calebynhan/mcring/hardware/cad/fit_report.md

# mcring stage-1 enclosure — fit report

Generated by `mcring_stage1.py` from `hardware/pcb/board_params.json` (inner_d = 20.0 mm, lens_d = 4.6 mm). Result: **PASS** (intersections all 0, clearances ok, wall probes ok).

The wall probes are line samples at the places listed below, not a global thickness analysis. Known spots thinner than the 1.2 mm wall rule, by design: the 0.4 / 0.7 mm rebate rim under the lid detent groove, the 0.7 mm wall around the switch key's counterbore, the first ~1.3 mm of each wire channel where it leaves the open groove at the slab's bottom corner, the floor beside the charging-wire groove where it skims the cell- and LRA-pocket rims, the 0.8 mm resin over the touch pad, and the 1.0 mm speaker grille plate (the pocket's +Y face, 5 × Ø1.0 holes).

## Stack (Z above the finger skin, mm)

| level | z |
|---|---|
| pocket floor (band wall) | 1.20 |
| sub-board floor (cell pocket top) | 4.60 |
| board bottom (ledges) | 6.10 |
| board top | 6.70 |
| lid underside | 9.90 |
| lid top | 11.10 |
| pod underside (bore relief 0.5) | 0.50 |
| pod floor | 1.70 |
| OV2640 head bottom / top | 2.00 / 10.50 |
| lens axis | 6.25 |
| pod ceiling (head top + FPC fold) | 11.50 |
| pod roof top | 12.70 |
| speaker pocket bottom (slab bottom + 1.3) | -1.70 |
| speaker axis | 3.50 |
| speaker rim top / lid boss underside | 8.50 / 8.70 |
| speaker slot top = bump shelf = lid underside | 9.90 |

## Speaker LS1 (optional, `speaker_mm`)

* part: PUI Audio AS01008MR-2-R — Ø10 x 2.9 mm max, 8 Ω, 300 mW rated / 500 mW max, 86 dB, top port, NdFeB magnet, solder-pad terminals (netlist LS1, off-board; alt. any 10 mm 8 Ω micro speaker); its two leads end in a Pico-EZmate plug; placeholder Ø10.0 × 2.9 mm disc standing in the XZ plane, axis along Y, centre board (18.45, 24.8, -3.2 from the board top) = world X -5.20, Y 13.40, Z 3.50 above the skin; rim Z -1.50..8.50 above the skin, back face Y 11.95 (+0.25 from the bay's inner wall plane), front face Y 14.85
* pocket: U-slot Ø10.4 (0.2 radial clearance) about the axis, straight walls above the axis up to the lid underside (drop-in from the top), depth 3.2 along Y (0.1 behind the back face, 0.2 in front); X -10.4..0.0, Y 11.85..15.05, bottom -1.70 above the skin (1.3 above the slab bottom)
* +Y wall bump: 3.15 mm over X -11.6..1.2 (12.8 long = pocket + two 1.2 end walls), full slab height, top cut down to the lid underside (shelf); the signet is 28.95 wide there (asymmetric: +Y side only); outer corners r 1.0, bottom edge r 0.6
* grille: 5 × Ø1.0 holes (centre + 4 on a Ø5 ring at 45°) through the 1.0 mm +Y plate = 3.9 mm² open (5 % of the Ø10 disc)
* back volume: above the sub-board floor (4.60) the slot's back is open to the bay over its full width, so the lidded bay (~1.4 cm³ minus parts) is the back volume and the terminals/leads pass straight through; below the floor the pocket is a recess in the solid slab with a lead groove 6 wide × 1.0 deep in its back wall (Y 10.85..11.85, Z -0.7..floor) for terminals in the lower half of the disc
* leads: the speaker's pigtail (two 28 AWG wires ending in a Pico-EZmate plug) leaves the back terminals into the sub-board cavity (Z 4.6..6.1 above the skin, under the board's +Y edge), runs ≈ 3.4 mm to the J5 edge notch at board x 21.8 and climbs the wall gap to the J5 header on the board top (allow 10 mm)
* lid: tab X -11.3..0.9 × Y 12.05..15.90 (1.2 thick, 0.15 inside the bump face, 0.3 from the bump's end walls) rests on the shelf; boss X -10.1..-0.3 × Y 12.15..14.75 under it fills the slot down to 8.70 above the skin = 0.2 mm above the speaker rim (the lid holds the speaker; a foam pad or a drop of glue takes up the play). The +Y detent groove is interrupted over the bump (X -11.6..1.2).
* antenna: 3-D gap speaker ↔ flex antenna placeholder 6.73 mm (keep-out 5.0); mass +1.0 g speaker

## Plug-in connectors (`connectors_top_mm`, `edge_notches_mm`)

The owner solders nothing: the cell, the charging-pad pigtail, the LRA and the speaker plug into four Molex Pico-EZmate headers on the board TOP (right strip), and each pigtail drops through a notch in the board's right edge into the sub-board cavity. Checked here: the mated plug + wire bend (placeholder `plugs`) clears the lid, the mic tube and the wall; the wall gap beside each notch is open from plug height to the floor; the cell lead channel and the charging-wire floor groove are open along their length and keep >= 1.2 mm of floor under them.

| header | feeds | header centre (board x, y) | notch (board x, right edge) | plug/bend envelope (world X, Y, Z) | wire path |
|---|---|---|---|---|---|
| J4 (LRA) | LRA M1 (Ø8 x 2.5 in the floor pocket under the front-right of the board) | 7.65, 19.45 | x 7.65, 2.4 x 1.1 | X 4.30..6.90, Y 10.30..11.65, Z 6.70..8.25 above the skin | LRA pocket at X 7.8, Y 3.5 -> +Y under the board edge -> notch |
| J3 (CHG) | charging-pad pigtail to the two inner-band contacts CP1/CP2 (floor wire groove from the -y channel exits) | 12.4, 19.45 | x 12.4, 2.4 x 1.1 | X -0.45..2.15, Y 10.30..11.65, Z 6.70..8.25 above the skin | two Ø1.1 channels from the band ribs surface beside the -Y wall, then the 1.2 x 0.8 floor groove (3 legs) to the notch |
| J1 (BAT) | cell BT1 (301012, tabs toward +y, lead channel from the pocket's +y edge) | 17.1, 19.45 | x 17.1, 2.4 x 1.1 | X -5.15..-2.55, Y 10.30..11.65, Z 6.70..8.25 above the skin | cell tabs toward +Y, 3 x 0.8 lead channel from the pocket's +Y edge to the wall at X -3.85 |
| J5 (SPK) | speaker LS1 in the right-wall pocket (its back is open to the bay above the floor) | 21.8, 19.45 | x 21.8, 2.4 x 1.1 | X -9.85..-7.25, Y 10.30..11.65, Z 6.70..8.25 above the skin | speaker pocket (right wall, back open to the bay above the floor) -> cavity -> notch |

**Charging pigtail (W2) wire runs** along the modelled path, window centre → mated J3 plug, no slack (band rib groove + slab channel + floor groove + climb up the notch to the header top):

* -Y pad (rib A): 21.4 + 7.8 + 27.6 + 4.5 = **61.3 mm**
* +Y pad (rib B, round the bottom): 31.6 + 7.8 + 29.6 + 4.5 = **73.5 mm**

Cut W2 to **≥ 85 mm per wire** (longest run + 10 mm for the bend into the plug and the trim at the window). Half of a 100 mm 36920-0201 (≈ 50 mm) does not reach; half of a 300 mm 36920-0203 (≈ 150 mm) does.

## Placeholder vs shell / lid intersection volumes (mm³, must be 0)

| placeholder | ∩ shell | ∩ lid |
|---|---|---|
| PCB | 0.0000 | 0.0000 |
| module | 0.0000 | 0.0000 |
| camera | 0.0000 | 0.0000 |
| FPC1 | 0.0000 | 0.0000 |
| camera_FPC | 0.0000 | 0.0000 |
| cell | 0.0000 | 0.0000 |
| LRA | 0.0000 | 0.0000 |
| switch | 0.0000 | 0.0000 |
| key | 0.0000 | 0.0000 |
| LED | 0.0000 | 0.0000 |
| mic | 0.0000 | 0.0000 |
| bottom_parts | 0.0000 | 0.0000 |
| top_parts | 0.0000 | 0.0000 |
| plugs | 0.0000 | 0.0000 |
| antenna | 0.0000 | 0.0000 |
| pigtail | 0.0000 | 0.0000 |
| speaker | 0.0000 | 0.0000 |
| lid ∩ shell | 0.0000 | — |

## Placeholder pairs (mm³, must be 0)

| a | b | ∩ |
|---|---|---|
| PCB | module | 0.0000 |
| PCB | camera | 0.0000 |
| PCB | FPC1 | 0.0000 |
| PCB | camera_FPC | 0.0000 |
| PCB | cell | 0.0000 |
| PCB | LRA | 0.0000 |
| PCB | switch | 0.0000 |
| PCB | key | 0.0000 |
| PCB | LED | 0.0000 |
| PCB | mic | 0.0000 |
| PCB | bottom_parts | 0.0000 |
| PCB | top_parts | 0.0000 |
| PCB | plugs | 0.0000 |
| PCB | antenna | 0.0000 |
| PCB | pigtail | 0.0000 |
| PCB | speaker | 0.0000 |
| module | camera | 0.0000 |
| module | FPC1 | 0.0000 |
| module | camera_FPC | 0.0000 |
| module | cell | 0.0000 |
| module | LRA | 0.0000 |
| module | switch | 0.0000 |
| module | key | 0.0000 |
| module | LED | 0.0000 |
| module | mic | 0.0000 |
| module | bottom_parts | 0.0000 |
| module | top_parts | 0.0000 |
| module | plugs | 0.0000 |
| module | antenna | 0.0000 |
| module | pigtail | 0.0000 |
| module | speaker | 0.0000 |
| camera | FPC1 | 0.0000 |
| camera | camera_FPC | 0.0000 |
| camera | cell | 0.0000 |
| camera | LRA | 0.0000 |
| camera | switch | 0.0000 |
| camera | key | 0.0000 |
| camera | LED | 0.0000 |
| camera | mic | 0.0000 |
| camera | bottom_parts | 0.0000 |
| camera | top_parts | 0.0000 |
| camera | plugs | 0.0000 |
| camera | antenna | 0.0000 |
| camera | pigtail | 0.0000 |
| camera | speaker | 0.0000 |
| FPC1 | camera_FPC | 0.0000 |
| FPC1 | cell | 0.0000 |
| FPC1 | LRA | 0.0000 |
| FPC1 | switch | 0.0000 |
| FPC1 | key | 0.0000 |
| FPC1 | LED | 0.0000 |
| FPC1 | mic | 0.0000 |
| FPC1 | bottom_parts | 0.0000 |
| FPC1 | top_parts | 0.0000 |
| FPC1 | plugs | 0.0000 |
| FPC1 | antenna | 0.0000 |
| FPC1 | pigtail | 0.0000 |
| FPC1 | speaker | 0.0000 |
| camera_FPC | cell | 0.0000 |
| camera_FPC | LRA | 0.0000 |
| camera_FPC | switch | 0.0000 |
| camera_FPC | key | 0.0000 |
| camera_FPC | LED | 0.0000 |
| camera_FPC | mic | 0.0000 |
| camera_FPC | bottom_parts | 0.0000 |
| camera_FPC | top_parts | 0.0000 |
| camera_FPC | plugs | 0.0000 |
| camera_FPC | antenna | 0.0000 |
| camera_FPC | pigtail | 0.0000 |
| camera_FPC | speaker | 0.0000 |
| cell | LRA | 0.0000 |
| cell | switch | 0.0000 |
| cell | key | 0.0000 |
| cell | LED | 0.0000 |
| cell | mic | 0.0000 |
| cell | bottom_parts | 0.0000 |
| cell | top_parts | 0.0000 |
| cell | plugs | 0.0000 |
| cell | antenna | 0.0000 |
| cell | pigtail | 0.0000 |
| cell | speaker | 0.0000 |
| LRA | switch | 0.0000 |
| LRA | key | 0.0000 |
| LRA | LED | 0.0000 |
| LRA | mic | 0.0000 |
| LRA | bottom_parts | 0.0000 |
| LRA | top_parts | 0.0000 |
| LRA | plugs | 0.0000 |
| LRA | antenna | 0.0000 |
| LRA | pigtail | 0.0000 |
| LRA | speaker | 0.0000 |
| switch | key | 0.0000 |
| switch | LED | 0.0000 |
| switch | mic | 0.0000 |
| switch | bottom_parts | 0.0000 |
| switch | top_parts | 0.0000 |
| switch | plugs | 0.0000 |
| switch | antenna | 0.0000 |
| switch | pigtail | 0.0000 |
| switch | speaker | 0.0000 |
| key | LED | 0.0000 |
| key | mic | 0.0000 |
| key | bottom_parts | 0.0000 |
| key | top_parts | 0.0000 |
| key | plugs | 0.0000 |
| key | antenna | 0.0000 |
| key | pigtail | 0.0000 |
| key | speaker | 0.0000 |
| LED | mic | 0.0000 |
| LED | bottom_parts | 0.0000 |
| LED | top_parts | 0.0000 |
| LED | plugs | 0.0000 |
| LED | antenna | 0.0000 |
| LED | pigtail | 0.0000 |
| LED | speaker | 0.0000 |
| mic | bottom_parts | 0.0000 |
| mic | top_parts | 0.0000 |
| mic | plugs | 0.0000 |
| mic | antenna | 0.0000 |
| mic | pigtail | 0.0000 |
| mic | speaker | 0.0000 |
| bottom_parts | top_parts | 0.0000 |
| bottom_parts | plugs | 0.0000 |
| bottom_parts | antenna | 0.0000 |
| bottom_parts | pigtail | 0.0000 |
| bottom_parts | speaker | 0.0000 |
| top_parts | plugs | 0.0000 |
| top_parts | antenna | 0.0000 |
| top_parts | pigtail | 0.0000 |
| top_parts | speaker | 0.0000 |
| plugs | antenna | 0.0000 |
| plugs | pigtail | 0.0000 |
| plugs | speaker | 0.0000 |
| antenna | pigtail | 0.0000 |
| antenna | speaker | 0.0000 |
| pigtail | speaker | 0.0000 |

## Clearances (mm, must be >= minimum)

| what | measured | minimum | ok |
|---|---|---|---|
| OV2640 head bottom -> pod floor | 0.30 | 0.30 | yes |
| OV2640 head top -> pod ceiling (FPC fold space) | 1.00 | 1.00 | yes |
| OV2640 head side -> pod side wall | 0.35 | 0.30 | yes |
| FPC fold top -> pod ceiling | 0.20 | 0.15 | yes |
| FPC vertical run behind the head -> bay interior front wall | 1.60 | 0.30 | yes |
| FPC wide contact end -> bay front wall | 0.10 | 0.05 | yes |
| module/u.FL back face -> antenna cavity back wall | 2.30 | 1.95 | yes |
| u.FL plug top -> lid underside | 0.30 | 0.30 | yes |
| switch key cap stand-off from the signet side (button travel) | 0.30 | 0.25 | yes |
| switch key flange inner face -> plunger tip (gap) | 0.02 | 0.00 | yes |
| speaker LS1 (NdFeB magnet) -> flex antenna, 3-D gap (metal keep-out) | 6.73 | 5.00 | yes |
| speaker LS1 -> u.FL pigtail, 3-D gap | 18.70 | 5.00 | yes |
| speaker LS1 -> cell, 3-D gap (through the slab wall) | 5.95 | 2.00 | yes |
| speaker LS1 -> LRA, 3-D gap | 5.98 | 2.00 | yes |
| speaker rim -> pocket wall (radial) | 0.20 | 0.15 | yes |
| speaker back face -> pocket back wall (below the floor) | 0.10 | 0.05 | yes |
| speaker front -> grille plate | 0.20 | 0.15 | yes |
| speaker top -> lid boss underside | 0.20 | 0.15 | yes |
| lid boss -> slot end walls (X) | 0.30 | 0.20 | yes |
| lid boss -> slot back / grille plate (Y) | 0.30 | 0.20 | yes |
| lid tab -> bump end walls (X) | 0.30 | 0.20 | yes |
| lid tab outer face -> bump face (Y) | 0.15 | 0.14 | yes |

## Wall probes (material thickness along a line through the shell, mm)

| where | measured | minimum | ok |
|---|---|---|---|
| floor under the cell pocket (X=cell centre, Y=0) | 1.20 | 1.20 | yes |
| floor under the cell pocket's back end (X=pocket back+0.3, Y=0) | 1.20 | 1.20 | yes |
| floor under the LRA pocket (centre) | 1.80 | 1.20 | yes |
| band wall at the bottom (X=0) | 1.20 | 1.20 | yes |
| band wall at 100 deg, beside the ribs (X=2) | 1.20 | 1.20 | yes |
| band + rib under the pad-wire groove A (100 deg) | 1.40 | 1.20 | yes |
| bay long wall (+Y, X=3, Z=board top+1) | 1.20 | 1.20 | yes |
| bay long wall rim at the lid groove (+Y, X=3) | 0.40 | 0.35 | yes |
| bay long wall (-Y, X=0, Z=board top+1) | 1.20 | 1.20 | yes |
| bay long wall rim beyond the groove (X=12) | 0.70 | 0.60 | yes |
| bay back wall behind the antenna cavity (Y=0, Z=board top+1) | 1.20 | 1.20 | yes |
| bay front wall beside the pod opening (Y=7) | 1.20 | 1.20 | yes |
| pod side wall (X=18, lens height) | 1.20 | 1.20 | yes |
| pod front wall beside the lens bore (Y=3.5) | 1.20 | 1.20 | yes |
| pod front corner, diagonal (+Y, lens height) | 1.28 | 1.20 | yes |
| pod front corner, diagonal (-Y, lens height) | 1.28 | 1.20 | yes |
| pod floor (X=18, Y=0) | 1.20 | 1.20 | yes |
| pod roof (X=18, Y=0) | 1.20 | 1.20 | yes |
| pod roof lip over the lid's front edge (X=lid edge+0.07, Y=0) | 1.20 | 1.20 | yes |
| pod roof lip + lid, vertical (X=lid edge-0.5, Y=0) | 1.45 | 1.20 | yes |
| wall between the cell pocket and the LRA pocket | 1.48 | 0.80 | yes |
| left wall above the switch counterbore (X=switch) | 1.20 | 1.20 | yes |
| left wall at the switch counterbore, beside the slot | 0.70 | 0.70 | yes |
| lid: mic tube wall, through the tube (lid part) | 1.00 | 0.90 | yes |
| band wall at the face X=-5.3 through the -25 deg pad window angle | 1.20 | 1.20 | yes |
| band wall at the face X=+5.3 through the -25 deg pad window angle | 1.20 | 1.20 | yes |
| band wall at the face X=-5.3 through the +25 deg pad window angle | 1.20 | 1.20 | yes |
| band wall at the face X=+5.3 through the +25 deg pad window angle | 1.20 | 1.20 | yes |
| skin beside wire channel X=-1.5 toward -Y (outer face) at Z=-1.0 | 3.17 | 1.20 | yes |
| skin beside wire channel X=-1.5 diagonal (-Y,-Z, bottom fillet) at Z=-1.0 | 2.19 | 1.20 | yes |
| skin beside wire channel X=-1.5 toward +Y (cell pocket) at Z=-1.0 | 3.43 | 1.20 | yes |
| skin beside wire channel X=-1.5 toward -Y (outer face) at Z=+0.0 | 2.92 | 1.20 | yes |
| skin beside wire channel X=-1.5 diagonal (-Y,-Z, bottom fillet) at Z=+0.0 | 3.47 | 1.20 | yes |
| skin beside wire channel X=-1.5 toward +Y (cell pocket) at Z=+0.0 | 3.43 | 1.20 | yes |
| skin beside wire channel X=-1.5 toward -Y (outer face) at Z=+1.5 | 2.53 | 1.20 | yes |
| skin beside wire channel X=-1.5 diagonal (-Y,-Z, bottom fillet) at Z=+1.5 | 3.60 | 1.20 | yes |
| skin beside wire channel X=-1.5 toward +Y (cell pocket) at Z=+1.5 | 3.03 | 1.20 | yes |
| skin beside wire channel X=-1.5 toward -Y (outer face) at Z=+3.5 | 2.02 | 1.20 | yes |
| skin beside wire channel X=-1.5 diagonal (-Y,-Z, bottom fillet) at Z=+3.5 | 3.02 | 1.20 | yes |
| skin beside wire channel X=-1.5 toward +Y (cell pocket) at Z=+3.5 | 3.43 | 1.20 | yes |
| skin beside wire channel X=-3.5 toward -Y (outer face) at Z=-1.0 | 3.17 | 1.20 | yes |
| skin beside wire channel X=-3.5 diagonal (-Y,-Z, bottom fillet) at Z=-1.0 | 2.19 | 1.20 | yes |
| skin beside wire channel X=-3.5 toward +Y (cell pocket) at Z=-1.0 | 3.43 | 1.20 | yes |
| skin beside wire channel X=-3.5 toward -Y (outer face) at Z=+0.0 | 2.92 | 1.20 | yes |
| skin beside wire channel X=-3.5 diagonal (-Y,-Z, bottom fillet) at Z=+0.0 | 3.47 | 1.20 | yes |
| skin beside wire channel X=-3.5 toward +Y (cell pocket) at Z=+0.0 | 3.43 | 1.20 | yes |
| skin beside wire channel X=-3.5 toward -Y (outer face) at Z=+1.5 | 2.53 | 1.20 | yes |
| skin beside wire channel X=-3.5 diagonal (-Y,-Z, bottom fillet) at Z=+1.5 | 3.60 | 1.20 | yes |
| skin beside wire channel X=-3.5 toward +Y (cell pocket) at Z=+1.5 | 3.03 | 1.20 | yes |
| skin beside wire channel X=-3.5 toward -Y (outer face) at Z=+3.5 | 2.02 | 1.20 | yes |
| skin beside wire channel X=-3.5 diagonal (-Y,-Z, bottom fillet) at Z=+3.5 | 3.02 | 1.20 | yes |
| skin beside wire channel X=-3.5 toward +Y (cell pocket) at Z=+3.5 | 3.43 | 1.20 | yes |
| speaker grille plate between the holes (X=spk, Z=spk+2.5) | 1.00 | 1.00 | yes |
| speaker grille plate between the holes (X=spk+3.5, Z=spk) | 1.00 | 1.00 | yes |
| slab under the speaker pocket (X=spk, Y=spk) | 1.30 | 1.20 | yes |
| bump end wall at the pocket's front (+X) end, speaker axis height | 1.20 | 1.20 | yes |
| bump end wall at the pocket's back (-X) end, speaker axis height | 1.20 | 1.20 | yes |
| bump end wall at the pocket's back (-X) end, slot top (Z=lid underside-0.5) | 1.20 | 1.20 | yes |
| bump bottom-front corner, diagonal from the pocket's front-bottom edge (X=spk) | 1.35 | 1.20 | yes |
| slab between the speaker pocket back and the cell pocket, through the lead groove (X=spk, Z=floor-1.5) | 4.65 | 1.20 | yes |
| slab between the speaker pocket back and the cell pocket, beside the groove (X=spk-4, Z=floor-1.5) | 6.15 | 1.20 | yes |
| slab behind the lead groove's bottom (X=spk, Y=spk back, Z=groove bottom-0.5 .. slab bottom) | 2.30 | 1.20 | yes |
| lid: tab + boss over the speaker (X=spk, Y=spk) (lid part) | 2.40 | 1.20 | yes |
| lid: tab over the bump shelf (X=spk, Y=bump face-0.5) (lid part) | 1.20 | 1.20 | yes |
| floor under the cell lead channel (X=J1, Y=channel mid) | 7.75 | 1.20 | yes |
| floor under wire groove leg 1 (mid-leg, down to the bore / slab bottom) | 6.88 | 1.20 | yes |
| floor under wire groove leg 2 (mid-leg, down to the bore / slab bottom) | 3.75 | 1.20 | yes |
| floor under wire groove leg 3 (mid-leg, down to the bore / slab bottom) | 6.75 | 1.20 | yes |
| pad window A (-Y) open at X=-1.5 (must be 0) | 0.00 | 0.00 | yes |
| pad window B (+Y) open at X=-3.5 (must be 0) | 0.00 | 0.00 | yes |
| speaker lead path: pocket back above the floor -> cavity under the J5 notch (must be 0) | 0.00 | 0.00 | yes |
| J4 pigtail drop beside the right board edge (notch at board x 7.65): plug height -> floor (must be 0) | 0.00 | 0.00 | yes |
| J3 pigtail drop beside the right board edge (notch at board x 12.4): plug height -> floor (must be 0) | 0.00 | 0.00 | yes |
| J1 pigtail drop beside the right board edge (notch at board x 17.1): plug height -> floor (must be 0) | 0.00 | 0.00 | yes |
| J5 pigtail drop beside the right board edge (notch at board x 21.8): plug height -> floor (must be 0) | 0.00 | 0.00 | yes |
| cell lead channel open from the pocket's +Y edge to the wall (under J1) (must be 0) | 0.00 | 0.00 | yes |
| floor wire groove leg 1 open along its length (must be 0) | 0.00 | 0.00 | yes |
| floor wire groove leg 2 open along its length (must be 0) | 0.00 | 0.00 | yes |
| floor wire groove leg 3 open along its length (must be 0) | 0.00 | 0.00 | yes |
| speaker grille centre hole open (X=spk, Z=spk) (must be 0) | 0.00 | 0.00 | yes |
| speaker slot open from the speaker rim up to the lid underside (X=spk, Y=spk) (must be 0) | 0.00 | 0.00 | yes |
| speaker lead groove open at the floor (X=spk, Y=groove centre) (must be 0) | 0.00 | 0.00 | yes |

## Finger contact

* the shell touches the nominal finger (Ø20.0) along the top (Y = 0) only for X -8.0..5.5 (13.5 mm: the 12 mm band plus the cell-pocket floor behind it) and along the bottom for X -5.5..5.5 (11.0 mm); the signet overhangs and the camera pod are relieved 0.5 mm above the skin line.
* the shell is 39.8 mm long along the finger; worn with the band against the knuckle, the pod front sits 17.1 mm beyond the band's front face toward the PIP joint — check on a hand.

## Envelope

* bounding box (X along the finger, Y across, Z up): -16.8..23.1 × -12.9..16.1 × -11.9..22.7 mm → 39.8 × 29.0 × 34.6 mm
* band OD 22.4 mm (inner 20.0, wall 1.2); 23.8 across the pad-wire rib
* signet (bay) footprint 31.5 × 25.8 mm (incl. the 2.0 mm antenna cavity), 28.95 wide across the speaker bump (X -11.6..1.2, +Y side), lid top 11.10 mm above the skin, pod roof 12.70 mm, 39.8 mm long along the finger including the camera pod

## Mass estimate

* shell 6.55 cm³ + lid 0.94 cm³ + key 0.015 cm³ of resin at 1.15 g/cm³ = **8.6 g**
* components 6.9 g (module 1.5, cell 0.9, LRA 1.2, PCB 0.6, camera 0.6, antenna 0.2, connectors+pigtails 0.4, misc 0.5, speaker 1.0)
* **total ≈ 15.5 g**
