calebynhan/mcring/hardware/pcb/floorplan.md

# mcring v1 — stage-1 PCB floorplan

Generated by `floorplan.py` (pure Python → SVG/PNG, no CAD). Drawings: `out/floorplan_top.*`,
`out/floorplan_bottom.*`, `out/stackup.*`. Numbers for the enclosure: `board_params.json`. Pick-and-place and
JLCPCB-format BOM for the assembler: `python3 export_cpl.py` → `out/mcring_v1_cpl.csv`, `out/mcring_v1_bom_jlc.csv`.
Reference designators and nets follow `hardware/electrical/out/mcring_v1_nets.md`.

**Design for assembly (no soldering by the owner).** The board is ordered assembled (double-sided PCBA,
`docs/10-ordering-assembled-boards.md`); every off-board part — cell, charging-pad pigtail, LRA, speaker — **plugs
into a 2-pin Molex Pico-EZmate header on the TOP** of a 4.8 mm strip added on the right (+y) side, and the camera
flex goes into a flip-lock ZIF (Hirose FH12). The assembled board has 73 placed parts and no wire pads except
the two optional bare pairs BZ1 (piezo, DNP) and J2 (aux experiment).

## 1. Board

| Item | Value |
|---|---|
| Outline | **26.5 × 22.8 mm**, rounded corners r = 1.5 mm, 2-layer FR-4 **0.6 mm**, ENIG; four **2.4 × 1.1 mm wire notches** in the right edge at x = 7.65, 12.40, 17.10, 21.80 |
| Orientation | x along the finger: **front edge = camera / FPC** (x = 0), **back edge = antenna / u.FL** (x = 26.5); y across the finger: **left edge = switch** (y = 0), **right edge = connector notches** (y = 22.8) |
| Module | ESP32-S3-MINI-1U 15.4 × 15.4 × 2.4, centre (18.8, 9.0) — 1.3 mm from the left edge, **not** centred: the 4.8 mm to its right is the connector strip; u.FL end **flush with the back edge** (pin positions along the three rows: **verify against the Espressif footprint**) |
| Camera axis | FPC1 centred on y = W/2 = 11.4 (the finger / pod axis); pin 1 at y = 5.65 |
| Top side | U1 module, FPC1 (24-pin 0.5 mm bottom-contact flip-lock ZIF), SW1 side switch, D1 WS2812B-2020 + R7, C3 100 µF 1206, TPAD1 3 × 4 touch landing with hatched GND ring (the touch **electrode** is a copper foil on the lid underside — §2), **4 × Pico-EZmate 78171-0002 headers** J4 LRA / J3 CHG / J1 BAT / J5 SPK (§2b), **8 test pads** (TP1 IO0, TP2 EN, TP3 D-, TP4 D+, TP5 GND, TP6 3V3, TP7 nCHG, TP8 VBAT) |
| Bottom side (≤ 1.15 mm) | everything else: U2–U11 (U10 MAX98357A + U11 its TPS22916 gate = the optional speaker amp), L1, D2, D3, Q1, MK1 mic (bottom-port, port through the board), 44 × 0402, 4 × 0603, bare pads BZ1a/b (piezo, optional) and J2a/b (aux) |
| Tallest top part | mated u.FL plug on the module ≈ 2.9 mm (module shield 2.4; connectors 1.55 mated; front strip x < 11.1: FPC1 2.0) |
| Why 26.5 long | 11.1 mm front strip (FPC1 4.0 + 1.0 actuator clearance + 5.6 for SW1/TPAD1/D1/C3/mic port) + 15.4 module |
| Why 22.8 wide | 18.0 (module 15.4 + 1.3 + 1.3 edges; FPC1 16 + 2 × 1.0) **+ 4.8 connector strip**: 0.5 module→header gap + 4.5 header depth + 1.1 notch/edge clearance. Cost: the signet grows 4.8 mm across the finger (`hardware/cad/fit_report.md`) |

## 2. Placement — top side

| Ref | Part | Centre x, y (mm) | w × h (mm) | Height | Note |
|---|---|---|---|---|---|
| U1 | ESP32-S3-MINI-1U-N4R2 | 18.80, 9.00 | 15.4 × 15.4 | 2.4 | u.FL end flush with the BACK edge; 1.3 mm to the LEFT edge, the connector strip on the RIGHT; GND pour + the module's own pads under the u.FL end are fine (no PCB antenna on the -1U) |
| FPC1 | 24-pin 0.5 mm FPC, bottom contact, flip-lock ZIF | 2.50, 11.40 | 4.0 × 16.0 | 2.0 | Hirose FH12-24S-0.5SH(55) flip-lock ZIF (alt. Amphenol F32R-1A7H1-11024 slider ZIF, same land pattern); FPC enters from the FRONT edge; keep x 4.5–5.5 free of parts > 0.6 mm for the actuator |
| SW1 | Omron B3U-3000P | 8.00, 1.45 | 3.0 × 2.5 | 1.2 | side-actuated, plunger out of the LEFT edge |
| TPAD1 | touch landing 3×4 mm copper + compliant contact | 8.10, 5.60 | 3.0 × 4.0 | 3.2 | landing for a conductive-foam block / spring finger (3.6 free, compressed to 3.2 by the lid) that reaches the 4×5 copper-foil electrode on the lid underside; hatched GND ring 0.5 mm away; NO copper under it on the bottom |
| D1 | WS2812B-2020 | 8.10, 10.00 | 2.0 × 2.0 | 0.9 | under the lid window |
| R7 | 0402 | 6.30, 10.00 | 1.0 × 0.5 | 0.35 | 1 kΩ WS2812 data series |
| C3 | 100 µF 1206 | 7.80, 13.00 | 3.2 × 1.6 | 1.8 | 3V3 bulk for capture/radio peaks |
| J4 | Pico-EZmate 2p (LRA) | 7.65, 19.45 | 4.2 × 4.5 | 1.55 | 78171-0002 2-ckt header, wires exit toward +y into the edge notch; LRA M1 (Ø8 x 2.5 in the floor pocket under the front-right of the board); LRA_P / LRA_N (U5 OUT+/OUT-) |
| J3 | Pico-EZmate 2p (CHG) | 12.40, 19.45 | 4.2 × 4.5 | 1.55 | 78171-0002 2-ckt header, wires exit toward +y into the edge notch; charging-pad pigtail to the two inner-band contacts CP1/CP2 (floor wire groove from the -y channel exits); CHG_PAD / GND |
| J1 | Pico-EZmate 2p (BAT) | 17.10, 19.45 | 4.2 × 4.5 | 1.55 | 78171-0002 2-ckt header, wires exit toward +y into the edge notch; cell BT1 (301012, tabs toward +y, lead channel from the pocket's +y edge); VBAT / GND |
| J5 | Pico-EZmate 2p (SPK) | 21.80, 19.45 | 4.2 × 4.5 | 1.55 | 78171-0002 2-ckt header, wires exit toward +y into the edge notch; speaker LS1 in the right-wall pocket (its back is open to the bay above the floor); SPK_P / SPK_N (U10 OUTP/OUTN); optional group |
| TP1 | TP 1.0 mm | 10.15, 9.00 | 1.0 × 1.0 | 0.0 | boot strap; hold to TP5 (GND) for download mode |
| TP5 | TP 1.0 mm | 10.15, 10.50 | 1.0 × 1.0 | 0.0 | USB GND / bench supply return |
| TP3 | TP 1.0 mm | 10.15, 12.00 | 1.0 × 1.0 | 0.0 | USB_DM IO19 — module front row (pin 23), short stub |
| TP4 | TP 1.0 mm | 10.15, 13.50 | 1.0 × 1.0 | 0.0 | USB_DP IO20 — module front row (pin 24), short stub |
| TP2 | TP 1.0 mm | 10.15, 15.00 | 1.0 × 1.0 | 0.0 | MCU_EN; pulse low to reset |
| TP6 | TP 1.0 mm | 10.15, 16.50 | 1.0 × 1.0 | 0.0 | buck output (also at C3) |
| TP8 | TP 1.0 mm | 5.20, 1.00 | 1.0 × 1.0 | 0.0 | bench supply 4.0 V in (with TP5) when no cell is fitted |
| TP7 | TP 1.0 mm | 5.20, 2.50 | 1.0 × 1.0 | 0.0 | BQ25100 /CHG, low while charging |

**Touch electrode on the lid, not on the board.** The lid underside is 2.9 + 0.3 = 3.2 mm
above the board, so a bare copper pad on the board would sit 4 mm (air + 0.8 resin) behind the touch surface — a
12 mm² electrode that far behind the dielectric has negligible finger coupling and `trigger.cpp`'s +25 % threshold
would never fire. Instead: a 4 × 5 mm copper-foil pad (copper foil 0.05-0.07 mm with conductive adhesive (3M 1181 class), cut 4 x 5 mm) is stuck to the
**lid underside** centred on (8.1, 5.6), under the CAD's 4 × 5 × 0.4 touch dimple, which leaves 0.8 mm of resin
between the foil and the thumb. TPAD1 on the board is the 3 × 4 copper landing for a compliant conductor — a conductive-foam
block 3 × 4 × 3.6 mm (or an SMT spring finger of similar free height) that the lid compresses to 3.2 mm — so the
electrode is wired to IO8 through R13 without any flying lead. Guard ring: hatched top copper 0.3 mm wide, 0.5 mm
from the landing, no copper under it on the bottom layer. LED window Ø3 in the lid above D1 (8.1, 10.0). Mic port hole
Ø0.6 through the board at (8.1, 15.3) with an Ø0.8 lid hole above it (nothing else on the top side within 0.9 mm; the
mic moved 0.55 toward −y so the lid's Ø1.8 tube clears the J4 header).

**Test pads on the top side.** TP1–TP6 (IO0, GND, D−, D+, EN, 3V3) form a column at x = 10.15, 0.45 mm in front of the
module's front row, 1.5 mm pitch; TP8 (VBAT) and TP7 (nCHG) sit at x = 5.2 beside FPC1 (0 mm tall, so the actuator swing
zone is fine). All eight are reachable with the board seated on its ledges and the lid off — flashing over USB, holding IO0,
pulsing EN, bench-powering from VBAT/GND and the cradle/nCHG check never need the board lifted.

### 2b. Plug-in connectors (right strip, y 17.2–21.7)

Four **Molex Pico-EZmate 78171-0002** (1.20 mm pitch, 2 circuits, vertical SMT header, side friction locks, **1.55 mm
mated**; mating housing 78172-0002, pre-made cable 36920-0203 (300 mm, 28 AWG, plug both ends: cut in half = two 150 mm pigtails; the charging pigtail needs ≈ 85 mm per wire, so the 100 mm 36920-0201 only serves the cell / LRA / speaker); alternative BM02B-ACHSS-GAN-ETF (JST ACH, 1.4 mm, housing ACHR-02V-S, jumpers ASACHSACH28W51..305; W305 for the charging pigtail)). Header outline
4.2 along the pin row × 4.5 in the plug/wire direction (from the published 3-circuit 5.4 × 4.5 — **verify against the Molex
drawing**, including which end the plug's wires leave: they must point at the notch). The headers sit 0.5 mm beyond the
module's right row (fan the module's side pads out under the module and via down) and 1.1 mm from the right edge; each has a
2.4 × 1.1 **notch in the board edge** straight ahead of it (no copper within 0.3 mm), so the pigtail's two wires run ≈ 1 mm over the
board side by side, bend down through the notch (notch + 0.3 bay clearance = 1.4 mm of room for a Ø1.0 28 AWG wire) and reach the part
under the board. Plug / unplug with the board seated and the lid off; the plugs are below the module's shield (2.4 mm).

| Ref | Plugs in | Nets | Header centre x, y | Notch (right edge) | Wire path |
|---|---|---|---|---|---|
| J4 (LRA) | LRA M1 (Ø8 x 2.5 in the floor pocket under the front-right of the board) | LRA_P / LRA_N (U5 OUT+/OUT-) | 7.65, 19.45 | 2.4 × 1.1 at x = 7.65 | LRA pigtail from the floor pocket under the front-right of the board, +y under the board edge, up the notch |
| J3 (CHG) | charging-pad pigtail to the two inner-band contacts CP1/CP2 (floor wire groove from the -y channel exits) | CHG_PAD / GND | 12.40, 19.45 | 2.4 × 1.1 at x = 12.40 | charging pigtail from the two channel exits (board x 14.75 / 16.75, y 0.7) in the 1.2 × 0.8 floor groove: along the −y edge, across at x 10.25, along the +y edge to the notch |
| J1 (BAT) | cell BT1 (301012, tabs toward +y, lead channel from the pocket's +y edge) | VBAT / GND | 17.10, 19.45 | 2.4 × 1.1 at x = 17.10 | cell pigtail: tabs toward +y, through the 3 × 0.8 lead channel from the pocket's +y edge to the wall, up the notch |
| J5 (SPK) | speaker LS1 in the right-wall pocket (its back is open to the bay above the floor) | SPK_P / SPK_N (U10 OUTP/OUTN); optional group | 21.80, 19.45 | 2.4 × 1.1 at x = 21.80 | speaker pigtail through the right-wall opening (above the floor) into the cavity, up the notch |

The two remaining bare pad pairs are **BZ1a/b** (piezo PZ1 — optional, DNP, no pocket in the enclosure) and **J2a/b** (aux
VBAT + open drain, the air-puff bench experiment). Neither is part of the ring build.

## 3. Placement — bottom side

| Ref | Part | Centre x, y (mm) | w × h (mm) | Height | Note |
|---|---|---|---|---|---|
| C9 | 0402 | 1.80, 1.50 | 0.5 × 1.0 | 0.35 | 1 µF U2 VIN |
| U2 | TPS22916C DSBGA-4 | 3.20, 1.50 | 1.2 × 0.9 | 0.6 | camera rail load switch, ON = IO21 |
| C10 | 0402 | 4.50, 1.50 | 1.0 × 0.5 | 0.35 | 1 µF CAM_3V3 at U2 out |
| R17 | 0402 | 4.50, 2.70 | 1.0 × 0.5 | 0.35 | 100k CAM_PWR_EN pull-down |
| C11 | 0402 | 1.80, 3.40 | 0.5 × 1.0 | 0.35 | 1 µF CAM_2V8 at U3 out |
| R16 | 0402 | 1.80, 4.70 | 0.5 × 1.0 | 0.35 | 10k CAM_RESET pull-up (CAM_3V3) |
| C14 | 0402 | 1.80, 6.00 | 0.5 × 1.0 | 0.35 | 100n CAM_RESET delay |
| C12 | 0402 | 1.80, 7.30 | 0.5 × 1.0 | 0.35 | 1 µF CAM_1V2 at U4 out |
| R5 | 0402 | 1.00, 6.30 | 0.5 × 1.0 | 0.35 | 4.7k SIOD pull-up (FPC pin 3) |
| C13 | 0402 | 1.00, 7.60 | 0.5 × 1.0 | 0.35 | 100n AVDD at FPC pin 4 |
| R6 | 0402 | 1.00, 8.90 | 0.5 × 1.0 | 0.35 | 4.7k SIOC pull-up (FPC pin 5) |
| C24 | 0402 | 1.00, 10.20 | 0.5 × 1.0 | 0.35 | 100n DOVDD at FPC pin 11 |
| U3 | XC6206P282MR SOT-23 | 3.70, 4.20 | 2.9 × 1.6 | 1.15 | AVDD LDO |
| U4 | XC6206P122MR SOT-23 | 3.70, 6.30 | 2.9 × 1.6 | 1.15 | DVDD LDO (DNP if the head regulates DVDD) |
| BZ1a | pad | 6.30, 1.20 | 1.2 × 1.2 | 0.0 | piezo wire (BUZZ_DRV) — optional PZ1 (DNP), bare pad kept |
| BZ1b | pad | 8.30, 1.20 | 1.2 × 1.2 | 0.0 | piezo wire return (GND) |
| C22 | 0402 | 10.20, 1.30 | 1.0 × 0.5 | 0.35 | 100n BUTTON filter |
| R15 | 0402 | 9.00, 2.60 | 1.0 × 0.5 | 0.35 | 100 Ω piezo series |
| R13 | 0402 | 10.30, 5.60 | 0.5 × 1.0 | 0.35 | 1k touch series — just outside the pad |
| MK1 | TDK T3902 PDM mic (bottom port) | 8.10, 15.30 | 2.65 × 3.5 | 0.98 | bottom-port mic mounted on the BOTTOM; its port hole goes THROUGH the board and the lid hole sits above |
| C19 | 0402 | 5.80, 15.90 | 1.0 × 0.5 | 0.35 | 100n mic VDD |
| U9 | TPS22916C DSBGA-4 | 10.30, 15.50 | 1.2 × 0.9 | 0.6 | WS2812 supply gate 3V3→VLED, ON = IO33 (LED_PWR_EN) |
| C20 | 0402 | 10.30, 14.30 | 1.0 × 0.5 | 0.35 | 100n VLED |
| C21 | 0402 | 10.30, 16.80 | 1.0 × 0.5 | 0.35 | 1 µF VLED |
| C1 | 0603 | 11.60, 3.30 | 1.6 × 0.8 | 0.95 | 10 µF buck input |
| L1 | 2.2 µH 2016 (DFE201610E) | 13.70, 3.30 | 2.0 × 1.6 | 1.0 | buck inductor — tight loop with U8/C2 |
| C2 | 0603 | 15.80, 3.30 | 1.6 × 0.8 | 0.95 | 10 µF buck output |
| U8 | TPS62840DLC SOT-583 | 12.60, 5.60 | 2.1 × 1.6 | 0.6 | 3V3 buck |
| R12 | 0402 | 14.40, 5.30 | 1.0 × 0.5 | 0.35 | VSET (3.3 V code) |
| R8 | 0402 | 11.80, 6.90 | 1.0 × 0.5 | 0.35 | 1 M divider top (VBAT) |
| R9 | 0402 | 13.00, 6.90 | 1.0 × 0.5 | 0.35 | 1 M divider bottom |
| C23 | 0402 | 14.20, 6.90 | 1.0 × 0.5 | 0.35 | 100n BAT_SENSE |
| R2 | 0402 | 12.30, 7.90 | 1.0 × 0.5 | 0.35 | 10k IO0 pull-up |
| D2 | PESD5V0S1BB SOD-523 | 10.60, 20.90 | 1.2 × 0.8 | 0.6 | bidirectional TVS on CHG_PAD, ≈ 2.3 mm from the J3 via |
| D3 | PMEG2005EB SOD-523 | 12.00, 20.90 | 1.2 × 0.8 | 0.6 | Schottky CHG_PAD → CHG_IN (reversed-cradle protection), right after D2 |
| C7 | 0402 | 13.40, 20.90 | 1.0 × 0.5 | 0.35 | 1 µF charger IN |
| R11 | 0402 | 10.60, 19.75 | 1.0 × 0.5 | 0.35 | 11.5k PRE_TERM |
| U7 | BQ25100 DSBGA-6 | 12.30, 19.75 | 1.6 × 0.9 | 0.6 | charger 25 mA / 1 mA term, under J3 |
| R10 | 0402 | 14.00, 19.75 | 1.0 × 0.5 | 0.35 | 9.1k ISET |
| R19 | 0402 | 15.30, 19.75 | 1.0 × 0.5 | 0.35 | 100k nCHG pull-up |
| C8 | 0402 | 12.30, 18.60 | 1.0 × 0.5 | 0.35 | 1 µF charger OUT / VBAT (beside the J1 via) |
| U10 | MAX98357A 16-TQFN 3×3 | 21.30, 4.30 | 3.0 × 3.0 | 0.8 | I2S class-D amp, VDD = VAMP (gated), SD_MODE = VAMP; EP to the GND pour; OPTIONAL group |
| R22 | 0402 | 19.20, 3.10 | 0.5 × 1.0 | 0.35 | 1k I2S BCLK series → U10 pin 16 (bounds the ESD back-feed into the unpowered amp while VAMP is off) |
| R23 | 0402 | 19.20, 4.30 | 0.5 × 1.0 | 0.35 | 1k I2S LRCLK series → U10 pin 14 |
| R24 | 0402 | 19.20, 5.50 | 0.5 × 1.0 | 0.35 | 1k I2S DIN series → U10 pin 1 |
| R20 | 0402 | 21.00, 1.30 | 1.0 × 0.5 | 0.35 | 100k AMP_PWR_EN pull-down (IO34) |
| R21 | 0402 | 22.50, 1.30 | 1.0 × 0.5 | 0.35 | 100k gain select GAIN_SLOT→VAMP (3 dB; 0R = 6 dB bench option, DNP = 9 dB) |
| U11 | TPS22916C DSBGA-4 | 19.90, 7.00 | 1.2 × 0.9 | 0.6 | speaker amp rail gate 3V3→VAMP, ON = IO34 (AMP_PWR_EN) |
| C25 | 0603 | 21.60, 6.60 | 1.6 × 0.8 | 0.95 | 10 µF VAMP at U10 |
| C26 | 0402 | 23.00, 6.60 | 0.5 × 1.0 | 0.35 | 100n VAMP at U10 VDD pins |
| Q1 | AO3400A SOT-23 | 14.60, 9.30 | 2.9 × 1.6 | 1.15 | low-side N-FET, gate IO9 |
| R14 | 0402 | 17.00, 9.30 | 1.0 × 0.5 | 0.35 | 100k AUX_EN pull-down |
| J2a | pad | 14.20, 11.20 | 1.2 × 1.2 | 0.0 | VBAT to the aux load (bench experiment, bare pad kept) |
| J2b | pad | 15.80, 11.20 | 1.2 × 1.2 | 0.0 | open drain of Q1 |
| U5 | DRV2605L VSSOP-10 | 16.20, 13.60 | 3.0 × 3.0 | 1.1 | haptic driver 0x5A; OUT+/OUT- as a 0.3 mm pair to the J4 via (≈ 10 mm) |
| C15 | 0402 | 13.60, 12.60 | 0.5 × 1.0 | 0.35 | 1 µF DRV VDD |
| C16 | 0402 | 13.60, 14.00 | 0.5 × 1.0 | 0.35 | 1 µF DRV REG |
| R3 | 0402 | 18.20, 11.00 | 1.0 × 0.5 | 0.35 | 4.7k SDA pull-up |
| R4 | 0402 | 19.40, 11.00 | 1.0 × 0.5 | 0.35 | 4.7k SCL pull-up |
| U6 | LIS2DW12 LGA-12 2×2 | 20.30, 13.80 | 2.0 × 2.0 | 0.7 | accelerometer 0x18 (SA0=GND) |
| C17 | 0402 | 20.30, 15.50 | 1.0 × 0.5 | 0.35 | 100n LIS VDD |
| C18 | 0402 | 22.10, 13.80 | 1.0 × 0.5 | 0.35 | 100n LIS VDD_IO |
| C4 | 0603 | 20.40, 9.30 | 1.6 × 0.8 | 0.95 | 10 µF module 3V3 |
| C5 | 0402 | 21.00, 10.50 | 1.0 × 0.5 | 0.35 | 100n module 3V3 |
| R18 | 0402 | 21.40, 11.60 | 1.0 × 0.5 | 0.35 | 4.7k LED_PWR_EN pull-down |
| R1 | 0402 | 22.80, 15.40 | 1.0 × 0.5 | 0.35 | 10k EN pull-up |
| C6 | 0402 | 22.60, 16.60 | 1.0 × 0.5 | 0.35 | 1 µF EN delay |

The charger (U7, D2, D3, C7, C8, R10, R11, R19) sits directly under J3/J1 so the TVS is ≈ 2.3 mm from the J3 via and U7 OUT is beside
the J1 via; the DRV2605L drives J4 through a 10 mm 0.3 mm pair; the amp's OUTP/OUTN pair runs ≈ 15 mm up the back column to J5.

## 4. Keep-outs and zones

| Zone | Layers | Rectangle (x0, y0 – x1, y1) | Rule |
|---|---|---|---|
| u.FL end | both | (24.5, 0 – 26.5, 22.8) | **no copper keep-out** — the MINI-1U has no PCB antenna, and the module's GND 1–2 / 3V3 (3) and GND 43–44 / EN (45) pads are the ends of the two side rows, nearest the u.FL (verify on the footprint), so copper is *required* here: GND pour on both layers, normal fan-out of those pads; no DVP/XCLK/PCLK/PDM traces, no part other than U1. The pigtail leaves the plug over the back edge and runs down the inside of the bay's back wall |
| Antenna (enclosure) | — | — | flex dipole + pigtail **≥ 5.0 mm from the cell, the LRA and any other metal**, never under the module or across the DVP corridor; cable ≤ 50 mm |
| Connector strip | top | (5.3, 17.0 – 24.5, 22.8) | the four headers and their notches; GND pour, vias to the charger/DRV/amp, no signal traces under the notches, nothing within 0.3 mm of a notch on either side (checked) |
| Touch pad | bottom | (6.6, 3.6 – 9.6, 7.6) | no copper under TPAD1; R13 just outside it |
| FPC actuator swing | top | (4.5, 3.4 – 5.5, 19.4) | parts ≤ 0.6 mm only (R7 is fine) |
| DVP corridor | bottom | (1.4, 8.3 – 12.6, 13.4) | Y2–Y9, PCLK, HREF, VSYNC, XCLK only; the upper pins (17–22, y 13.65–16.15) fan into it between FPC1 and the mic; vias up to U1 in the last 1.5 mm |
| Under the module | top | module footprint | bare FR-4 under the shield (no silkscreen), ≥ 9 GND vias on the thermal pads |
| Back ledge (enclosure) | bottom | (x ≥ 23.6) | the CAD's back board ledge carries the board here at the sub-board level: no bottom-side part may reach it (checked by the script) |
| Front ledges (enclosure) | bottom | x < 0.7, y < 5.5 and y > 11.0 | the CAD's two front ledges leave the gap y 5.5–11.0 for the FPC-pin passives at x = 1.0 (`front_ledge_gap_y_mm`) |
| Floor wire groove (enclosure) | — | path [(17.4, 1.2), (10.25, 1.2), (10.25, 21.7), (12.4, 21.7)] | 1.2 × 0.8 groove in the sub-board floor for the charging wires; its cross-board leg at x 10.25 is the only floor between the LRA pocket (x ≤ 9.65) and the cell pocket (x ≥ 10.85) |
| Speaker pocket (enclosure) | — | right (+y) signet wall, board x 13.25–23.65, centre 2.0 mm outside the right edge | the Ø10.0 × 2.9 speaker LS1 stands vertically in a pocket cut into the +y wall (face pushed out 3.15 mm), grille facing +y, back open to the bay; pigtail through the wall to the J5 notch; its magnet stays ≥ 5 mm from the flex antenna — `board_params.json` → `speaker_mm` |

## 5. Layer usage

* **Top**: module footprint + fan-out, FPC1, SW1, D1/R7, C3, touch landing + GND hatch, the 8 test pads, the four
  Pico-EZmate headers (each with a via pair straight down to its bottom-side driver), GND pour. The DVP bus leaves FPC1 on
  the top layer, drops to the bottom corridor, and comes back up at the module's front-left pins.
* **Bottom**: all small ICs and passives, the two bare pad pairs, the DVP corridor, I²C, the power cluster; GND pour
  everywhere else, stitched to the top pour with vias every ≤ 3 mm.
* Design rules per `hardware/electrical/README.md` §5 (0.10/0.10 mm fine, 0.2 mm drill, NSMD DSBGA pads).
* 2 layers is tight: if the DVP + power fan-out does not close, the fallback is a 4-layer 0.6 mm stack
  (sig / GND / PWR / sig) with the same outline — nothing in `board_params.json` changes.

## 6. Route-critical nets

| Net | Rule |
|---|---|
| DVP Y2–Y9, PCLK, HREF, VSYNC, XCLK | corridor on the bottom, ≤ 15 mm, loosely matched (± 5 mm), no other signals in the corridor; XCLK/PCLK away from the antenna end |
| SCCB SIOD/SIOC | pull-ups R5/R6 at the connector, to CAM_3V3 (switched rail) |
| CAM power | 3V3 → U2 → CAM_3V3 → U3 (2.8 V) / U4 (1.2 V) → FPC1 pins 4/10/11; caps C13/C24 within 1 mm of the pins |
| Buck | C1 – U8 – L1 – C2 in a tight loop, SW_NODE minimal area, VOS sense from C2 |
| Charge input | J3 pin 1 (CHG_PAD) → via → D2 TVS (≈ 2.3 mm, clear of the notch) → D3 Schottky → U7 IN with C7; J3 pin 2 straight to the GND pour |
| VBAT | J1 pin 1 → via → C8 / U7 OUT → 0.4 mm trunk (≈ 14 mm) → U8 VIN → R8; J2a |
| I²C | IO5/IO6 → R3/R4 → U5, U6 — one short daisy chain on the right half |
| LRA OUT+/OUT− | 0.3 mm pair, U5 → vias → J4 (≈ 10 mm) |
| VLED / RGB_DATA | U9 → via → D1 (top); IO43 → R7 → D1 DIN |
| PDM CLK/DATA | IO42/IO41 → MK1 on the right-front, ≤ 10 mm |
| USB D−/D+ | IO19/IO20 (module pins 23/24, in the **front row**) → TP3/TP4 directly in front of that row at x = 10.15; the stub is the pin-to-pad run, routed as a pair on the top layer, ≤ 10 mm (expect 1–8 mm depending on where pins 23/24 sit along the row — verify on the footprint), nothing else on the nets |
| Touch | IO8 → R13 (1 kΩ) → TPAD1 landing → foam/spring contact → lid foil electrode; keep the trace short and away from the DVP corridor |
| I²S (optional speaker) | IO35/36/37 → R22/R23/R24 (1 kΩ series, the column at x 19.2 beside U10's pin-1/16 corner) → U10 BCLK/LRCLK/DIN (pins 16/14/1), 0.1 mm, 512 kHz / 16 kHz, no matching, no MCLK; the resistors bound the ESD-diode back-feed into the unpowered amp to ≤ 2.6 mA per pin while VAMP is off; AMP_PWR_EN IO34 → U11 ON + R20 |
| VAMP / SPK_P–SPK_N | 3V3 → U11 → C25 (10 µF) + C26 (100 nF, ≤ 1 mm from U10 VDD pins 7/8); OUTP/OUTN as a **0.3 mm pair** up the back column x 22–23.4 to the J5 vias (≈ 15 mm), GND pour both sides, ≥ 1 mm from SDA/SCL, IMU_INT1 and the PDM lines (filterless class D); U10 EP → GND pour with 2–4 vias |

## 7. Camera FPC pin order (assumed ESP32-CAM / Arducam M0031 — verify on the purchased head)

Pin 1 is at the LEFT end of FPC1 (low y); pitch 0.5 mm; contacts face the board (bottom-contact connector).

| Pin | Signal | Net / GPIO | y on board (mm) |
|---|---|---|---|
| 1 | NC |  | 5.65 |
| 2 | AGND | GND | 6.15 |
| 3 | SIOD | IO40 | 6.65 |
| 4 | AVDD 2.8 | CAM_2V8 (U3) | 7.15 |
| 5 | SIOC | IO39 | 7.65 |
| 6 | RESET | R16/C14 RC to CAM_3V3 | 8.15 |
| 7 | VSYNC | IO38 | 8.65 |
| 8 | PWDN | GND | 9.15 |
| 9 | HREF | IO47 | 9.65 |
| 10 | DVDD 1.2 | CAM_1V2 (U4, DNP if internal) | 10.15 |
| 11 | DOVDD 3.3 | CAM_3V3 (U2) | 10.65 |
| 12 | Y9 | IO48 | 11.15 |
| 13 | XCLK | IO10 | 11.65 |
| 14 | Y8 | IO11 | 12.15 |
| 15 | DGND | GND | 12.65 |
| 16 | Y7 | IO12 | 13.15 |
| 17 | PCLK | IO13 | 13.65 |
| 18 | Y6 | IO14 | 14.15 |
| 19 | Y2 | IO15 | 14.65 |
| 20 | Y5 | IO16 | 15.15 |
| 21 | Y3 | IO17 | 15.65 |
| 22 | Y4 | IO18 | 16.15 |
| 23 | NC |  | 16.65 |
| 24 | NC |  | 17.15 |

## 8. Stack (see `out/stackup.svg`)

skin → band wall 1.2 → cell 3.0 → cell-pocket slack 0.4 (CAD pocket 3.4 deep) → clearance 0.35 →
bottom parts 1.15 → PCB 0.6 → top parts 2.9 → clearance 0.3 → lid 1.2:
board bottom at z = 6.1, board top z = 6.7, lid underside z = 9.9,
**signet top z = 11.1 mm** above the skin (7.7 mm if the cell moves to the
palm-side thick zone of the band as in the old `.scad`). These are the enclosure's as-built numbers
(`hardware/cad/fit_report.md`: board bottom 6.10, lid top 11.10). The connectors did not change the stack: the 1.55 mm
mated headers sit on the top under the 3.2 mm lid gap, and the wires run in the floor groove / channels below the parts.

Camera pod (built by the CAD from `pod_mm`): floor z = 1.7 (band wall on the 0.5 bore relief), head 8.5 × 8.5 × 1.3
+ Ø4.5 × 4.5 barrel standing 0.3 above the floor → head z 2.0–10.5, **lens axis z = 6.25**, ceiling z = 11.5
(head top + 1.0 for the FPC fold), roof top z = 12.7 (+1.60 vs the bay lid; the roof lips back over the lid's front
edge). FPC loop 2.5 mm, interior depth 8.3 mm in front of the board edge (9.5 incl. the 1.2 wall),
interior width ≥ 9.2, bore Ø4.6 (reamed to the 4.5 barrel). Bay interior extends 2.0 mm behind the
board's back edge for the u.FL pigtail and the flex antenna. Side-switch slot through the left wall 3.4 × 1.6 mm.

## 9. Deviations from the task text / earlier notes

1. **Mic on the BOTTOM side**, not the top: the TDK T3902 is a bottom-port microphone, so the acoustic path is
   through the board. Mounted on the bottom at `mic_xy`, its port hole goes up through the PCB to a lid hole straight
   above — a top mount would have needed a sound channel under the board. Height 0.98 mm fits the bottom limit.
2. **Cell, charging pads, LRA and speaker on plug-in headers (J1, J3, J4, J5), not wire pads** — see §2b and item 15. The
   vertical JST SH header of the first netlist (4.25 mm) fits neither side; the 1.55 mm Pico-EZmate fits the top.
3. **top_max_height = 2.9 mm**, not 2.4: the mated u.FL plug on the module is taller than the shield can.
4. **bottom_max_height = 1.15 mm** (task: 1.1): VSSOP-10 and SOT-23 bodies are 1.10–1.15 max.
5. **8 test pads** (IO0, EN, USB D−, D+, GND, 3V3, nCHG, VBAT) per the electrical netlist, not 4 — and **on the top side**:
   the bottom face is unreachable once the board sits on its ledges (1.5 mm above the sub-board floor).
6. **SW2 (optional IO0 boot button, DNP) is not placed** — no top-side room; use TP1 (IO0) + TP5 (GND) / TP2 (EN).
7. GPIO use follows the post-fix `BOARD_MCRING_V1` (CAM_PWR = IO21, RGB = IO43, LED_PWR_EN = IO33, USB on 19/20).
8. Board is 26.5 × 22.8 instead of the old 26 × 12 bay: the 15.4 mm module and the 16 mm FPC connector set 18.0 of the width,
   the plug-in headers the remaining 4.8 (item 15).
9. **Touch electrode on the lid underside** (copper foil under the dimple) with a compliant contact on TPAD1, instead of a
   bare pad on the board 4 mm behind the touch surface (see §2). `schematic-notes.md`'s "3 × 4 mm copper area on the
   top face" is now the landing; the BOM/build guide need the foam block and the foil.
10. **No antenna copper keep-out on the board**: the earlier "no copper in the last 2 mm" rule was the PCB-antenna rule
    of the MINI-1; the MINI-1U has a u.FL, and its GND/3V3/EN pads sit in exactly that strip. Replaced by the u.FL-end and
    antenna-placement rules in §4.
11. **Stack / pod / bore / slot numbers are computed the way the CAD builds them** (`hardware/cad/mcring_stage1.py`, which
    reads `pod_mm.floor_relief_above_skin / head_clearance / fpc_fold_above_head` and `antenna_cavity_mm` from this JSON):
    cell pocket 3.4 deep (+0.4 slack) → lid top 11.1 not 10.7; pod floor on the 0.5 bore relief, head 0.3 above
    it, 1.0 FPC fold above the head → lens axis 6.25 not 5.5, roof 12.7 (+1.60 vs the lid) not 11.25;
    bore Ø4.6 not 4.7; switch slot 3.4 × 1.6 not 3.2 × 1.5. The CAD still hard-codes `cell_pocket`,
    `lens_d`, `lid_t` and `switch_slot` — it should read `stack_mm.cell_pocket_depth`, `pod_mm.bore_d`, `stack_mm.lid` and
    `switch_slot_mm` from this JSON so the two cannot drift again. `hardware/cad/fit_report.md` is the as-built check.
12. **D3** (PMEG2005EB Schottky, CHG_PAD → CHG_IN) is in the charger cluster under J3 (item 15).
13. **Optional speaker amp block** (voice-first, `hardware/electrical/README.md` §1 item 20): U10 MAX98357A 16-TQFN (3 × 3 × 0.8),
    U11 TPS22916, C25 10 µF, C26 100 nF, R20 100 kΩ, R21 100 kΩ (3 dB gain), R22–R24 1 kΩ I²S series (a column at x 19.2 beside
    U10's pin-1/16 corner) in the back-left block under the module (x 18.95–23.4, y 0.4–8.8); the speaker plugs into **J5** on the
    top-right (the SPK1a/b wire pads are gone). The OUTP/OUTN pair runs ≈ 15 mm up the back column — acceptable for a filterless
    class-D output, see §6. Check: nothing on the bottom reaches the CAD's back ledge (x ≥ 23.6).
14. **Speaker in the signet's RIGHT wall, not the left** (task text offered `signet_left_wall` / `band_side`): on the −y side the
    switch key (x 6.3–9.7) and the two charging-pad wire channels (x 14.75 / 16.75, climbing inside the −y shoulder) push a
    10.4 mm pocket behind x ≈ 17.7, whose back end lands 0.7 mm from the flex antenna's plane — an NdFeB magnet inside the 5 mm
    keep-out. The +y wall has nothing on it (mic port, LED and touch dimple are in the lid, the LRA pocket in the floor, both
    pad-wire ribs on −y). `speaker_mm`: centre board x 18.45, y 24.8 (2.0 outside the right edge), z -3.2
    from the board top (3.5 above the skin); Ø10.0 × 2.9; disc in the xz plane, grille normal +y; pocket
    x 13.25–23.65, 0.2 clearance, 1.0 grille wall → the signet's +y face grows 3.15 mm over that length; back open
    to the bay above the sub-board floor (bay = back volume), recess in the slab below it. "band_side" was rejected: 1.2 mm band
    wall with the finger behind it and no lead path except outside the band.
15. **Design for assembly (this revision).** (a) Board **22.8 wide**: a 4.8 mm TOP-side strip on the right carries four Molex
    Pico-EZmate 78171-0002 headers (J4 LRA, J3 CHG, J1 BAT, J5 SPK; 4.2 × 4.5 × 1.55 mated), each with a 2.4 × 1.1
    wire notch in the right edge; the module stays 1.3 mm from the left edge (not centred), FPC1 moves to the finger axis
    y = 11.4. Neither a Pico-EZmate (1.55) nor a JST ACH (1.4) fits the 1.15 mm bottom envelope, and the original top side had
    no 4.5 mm-deep spot, so the board grew rather than the stack (a 0.45 mm taller cavity would also have cost the pod-roof lip).
    (b) The bottom wire pads J1a/b, PAD1w/2w, M1a/b, SPK1a/b are **removed**; BZ1a/b and J2a/b stay as bare pads (optional /
    bench only). (c) The charger cluster moved under J3/J1 (TVS ≈ 2.3 mm from the J3 via); the camera-pin passives follow FPC1
    (+2.4 in y); the mic moved to y 15.3 so the lid tube clears J4; the DVP corridor is (1.4, 8.3 – 12.6, 13.4).
    (d) Enclosure inputs added to `board_params.json`: `connectors_top_mm` (header + plug envelopes), `edge_notches_mm`,
    `cell_tab_edge` +y with `cell_lead_channel_mm` under J1, `floor_wire_groove_mm` (1.2 × 0.8, path [(17.4, 1.2), (10.25, 1.2), (10.25, 21.7), (12.4, 21.7)])
    for the charging wires from the two Ø1.1 channel exits, `front_ledge_gap_y_mm` [5.5, 11.0], `wire_od_max_mm` 1.0 (28 AWG pigtails).
16. **FPC1 is the Hirose FH12-24S-0.5SH(55)** (flip-lock ZIF, bottom contact, 2.0 mm, LCSC C202112) — the KiCad land pattern the
    design always used; the Amphenol FCI F32R-1A7H1-11024 (slider ZIF, bottom contact, same pattern) is the alternate. Earlier
    text calling the F32R an "XKB back-flip" was wrong (the F32D is the back-flip/dual-contact sibling).

## 10. Checks performed by the script

* no overlaps, no edge/keep-out/height violations, no bottom part on the back ledge, connectors on top in the right strip, notches clear, floor groove between the pockets
