calebynhan/mcring/hardware/pcb/out/mcring_v1_pcba_notes.md

# mcring v1 — PCBA files: what `mcring_v1_cpl.csv` and `mcring_v1_bom_jlc.csv` assume

Generated by `hardware/pcb/export_cpl.py` from `floorplan.py` (positions) and `hardware/electrical/mcring_v1.py` (values, MPNs, LCSC numbers). How to use them: `docs/10-ordering-assembled-boards.md`.

## Coordinate frame and rotation

* Origin = the board's front-left corner seen from the top; X along the finger (0 = camera/FPC edge, 26.5 = antenna edge), Y across it (0 = switch edge, 22.8 = connector-notch edge); mm. Both layers in the top view (bottom parts are *not* mirrored).
* Before exporting Gerbers from the layout tool, put its drill/place origin on that corner with the same axes, or regenerate the CPL from the tool (KiCad: File → Fabrication Outputs → Component Placement, then rename Ref/PosX/PosY/Rot/Side to Designator/Mid X/Mid Y/Rotation/Layer).
* Rotation: 0 for every part except 0402s placed along y (90). The pin-1 orientation of the ICs, the module, FPC1 and the four Pico-EZmate headers is set at layout (each header's wire-exit end must face the right board edge / its notch, D1's DIN toward R7, D3's cathode toward U7, the mic's port over the board hole). JLCPCB re-orients polarised parts to their library footprint at DFM review — confirm every polarised part on their placement preview before approving.

## Counts

* 73 placed parts (10 top, 63 bottom), 31 BOM lines, ≈ 289 solder joints (pads of the placed parts, incl. the module's 65).
* BOM lines with an LCSC number: 14; consigned (not stocked by LCSC): 3; no C-number recorded: 14 (generic passives the JLCPCB BOM tool matches on value + package).

## Sourcing status per BOM line

| Comment | Designators | Footprint | LCSC Part # | Status |
|---|---|---|---|---|
| 10u | C1, C2, C4, C25 | 0603 | C77041 | LCSC C77041 |
| 100u | C3 | 1206 | — | no C-number recorded — let the JLCPCB BOM tool match the value + package (basic part where one exists), or paste the MPN |
| 100n | C5, C13, C14, C17, C18, C19, C20, C22, C23, C24, C26 | 0402 | C71629 | LCSC C71629 ((LCSC: not recommended for new designs — let the JLC BOM tool substitute a basic 0402 100 nF X7R 16 V)) |
| 1u | C6, C7, C8, C9, C10, C11, C12, C15, C16, C21 | 0402 | C76999 | LCSC C76999 |
| WS2812B-2020 | D1 | 2020 PLCC4 | C965555 | LCSC C965555 |
| PESD5V0S1BB,115 | D2 | SOD-523 | — | no C-number recorded — let the JLCPCB BOM tool match the value + package (basic part where one exists), or paste the MPN |
| PMEG2005EB,115 | D3 | SOD-523 | — | no C-number recorded — let the JLCPCB BOM tool match the value + package (basic part where one exists), or paste the MPN |
| FH12-24S-0.5SH(55) | FPC1 | FH12-24 0.5 mm horizontal | C202112 | LCSC C202112 |
| 78171-0002 | J1, J3, J4, J5 | Pico-EZmate 1x2 vertical | — | CONSIGN — Molex Pico-EZmate — not on LCSC; DigiKey / Mouser / RS (4 + spares); the matching pigtails are owner-side parts |
| DFE201610E-2R2M=P2 | L1 | 0806 | — | no C-number recorded — let the JLCPCB BOM tool match the value + package (basic part where one exists), or paste the MPN |
| T3902 | MK1 | T3902 3.5x2.65 bottom port | — | no C-number recorded — search the MPN on LCSC at order time; if absent, consign |
| AO3400A | Q1 | SOT-23 | C20917 | LCSC C20917 |
| 10k | R1, R2, R16 | 0402 | C60490 | LCSC C60490 |
| 4.7k | R3, R4, R5, R6, R18 | 0402 | C105871 | LCSC C105871 |
| 1k | R7, R13, R22, R23, R24 | 0402 | — | no C-number recorded — let the JLCPCB BOM tool match the value + package (basic part where one exists), or paste the MPN |
| 1M | R8, R9 | 0402 | — | no C-number recorded — let the JLCPCB BOM tool match the value + package (basic part where one exists), or paste the MPN |
| 9.1k | R10 | 0402 | — | no C-number recorded — let the JLCPCB BOM tool match the value + package (basic part where one exists), or paste the MPN |
| 11.5k | R11 | 0402 | — | no C-number recorded — let the JLCPCB BOM tool match the value + package (basic part where one exists), or paste the MPN |
| 267k | R12 | 0402 | — | no C-number recorded — let the JLCPCB BOM tool match the value + package (basic part where one exists), or paste the MPN |
| 100k | R14, R17, R19, R20, R21 | 0402 | — | no C-number recorded — let the JLCPCB BOM tool match the value + package (basic part where one exists), or paste the MPN |
| 100 | R15 | 0402 | — | no C-number recorded — let the JLCPCB BOM tool match the value + package (basic part where one exists), or paste the MPN |
| B3U-3000P | SW1 | B3U-3000P side switch | — | no C-number recorded — search the MPN on LCSC at order time; if absent, consign |
| ESP32-S3-MINI-1U-N4R2 | U1 | ESP32-S3-MINI-1U (65 pads) | — | CONSIGN — not on LCSC (only the N8 without PSRAM and the MINI-1 PCB-antenna variant) — Mouser / DigiKey / Espressif store |
| TPS22916CYFPR | U2, U9, U11 | DSBGA-4 0.4 mm (YFP) | — | CONSIGN — not on LCSC at the research snapshot (DigiKey 12-wk, Arrow) — order 3 + spares; or re-check live, TI stock moves |
| XC6206P282MR-G | U3 | SOT-23 | C2891263 | LCSC C2891263 |
| XC6206P122MR | U4 | SOT-23 | — | no C-number recorded — search the MPN on LCSC at order time; if absent, consign |
| DRV2605LDGST | U5 | VSSOP-10 3x3 | C425927 | LCSC C425927 |
| LIS2DW12TR | U6 | LGA-12 2x2 0.5 mm | C189624 | LCSC C189624 |
| BQ25100AYFPR | U7 | DSBGA-6 0.4 mm (YFP) | C2871910 | LCSC C2871910 |
| TPS62840DLCR | U8 | SOT-583-8 | C2071859 | LCSC C2071859 |
| MAX98357AETE+T | U10 | QFN-16 3x3 EP | C910544 | LCSC C910544 |

## Not in the CPL / BOM

### Copper features (no component)

* BZ1: two bare 1.2 mm pads (optional piezo, DNP)
* J2: two bare 1.2 mm pads (aux bench experiment)
* TPAD1: 3 x 4 mm copper landing (touch)
* TP1–TP8: 1.0 mm test pads on the top side

### Do-not-populate

* SW2 B3U-1000P (B3U-1000P): optional IO0 boot button (top-actuated), DNP
* U4 (XC6206P122MR, 1.2 V DVDD LDO) is populated in these files; make it DNP in the BOM upload if the purchased OV2640 head regulates DVDD itself (`hardware/electrical/README.md` §1 item 3)
* The optional speaker group U10/U11/C25/C26/R20–R24 is populated here; the J5 header stays either way

### Off-board (owner-supplied, plug in after delivery)

* ANT1 2.4 GHz flex antenna, MHF1 (146153-0050): 2.4 GHz flex dipole 34.9 x 9 x 0.1 mm, 50 mm MHF1 (u.FL) pigtail -> U1 u.FL (mated plug 2.9 mm tall = board_params top_max_height). Route down the back wall / along the band, >= 5 mm from cell and LRA; size vs the band is a fit check
* BT1 301012 LiPo 30 mAh (301012 (30 mAh, with PCM)): 3 x 10 x 12 mm LiPo cell with PCM, 1C max charge; leads terminated in the W1 Pico-EZmate plug by the cell seller, a cable shop or PCBWay (never hot air or flame near the pouch, docs/10 §7) and plugged into J1 — no solder on the board
* W1 Pico-EZmate 2-ckt pigtail (36920-0203 (300 mm, cut in half)): BAT: 28 AWG pre-crimped pigtail, plug into J1; bare end to the cell's two leads (≈ 25 mm, joint made by the supplier)
* W2 Pico-EZmate 2-ckt pigtail (36920-0203 (300 mm, cut in half)): CHG: 28 AWG pre-crimped pigtail, plug into J3; bare ends to CP1/CP2 through the band channels (≈ 85 mm per wire)
* CP1 charging contact 3x2 mm ENIG (no MPN): inner-band pogo contact, 3 x 2 mm ENIG, flush, >= 3 mm from the other pad; +5 V from the pogo cradle; the W2 pigtail's bare end is bonded to it with silver conductive pen after threading (<= 25 mA path; a contact fitted beforehand cannot pass the Ø1.1 band channel, docs/10 §7)
* CP2 charging contact 3x2 mm ENIG (no MPN): inner-band pogo contact, 3 x 2 mm ENIG, flush, >= 3 mm from the other pad; GND return; the W2 pigtail's bare end is bonded to it with silver conductive pen after threading (<= 25 mA path; a contact fitted beforehand cannot pass the Ø1.1 band channel, docs/10 §7)
* M1 LRA0825BC-0167F (LRA0825BC-0167F): 8 x 2.5 mm coin LRA, 240 Hz, 1.25 Vrms max (set RATED_V/OD_CLAMP for 1.25 Vrms @ 240 Hz, docs/07-build-guide.md §1.8); off-board in the floor pocket, leads -> W3 plug -> J4
* W3 Pico-EZmate 2-ckt pigtail (36920-0203 (300 mm, cut in half)): LRA: 28 AWG pre-crimped pigtail, plug into J4; bare end to the LRA's two leads (≈ 25 mm)
* PZ1 PKMCS0909E4000-R1 (PKMCS0909E4000-R1): 4 kHz piezo sounder 9 x 9 x 1.9 mm (LTB) — optional; fit only if the enclosure gets a 9 x 9 x 2 pocket (none in the current CAD); any 2-wire piezo element also works
* LS1 AS01008MR-2-R (AS01008MR-2-R): 10 mm x 2.9 mm (max) 8 ohm micro speaker, 300 mW rated / 500 mW max, 86 dB, top port, NdFeB magnet, solder pads; in the enclosure's speaker pocket (board_params.json speaker_mm), its leads -> W4 plug -> J5; polarity irrelevant (single driver)
* W4 Pico-EZmate 2-ckt pigtail (36920-0203 (300 mm, cut in half)): SPK: 28 AWG pre-crimped pigtail, plug into J5; bare end to the speaker's two terminals (≈ 15 mm)

### Plug-in headers and notches

| Header | Centre (X, Y) | Feeds | Notch in the right edge |
|---|---|---|---|
| J4 (LRA) | 7.65, 19.45 | LRA M1 (Ø8 x 2.5 in the floor pocket under the front-right of the board) | 2.4 × 1.1 mm centred on X = 7.65, Y = 22.8 (board outline feature, no copper within 0.3 mm) |
| J3 (CHG) | 12.40, 19.45 | charging-pad pigtail to the two inner-band contacts CP1/CP2 (floor wire groove from the -y channel exits) | 2.4 × 1.1 mm centred on X = 12.40, Y = 22.8 (board outline feature, no copper within 0.3 mm) |
| J1 (BAT) | 17.10, 19.45 | cell BT1 (301012, tabs toward +y, lead channel from the pocket's +y edge) | 2.4 × 1.1 mm centred on X = 17.10, Y = 22.8 (board outline feature, no copper within 0.3 mm) |
| J5 (SPK) | 21.80, 19.45 | speaker LS1 in the right-wall pocket (its back is open to the bay above the floor) | 2.4 × 1.1 mm centred on X = 21.80, Y = 22.8 (board outline feature, no copper within 0.3 mm) |
