calebynhan/mcring/docs/fundamentals/09-software-stack.md

# 9. Software stack

Three programs and three codecs make a voice turn: the FastAPI backend (`backend/app/*.py`, ~1 300 lines) that transcribes, asks Claude for structured JSON, and optionally speaks; the Expo/React Native companion (`app/src/*.ts(x)`, ~2 000 lines) that owns BLE, the microphones, the headphones and the ring speaker; the Python CLI (`tools/ring-cli`) that stands in for the phone; and `mcring_proto`/`mcring_adpcm`/`mcring_morse`, implemented three times (C, Python, TypeScript) and cross-tested to the byte. This chapter gives a builder who knows *some* programming the fundamentals needed to run, read and extend all of it: FastAPI and async Python, multipart uploads, the Claude API's
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
