calebynhan/mcring/hardware/cad/out/view_front.png

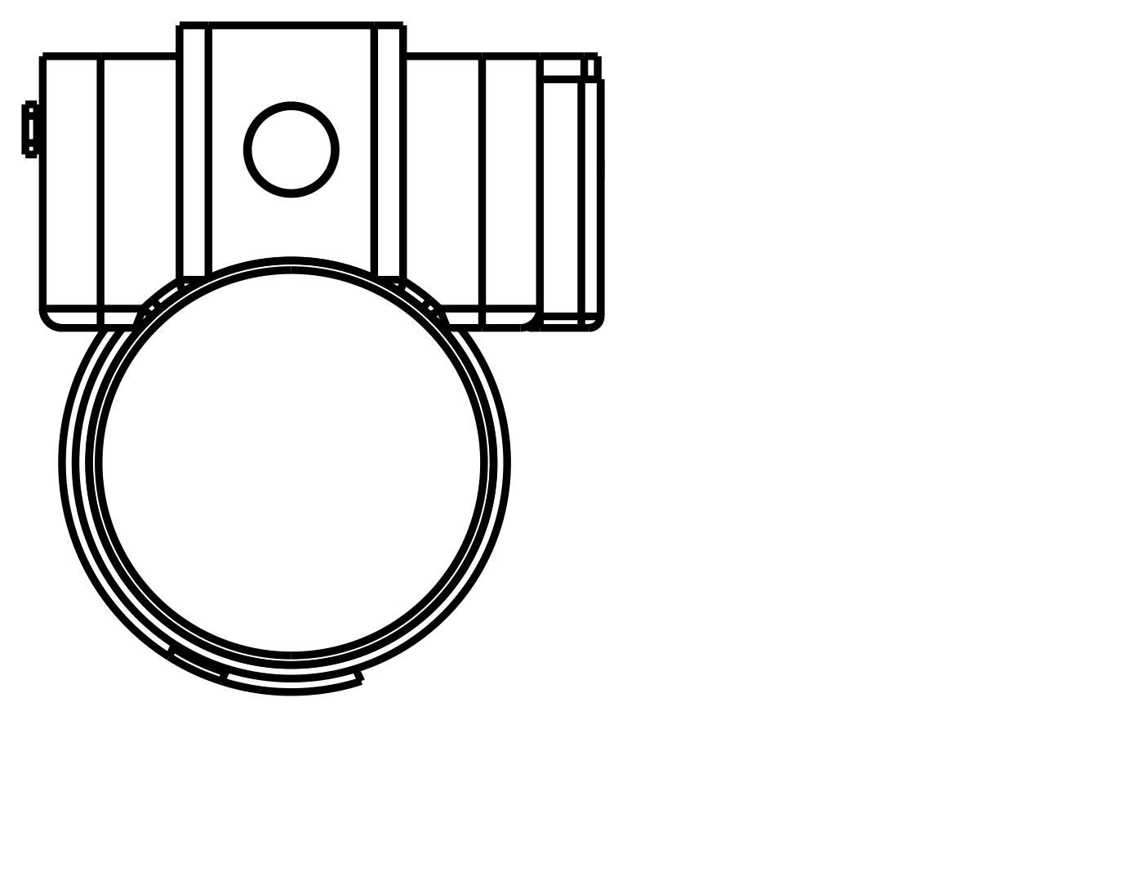
hardware/cad/out/view_front.png
