calebynhan/mcring/hardware/cad/out/view_right.png

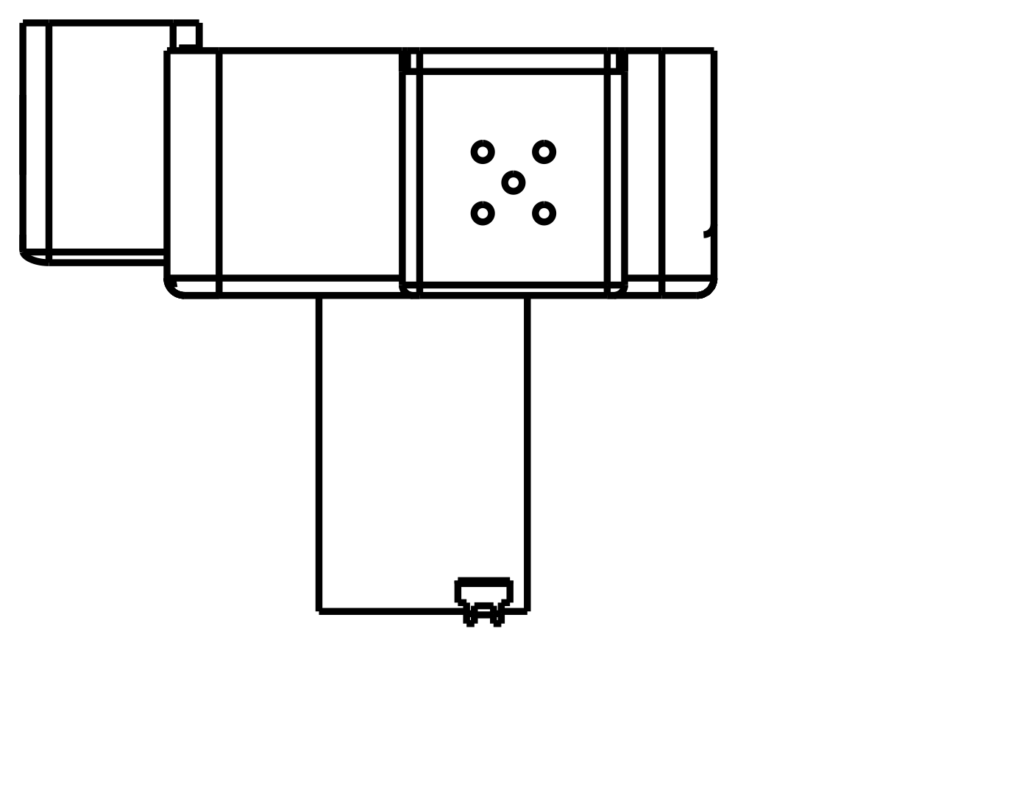
hardware/cad/out/view_right.png
