calebynhan/mcring/hardware/cad/out/view_section.png

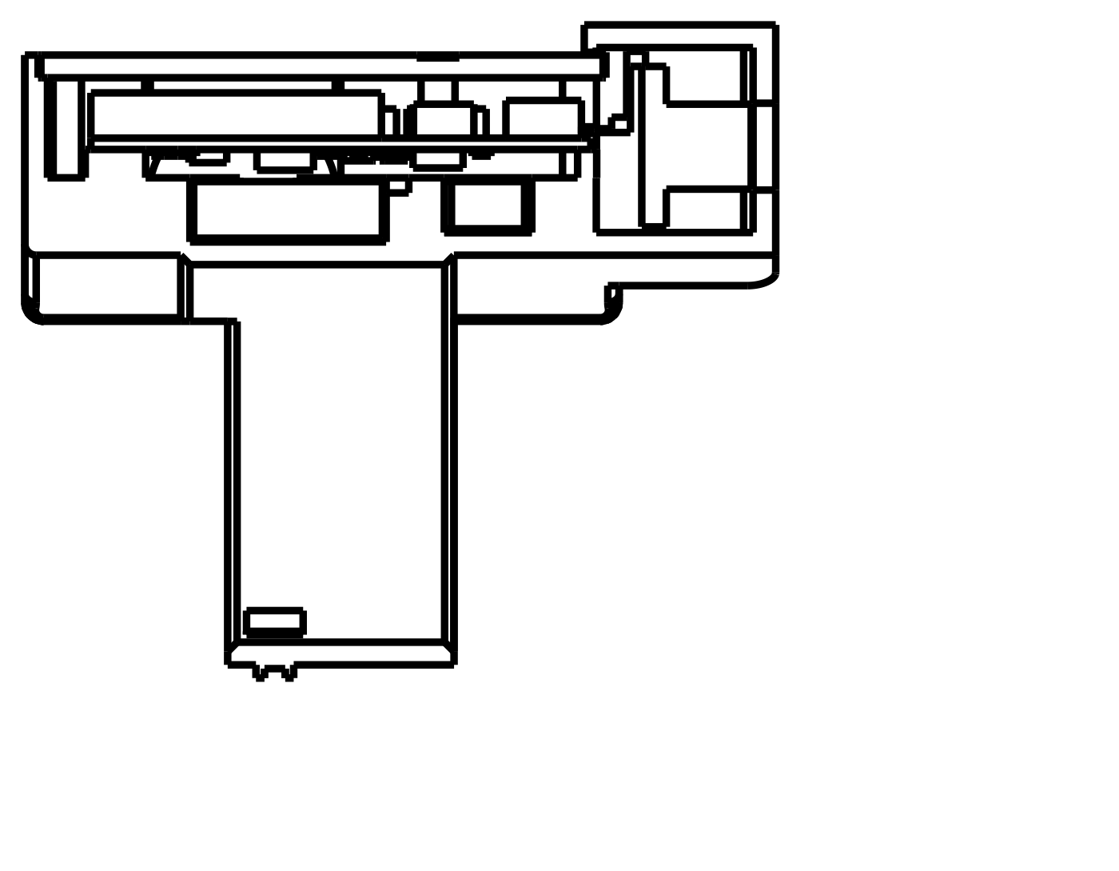
hardware/cad/out/view_section.png
