calebynhan/mcring/hardware/cad/out/view_section_speaker.png

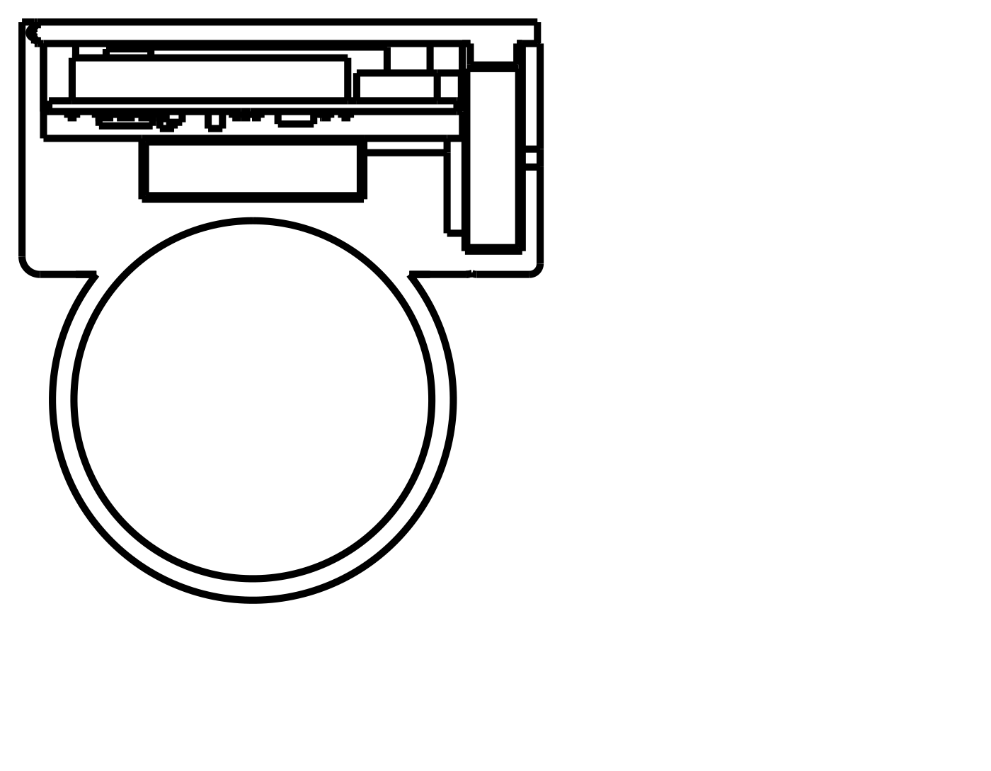
hardware/cad/out/view_section_speaker.png
