calebynhan/mcring/hardware/cad/out/view_top.png

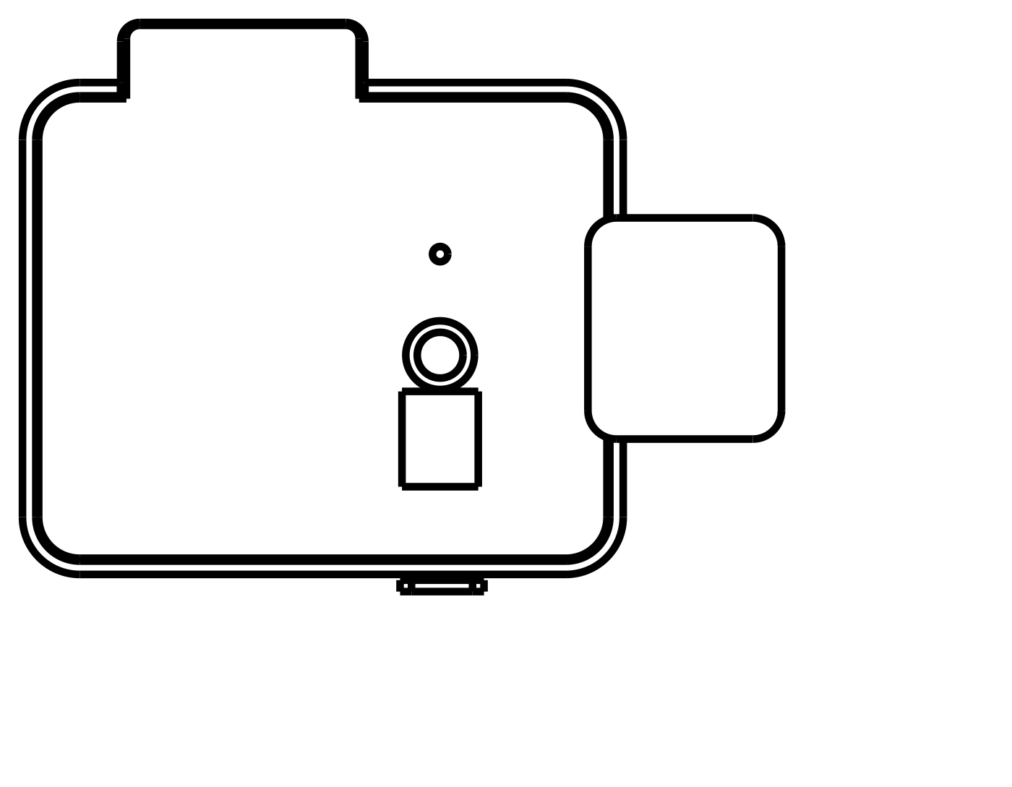
hardware/cad/out/view_top.png
