calebynhan/mcring/hardware/electrical/out/sch_camera.png

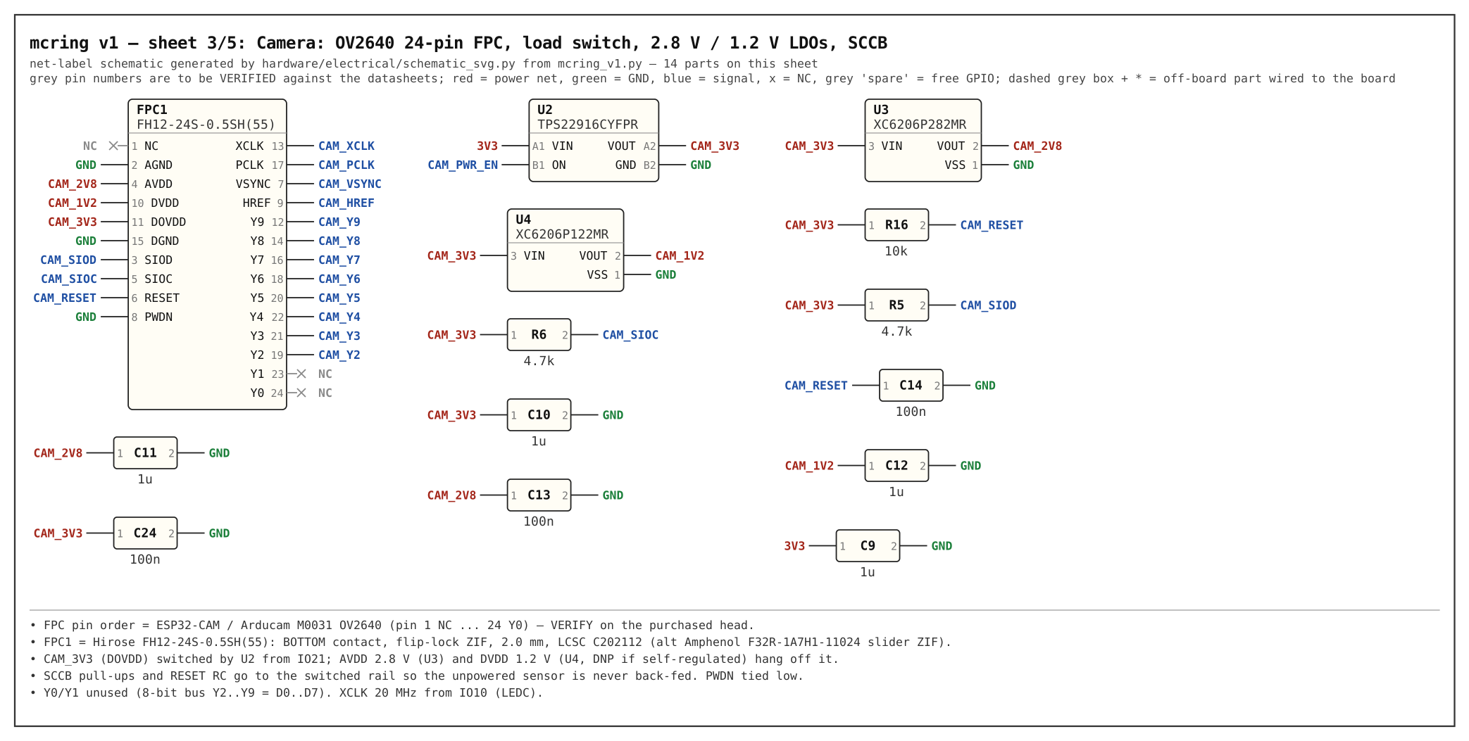
hardware/electrical/out/sch_camera.png
