calebynhan/mcring/hardware/electrical/out/sch_mcu.png

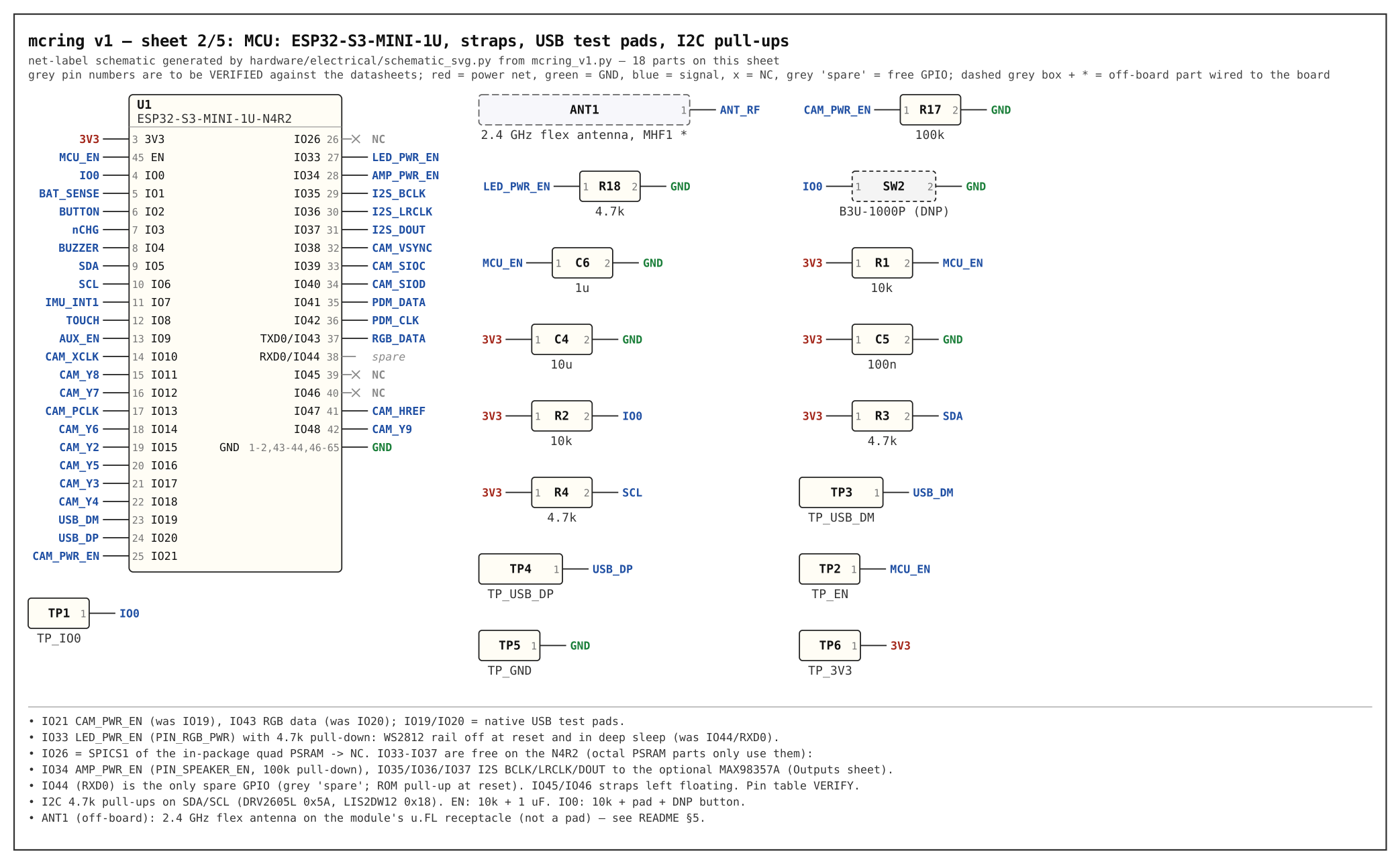
hardware/electrical/out/sch_mcu.png
