calebynhan/mcring/hardware/electrical/out/sch_outputs.png

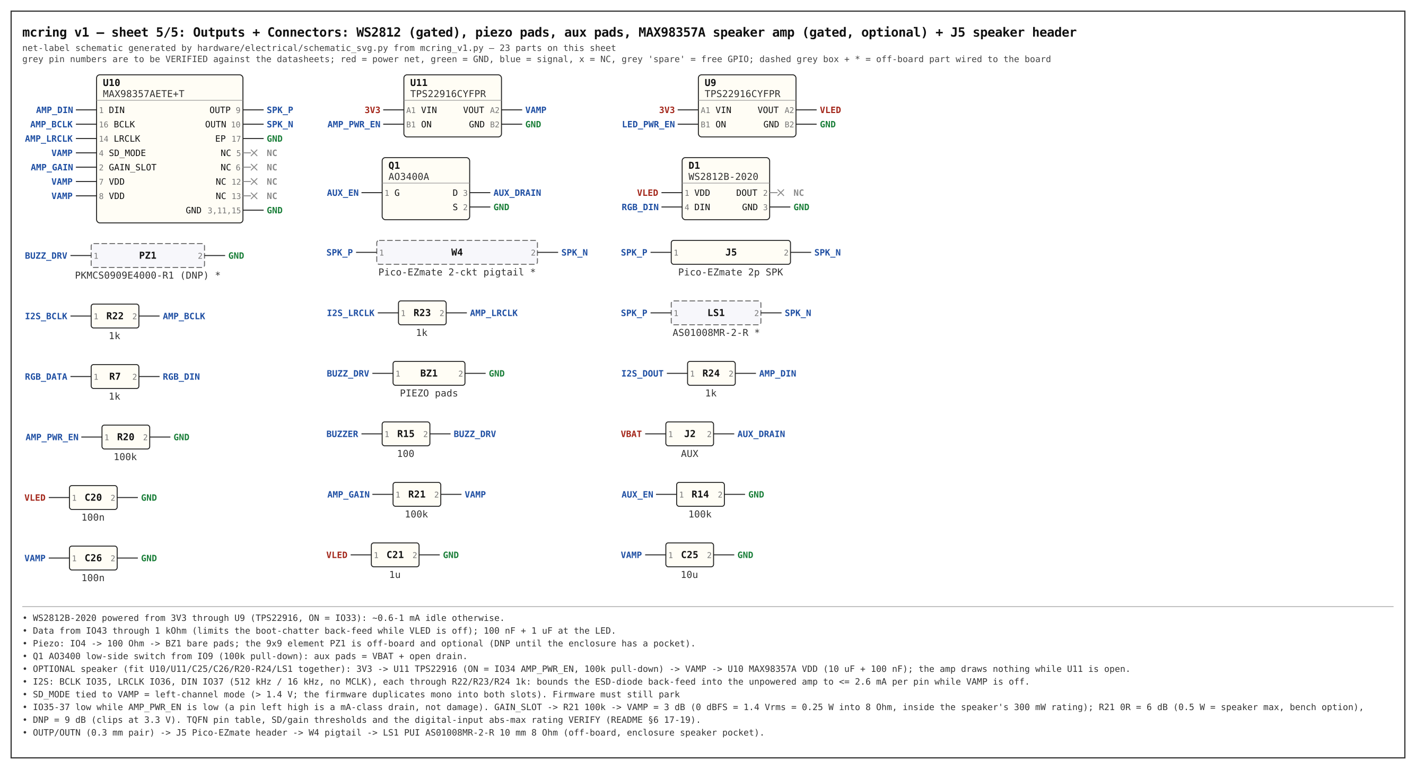
hardware/electrical/out/sch_outputs.png
