calebynhan/mcring/hardware/electrical/out/sch_power.png

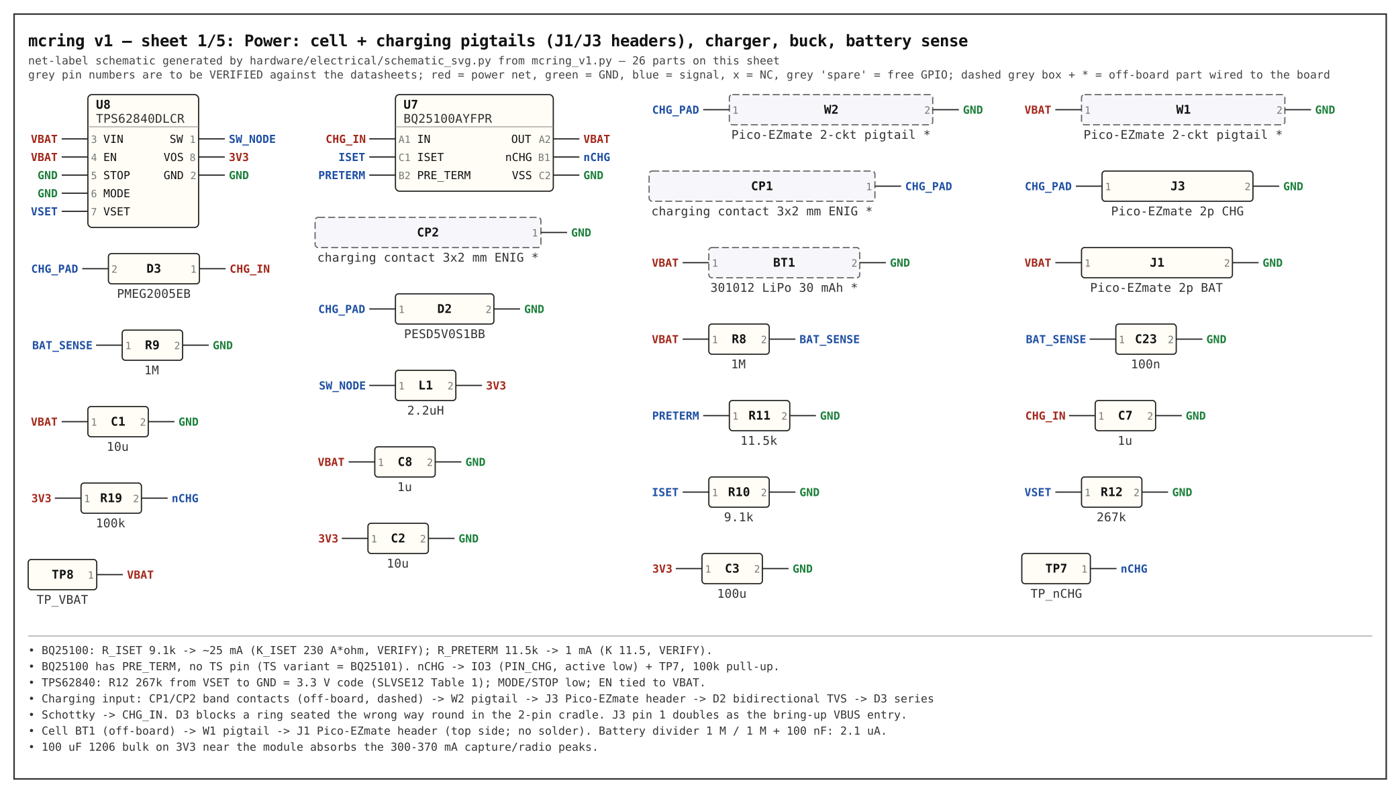
hardware/electrical/out/sch_power.png
