calebynhan/mcring/hardware/electrical/out/sch_sensors.png

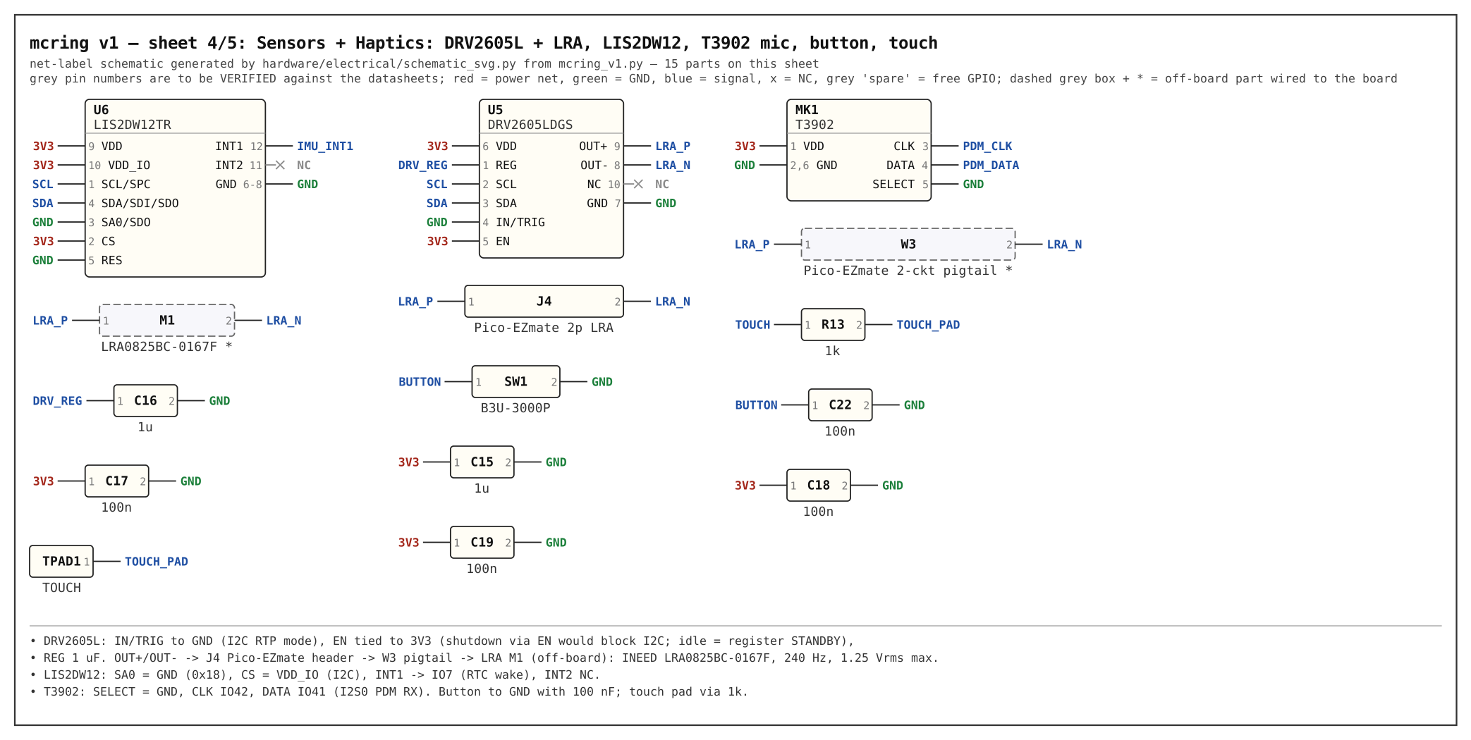
hardware/electrical/out/sch_sensors.png
