calebynhan/mcring/hardware/pcb/out/floorplan_bottom.png

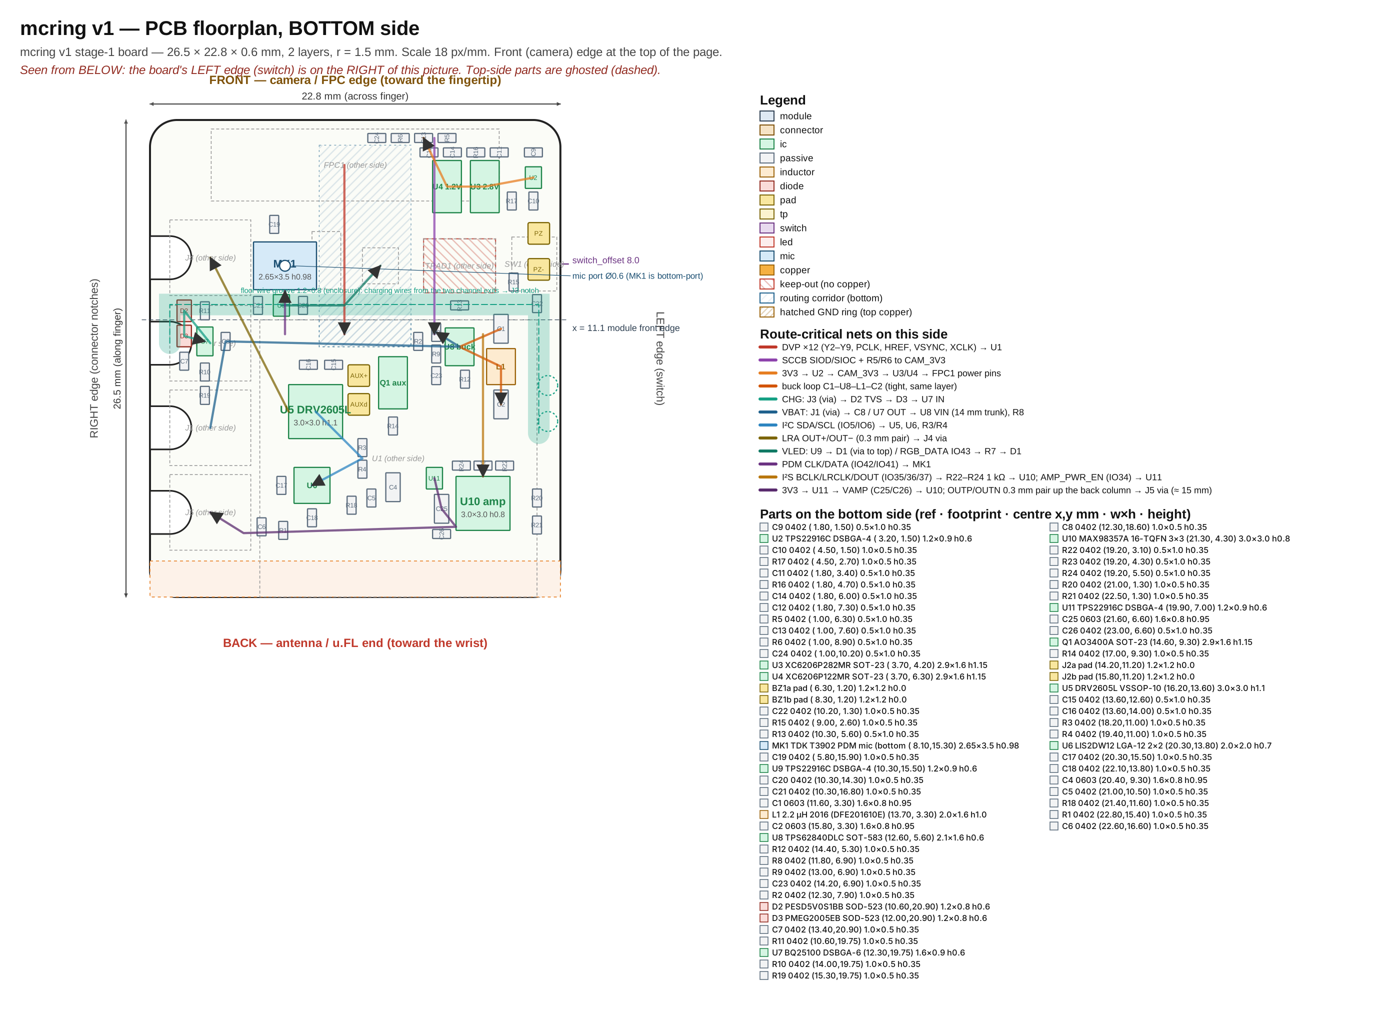
hardware/pcb/out/floorplan_bottom.png
