calebynhan/mcring/hardware/pcb/out/floorplan_top.png

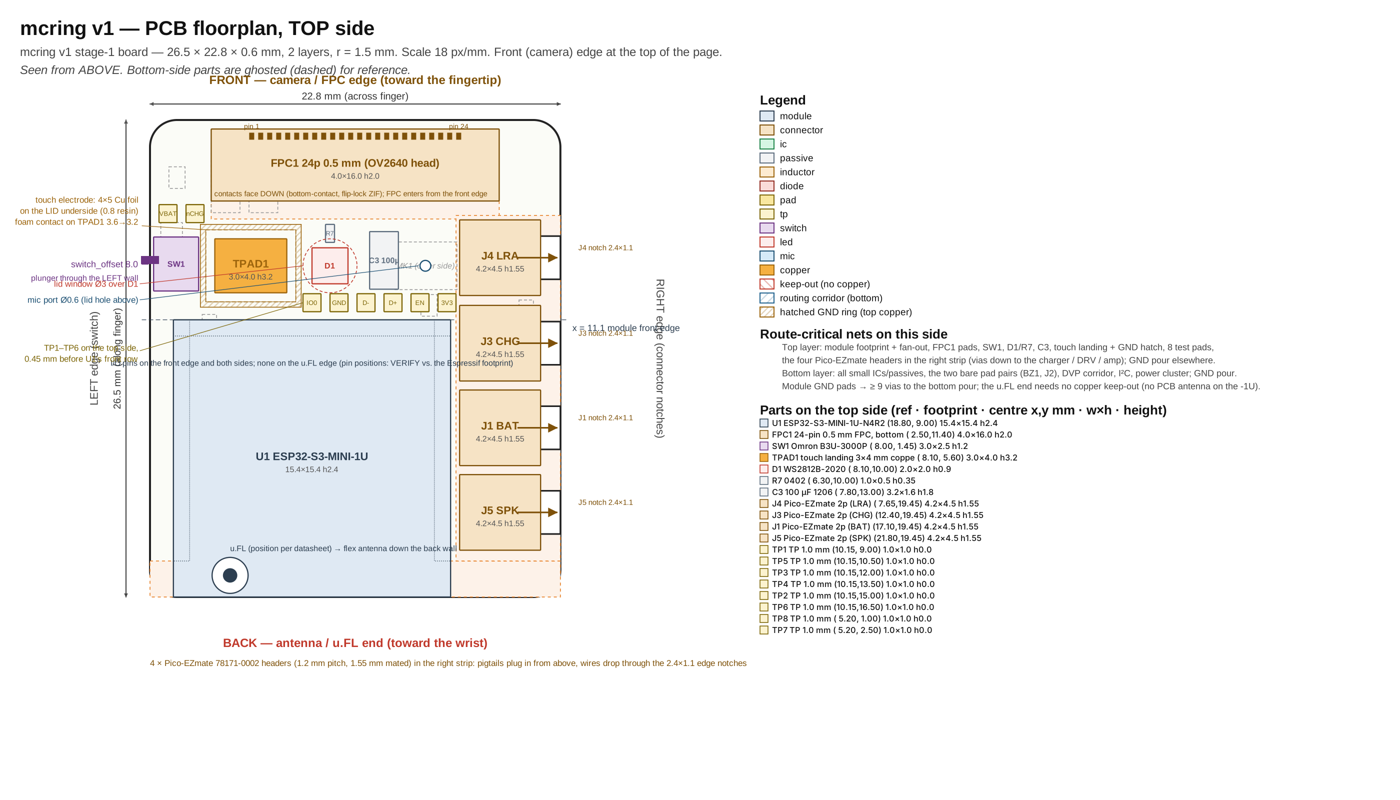
hardware/pcb/out/floorplan_top.png
