calebynhan/mcring/hardware/pcb/out/stackup.png

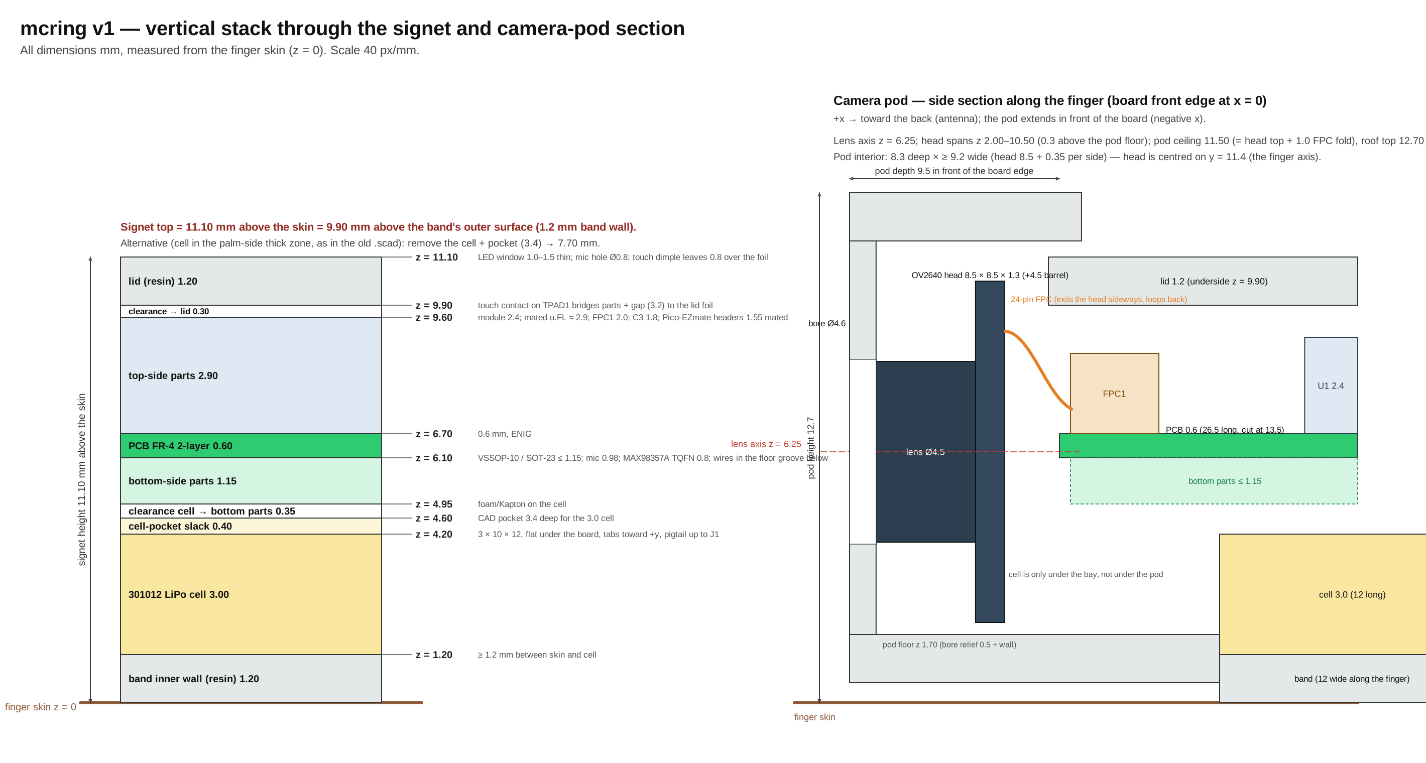
hardware/pcb/out/stackup.png
