calebynhan/mcring/hardware/bom/stage1-ring.csv

qty | part | mpn | description | footprint_mm | price_usd_1pc | source | url | notes
1 | ESP32-S3 module | ESP32-S3-MINI-1U-N4R2 | Wi-Fi/BLE SoC with DVP camera interface; 4MB flash + 2MB PSRAM; u.FL antenna socket | 15.4 x 15.4 x 2.4 | 5-10 | Mouser / DigiKey / Espressif store (CONSIGN to the assembler: not on LCSC - only the N8 without PSRAM is) | https://www.espressif.com/sites/default/files/documentation/esp32-s3-mini-1_mini-1u_datasheet_en.pdf | u.FL end pointing away from the camera; placed by the assembler (docs/10-ordering-assembled-boards.md)
1 | Camera module | OV2640 24-pin 0.5 mm FPC (Arducam M0031) OR Himax HM01B0-MNA-00FT870 | Colour 2MP JPEG (OV2640) or ultra-low-power 320x320 mono (HM01B0) | 21 x 12.5 x 5.85 (OV2640) / 20 x 12.5 x 3.39 (HM01B0) | 1-4 / 11.74 | AliExpress / Arducam / DigiKey | https://www.digikey.com/en/products/detail/himax/HM01B0-MNA-00FT870/14109821 | Plugs into FPC1 (flip-lock ZIF): owner step, no tools. OV2640 works today with esp_camera; HM01B0 needs the esp32-camera HM01B0 driver
1 | FPC connector | Hirose FH12-24S-0.5SH(55) (alt Amphenol FCI F32R-1A7H1-11024) | 24-pin 0.5 mm bottom-contact ZIF with a rotating flip-lock actuator, 2.0 mm tall; mates with the OV2640 FPC | ~16 x 4 x 2.0 | 0.67 | LCSC C202112 (JLCPCB extended part) | https://www.lcsc.com/product-detail/C202112.html | Placed by the assembler. The F32R alternate is a SLIDER-type ZIF from Amphenol FCI (same land pattern and pinout) - earlier text calling it an XKB back-flip was wrong
4 | Plug-in headers J1 BAT / J3 CHG / J4 LRA / J5 SPK | Molex 78171-0002 Pico-EZmate 2-circuit vertical SMT header (alt JST BM02B-ACHSS-GAN-ETF) | 1.20 mm pitch, side friction locks, 1.55 mm mated height; on the TOP of the board's right strip, one 2.4 x 1.1 mm wire notch in the board edge beside each | 4.2 x 4.5 x 1.55 (mated) | 0.3-0.5 | DigiKey / Mouser / RS (CONSIGN: not on LCSC) - order 24 for 5 boards (4 per board = 20 + attrition; docs/10 section 3) | https://www.molex.com/en-us/products/part-detail/781710002 | The owner never solders: cell, charging pigtail, LRA and speaker plug in. Mating housing 78172-0002; the JST ACH alternative (1.4 mm, housing ACHR-02V-S) needs a different land pattern
2 | Pigtail cables for W1-W4 (cut each in half = 4 pigtails per ring) | Molex 36920-0203 Pico-EZmate cable 300 mm 28 AWG plug-to-plug (alt 68801-4146 152 mm single-plug pigtail; 36920-0201 100 mm halves only for W1/W3/W4; JST ASACHSACH28W305 for the ACH alternative) | Cut in half = two 150 mm pigtails with a pre-crimped plug, trimmed to: W1 cell ~25 mm, W2 charging >= 85 mm per wire (modelled runs 61 / 73.5 mm, hardware/cad/fit_report.md), W3 LRA ~25 mm, W4 speaker ~15 mm. Half of the 100 mm 36920-0201 (~50 mm) does not reach for W2 | - | ~2.5 (GBP 1.87) | DigiKey 0369200203 (279 in stock at DigiKey UK, October 2026 search snippet; the 100 mm 0369200201 was 0 stock / 20-week; 68801-4146 being discontinued at RS; JST ACH jumpers in stock) | https://www.digikey.co.uk/en/products/detail/molex/0369200203/10232990 | Owner-side part. The pigtail-to-part joints (8 per ring) are the only wire joints left: the cell (always), the LRA and the speaker are terminated by the cell seller / a cable shop / PCBWay to the harness table in docs/10 section 7; solder-seal sleeves (heat gun, no iron) only on the LRA's flying leads - never on the cell
1 | Camera load switch (x3 on the board: U2 camera, U9 LED, U11 amp) | TPS22916CYFPR | Hard power-gate the camera rail (3 mA sleep otherwise); same part gates the WS2812 rail and the speaker amp rail | 0.9 x 1.2 CSP (0.4 mm DSBGA) | 0.3 | DigiKey / Arrow (CONSIGN: not on LCSC at the research snapshot; re-check live) - order 20 for 5 boards (3 per board = 15 + attrition; docs/10 section 3) | https://www.ti.com/product/TPS22916 | 0.4 mm pitch BGA: JLCPCB Standard PCBA only (0.35 mm capability); Economic PCBA cannot place it
1 | 2.8 V LDO | XC6206P282MR-G (or TLV75528) | Camera AVDD | SOT-23 | 0.1 | LCSC C2891263 (Torex) | https://www.lcsc.com/product-detail/C2891263.html | -G = halogen-free suffix of the same part; the PUOLOP clone C479055 also exists
1 | 1.2 V LDO (DNP if the head regulates DVDD) | XC6206P122MR | Camera DVDD | SOT-23 | 0.1 | LCSC (search the MPN at order time; else consign or mark DNP) |  | Mark DNP in the JLCPCB BOM if the purchased OV2640 head regulates DVDD itself
1 | Haptic driver | DRV2605LDGST (= DRV2605LDGSR on a 250-pc reel) | Closed-loop LRA drive via I2C (0x5A); EN tied to 3V3 | 3 x 3 VSSOP-10 | 1.34 | LCSC C425927 (DGST; the DGSR 2500-pc reel is C527464) | https://www.lcsc.com/product-detail/C425927.html
1 | LRA | INEED LRA0825BC-0167F (8 x 2.5 mm) or PMD C08-005 (8 x 3.3 mm) | Haptic cues (listening / answer-ready ticks; optional silent Morse); off-board in the floor pocket; leads -> W3 plug -> J4 | Ø8 x 2.5-3.3 | 3-5.15 | DigiKey marketplace / PMD | https://azcus.digikey.com/en/products/detail/ineed-motor/LRA0825BC-0167F/21840080 | Thinner INEED part preferred. No stock LRA ships with a plug: terminate its two leads with the W3 pigtail (cable shop / PCBWay, or a solder-seal sleeve with a heat gun and the LRA body shielded - docs/10 section 7)
1 | Accelerometer | LIS2DW12TR | Double-tap wake/trigger (~1 µA in a low-power ODR; ~90 µA in the 400 Hz HP mode the firmware uses for tap-wake) | 2 x 2 x 0.7 LGA | 1.38 | LCSC C189624 (extended) | https://www.lcsc.com/product-detail/C189624.html
1 | RGB LED | WS2812B-2020 (or XL-1010RGBC-WS2812B) | Status / cue LED (optional light Morse) through the 1.2 mm lid (engraved ring marks the spot; rail gated by a second TPS22916) | 2 x 2 (1 x 1) | 0.09 | LCSC C965555 | https://datasheet.lcsc.com/lcsc/2012110135_Worldsemi-WS2812B-2020_C965555.pdf | Check 3.3 V operation; else use WS2812C-2020-V1
1 | Side tactile switch | Omron B3U-3000P | Hard trigger / wake | 3.0 x 2.5 x 1.2 | 0.5 | DigiKey (search LCSC for the MPN at order time; consign if absent) | https://www.digikey.com/en/products/detail/omron-electronics-inc-emc-div/B3U-3000P-B/1811779 | Place palm-opposite; long-press semantics in firmware
1 | PDM microphone | TDK T3902 (or Infineon IM69D130) | Voice questions | 3.5 x 2.65 x 0.98 | 1.30-2.02 | Mouser / DigiKey (search LCSC at order time; consign if absent) | https://invensense.tdk.com/products/t3902 | Bottom-port part on the board underside: Ø0.6 hole through the board + Ø0.8 lid port (hardware/cad)
1 | Piezo sounder (optional) | Murata PKMCS0909E4000-R1 | 4 kHz beep cues (optional; off by default); the only part that would still need a wire joint on the board (BZ1 bare pads) - DNP | 9 x 9 x 1.9 | 1.5 | DigiKey (Last Time Buy) | https://digikey.in/en/products/detail/murata-electronics/PKMCS0909E4000-R1/4878400 | No pocket in the enclosure; leave off
1 | Speaker amp (optional) | MAX98357AETE+T (16-TQFN; alt MAX98357AEWL+T 9-bump WLP) | I2S class-D mono amp for the on-ring speaker (U10): BCLK IO35 / LRCLK IO36 / DIN IO37, SD_MODE tied to the gated rail VAMP (left mode), gain 3 dB via R21 100k (0 dBFS = 0.25 W, inside the speaker's 300 mW rating; R21 0R = 6 dB / 0.5 W is the louder bench option); 1k series R22-R24 in BCLK/LRCLK/DIN bound the ESD back-feed while VAMP is off; 10 uF + 100 nF on VAMP | 3 x 3 x 0.75 TQFN (WLP 1.4 x 1.4) | 1.8-2.5 | LCSC C910544 / DigiKey | https://www.analog.com/en/products/max98357a.html | Voice-first AUDIO_OUT playback; fit with U11, R20-R24, C25/C26 + the speaker or omit the whole group (the J5 header stays). TQFN pin table to verify (hardware/electrical/README.md 6)
1 | Speaker amp load switch (optional) | TPS22916CYFPR | Third TPS22916 (U11): gates 3V3 to the amp rail VAMP from IO34 (PIN_SPEAKER_EN; 100k pull-down) so the amp group draws nothing asleep | 0.9 x 1.2 CSP | 0.3 | consign (see the camera load switch line) | https://www.ti.com/product/TPS22916 | Same part as the camera and LED gates (3 per board)
1 | Speaker (optional) | PUI Audio AS01008MR-2-R (or any 10 mm 8 ohm micro speaker) | 10 mm 8 ohm micro speaker, 300 mW rated / 500 mW max, 86 dB, top port, NdFeB magnet, solder-pad terminals (netlist LS1, off-board); terminals -> W4 plug -> J5 | 10 dia x 2.9 max | 1.5-3 | DigiKey / Mouser | https://www.puiaudio.com/ | Sits in a pocket in the signet's RIGHT wall, grille facing +y, back open to the bay (hardware/pcb/board_params.json speaker_mm); magnet >= 5 mm from the flex antenna (6.7 mm as built). Solder-pad terminals: have the W4 pigtail soldered on by the cable shop / PCBWay (a solder-seal sleeve needs a leaded variant such as AS01008MR-3-LW100-R - check its thickness against the pocket; docs/10 section 7)
1 | Battery | 301012 30 mAh LiPo with PCM (501012 40 mAh needs a deeper pocket) | Flat cell in the 3.4 mm pocket in the bay floor under the board (hardware/cad); tabs toward +y; leads -> W1 plug -> J1 | 3 x 10 x 12 (5 x 10 x 12) | ~1-2.5 each (multi-packs) | eBay / AliExpress / Robu | https://www.ebay.de/itm/127362229239 | Verify PCM present; 1C charge max. Must ARRIVE with the W1 Pico-EZmate plug fitted (cell seller, cable shop or PCBWay harness service). NEVER a solder-seal sleeve, heat gun or flame on the cell: the joint is ~25 mm from the pouch (docs/10 section 7 LiPo warning)
1 | Charger | TI BQ25100AYFPR | 25 mA charge (R_ISET 9.1 k) with 1 mA termination (R_PRETERM 11.5 k) for the 30 mAh cell; /CHG to IO3 + TP7 | 1.6 x 0.9 DSBGA (0.4 mm) | 1.0-2.1 | LCSC C2871910 (extended; 96 pcs at the research snapshot) / DigiKey | https://www.lcsc.com/product-detail/C2871910.html | MCP73831 is OK for >= 40 mAh cells
1 | 3.3 V buck | TPS62840DLCR (alt TLV75533 LDO) | System rail (3.3 V: VSET 267 k) | SOT-583 | 0.5-1.5 | LCSC C2071859 | https://www.lcsc.com/product-detail/C2071859.html
2 | Charging contacts + pogo cradle | 3 x 2 mm ENIG contacts flush in the inner band (3 x 3 windows at +/-25 deg from the bottom) + 2-pin pogo dock; the W2 pigtail (>= 85 mm per wire) runs from J3 through the floor groove and the two Ø1.1 band channels to them | Charging without a coil | 3 x 2 pads; 8.45 mm chord apart | 2 | scrap of ENIG board; MG Chemicals 842AR-P silver conductive pen (~$46) to bond the pigtail's bare ends to the contacts without an iron (<= 25 mA path) |  | The coupons go on after the bare W2 ends are threaded through the Ø1.1 channels (a coupon fitted beforehand cannot pass them): silver pen. Stage 2 moves to a flex coil; geometry: docs/07-build-guide.md 2.8
1 | Air-puff experiment (optional) | Murata MZB1001T02 microblower + driver (MZBD-type or discrete boost + half-bridge) | Only puff actuator with a perceptible jet; mounts as a 22 x 22 mm signet plate; J2 bare pads (bench only) | 20 x 20 x 1.85 (+1.6 nozzle) | 12-15 + driver | Mouser / DigiKey | https://www.mouser.com/datasheet/2/281/MZB1001T02_SPEC_Ver2-202918.pdf | Stock is thin; aux channel (PIN_AUX) already in firmware
1 | PCB + assembly (per board; order 5) | 2-layer 0.6 mm rigid FR-4 ENIG, JLCPCB Standard PCBA (double-sided) or PCBWay turnkey/consigned PCBA | 26.5 x 22.8 mm board with four 2.4 x 1.1 wire notches in the right edge (hardware/pcb/board_params.json; floorplan.md); ~73 placed parts, ~290 joints, 31 BOM lines; files: hardware/pcb/out/mcring_v1_cpl.csv + mcring_v1_bom_jlc.csv (export_cpl.py) | 26.5 x 22.8 x 0.6 | ~60-100 per assembled board at qty 5 incl. PCB, setup, stencils, sourced + consigned parts and shipping (docs/10 section 6) | JLCPCB / PCBWay | https://jlcpcb.com/capabilities/pcb-assembly-capabilities | 0.10/0.10 mm track/space + 0.2 mm drills for the DSBGAs; Standard PCBA is required (0.35 mm BGA pitch, both sides); Economic is 0.5 mm / single side. Expect ~$300-490 for five assembled boards incl. consigned parts and shipping (docs/10 section 6 estimate)
1 | Enclosure | SLA resin print of hardware/cad/out/mcring_stage1_shell/lid/key.stl (CadQuery; generated from board_params.json) | Tough white/translucent resin; LED shines through the 1.2 mm lid; cell lead channel toward +y; 1.2 x 0.8 floor groove for the charging wires; Ø1.1 band channels | band 22.4 OD x 12 wide; signet 31.5 x 25.8 x 11.1 (pod roof 12.7; 28.95 wide across the speaker bump) | 2-15 | Home SLA / JLC3DP |  | Fit report: hardware/cad/fit_report.md (PASS). 4.8 mm wider across the finger than the wire-pad design: the price of plug-in assembly
1 | Flex antenna | Molex 146153-0050 (alt Taoglas FXP70.07.0053A) | 2.4 GHz flex dipole with MHF1 (u.FL) pigtail for the MINI-1U (netlist ANT1) - snaps onto the module | 34.9 x 9 x 0.1 | 3-5 | DigiKey / Mouser |  | Glued inside the bay's back wall (2 mm cavity); shorten or coil the 50 mm pigtail to <= 30 mm (hardware/cad/README.md Antenna). No tools
1 | Touch electrode + contact | 3M 1181 copper-foil tape cut 4 x 5 mm + conductive-foam block 3 x 4 x 3.6 mm (or SMT spring finger) | Lid-underside electrode and compliant contact to the TPAD1 landing (hardware/pcb/floorplan.md 2) | 4 x 5 / 3 x 4 x 3.6 | 1-5 | DigiKey / any |  | Compressed to 3.2 mm by the lid; 0.8 mm resin over the foil
1 | Solder-seal sleeves (LRA only; optional) | heat-shrink solder-seal wire connectors, white (26-30 AWG), pack of 50-100 | The no-iron way to join the W3 pigtail to the LRA's flying leads (2 joints); heat gun only (no lighter) with the LRA body shielded. NEVER on the cell (LiPo pouch ~25 mm away) and not on the speaker's solder pads | - | 5-10 | Amazon / any |  | Not needed if the parts come pre-terminated from a cable shop / PCBWay (docs/10 section 7)
 |  |  |  |  | TOTAL per ring ≈ 80-140 (assembled board ≈ 60-100 + off-board parts ≈ 20-40, docs/10 section 6; 5-board run ≈ 300-490 for the boards); the optional speaker group adds ≈ 4-6
