calebynhan/mcring/hardware/bom/stage0-devkit.csv

qty | part | description | why | approx_price_usd | source | url | notes
1 | Seeed XIAO ESP32S3 Sense | ESP32-S3 + 8MB PSRAM + OV2640 camera + PDM mic + microSD | Runs firmware/ring-esp32s3 unmodified; proves capture → BLE → phone → LLM → spoken answer (headphones or the optional ring speaker) plus haptic/LED cues end to end | 14-20 | Seeed / Pi Hut / AliExpress | https://thepihut.com/products/seeed-studio-xiao-esp32s3-sense | Some units ship with OV3660; both supported
1 | Adafruit DRV2605L breakout | Haptic driver (I2C 0x5A) for LRA/ERM | Crisp haptic cues (listening / answer ready) with closed-loop LRA drive; optional silent Morse mode | 7.95 | Adafruit | https://www.adafruit.com/products/2305 | Or DRV2605LDGS bare chip on LCSC ~$1.34
1 | 8 mm coin LRA (235 Hz) | e.g. Precision Microdrives C08-005 or Jameco 8 mm LRA | Primary cue channel (haptic ticks; optional silent Morse) | 1.75-5.15 | PMD / Jameco | https://www.precisionmicrodrives.com/?p=12426 | Jameco closeout $1.75: https://www.jameco.com/z/1162213-
1 | LIS2DW12 breakout | 3-axis accel with double-tap interrupt | Double-tap trigger + deep-sleep wake | 2-6 | AliExpress / Adafruit (LIS3DH is a fallback) | https://www.digikey.com/en/products/detail/stmicroelectronics/LIS2DW12TR/7914708 | Any LIS2DW12 module; address 0x18/0x19
1 | Tactile switch 6x6 mm | Momentary button to GND | Primary trigger during bring-up | 0.1 | any
1 | Piezo sounder 9-12 mm | e.g. Murata PKMCS0909E4000-R1 (LTB) or any 12 mm passive piezo | Audible beep cues (optional; off by default — cues_mask bit 2) | 0.5-2 | DigiKey / AliExpress | https://digikey.in/en/products/detail/murata-electronics/PKMCS0909E4000-R1/4878400
1 | LiPo 100 mAh | Adafruit 1570 (31 x 11.5 x 3.8 mm) for bench battery tests | Realistic power testing | 5.95 | Adafruit | https://www.adafruit.com/categories/889 | XIAO has an on-board charger (BAT pads)
2 | 100 kΩ resistors (+ 1 x 100 nF) | Battery sense divider to A0: BAT+ → 100 k → A0 → 100 k → GND with 100 nF on A0 (hardware/pcb/wiring_stage0.md) | Battery % in status; ~20 µA drain (10 k/10 k would be 210 µA) | 0.02 | any
1 | Breadboard + jumper wires |  |  | 5 | any
1 | MAX98357A I2S amp breakout (optional) | Adafruit 3006: MAX98357A class-D mono amp, 2.5-5.5 V, screw terminal for the speaker; wire BCLK → D7/GPIO44, LRC → D6/GPIO43, DIN → D10/GPIO9, SD → 3V3, VIN → 3V3, GND → GND (hardware/pcb/wiring_stage0.md) | Hear the answer from the ring (BLE AUDIO_OUT stream → I2S) instead of the phone; same amp as the stage-1 board | 5.95 | Adafruit | https://www.adafruit.com/product/3006 | D10 was PIN_AUX (the air-puff experiment is parked on the dev kit, config_audio.h). GAIN open = 9 dB clips the top ~1.7 dB at 3.3 V — keep the volume <= 200, or wire GAIN → VIN through 100 k for the stage-1 board's 3 dB (clean at 255)
1 | 10 mm 8 ohm speaker (optional) | PUI AS01008MR-2-R (10 mm, 8 ohm, 300 mW) — the stage-1 part; or a 1 W 8 ohm oval such as Adafruit 3923 for the bench | Load for the amp breakout at the loudness the ring will have (~66 dB at 1 m with the 10 mm driver) | 1.5-3 (3923: 1.95) | DigiKey / Mouser / Adafruit | https://www.adafruit.com/product/3923 | Solder 2 leads to the screw terminal; polarity irrelevant
 |  |  |  | TOTAL ≈ 40-55 (+ 7.5-9 with the optional speaker)
