calebynhan/mcring/hardware/bom/stage2-oura-size.csv

qty | part | mpn | description | footprint_mm | price_usd_1pc | source | url | notes
1 | BLE SoC | Nordic nRF52840 WLCSP (nRF52840-CIAA) or Insight SiP ISP1807 (nRF52840 SiP with antenna) | ~5 mA radio peaks match a 1C 16-24 mAh cell; Galaxy Ring uses the sibling nRF5340 | 3.5 x 3.6 WLCSP / 8 x 8 x 1.0 SiP | 3.8 / n/a (MOQ risk) | LCSC / TME | https://www.digikey.com/en/product-highlight/i/insight-sip/isp1807-bluetooth-module | ESP32-S3 is NOT viable here (300 mA peaks, 15x the cell's 1C rating)
1 | Camera | OmniVision OVM7692-RAAA (640x480 colour DVP CameraCubeChip) — alt: OVM6211 if stock appears; HM01B0 bare CSP + custom lens for lowest power | Only DigiKey-stocked digital camera under 3.5 mm | 2.8 x 3.2 x 2.6 | 27.50 (DigiKey) / ~6 (LCSC) | DigiKey / LCSC | https://www.digikey.com/en/products/detail/omnivision-technologies-inc/OVM7692-RAAA/3190565 | 8-bit DVP captured by nRF52840 GPIO bit-bang (proven on Nano 33 BLE with OV7670) — grayscale 160x120 keeps RAM and BLE time small; needs a ~4-5 mm camera pod
1 | Battery | Grepow curved LiPo 16-24 mAh (e.g. GRP170722 14.5 mAh 1.7 x 6.5 x 22) | Same class as Oura (16 mAh) / Galaxy Ring (17-22.5 mAh) | 1.7 x 6.5 x 22 (curved) | B2B sample | Grepow | https://www.grepow.com/wearables/9.html | Expect MOQ/NDA; 1C → ≤15 mA continuous
1 | Charger | TI BQ25100AYFPR (or BQ25120A buck+charger+load switch as in Oura Gen 2) | 1 mA termination for a 15 mAh cell | 1.6 x 0.9 DSBGA | 1.0 | DigiKey | https://www.ti.com/document-viewer/BQ25100/datasheet
1 | Charging coil | Flex-printed spiral + custom resonant cradle (COTS floor is ~11 mm: TDK WR111180-36F5-B1) | Oura/Galaxy use custom coils in epoxy | printed on the flex | — | — | https://www.digikey.es/en/products/detail/tdk/WR111180-36F5-B1/8019488 | Alternative: two exposed pads
1 | Haptic | Vybronics VG0640001D 6 mm LRA + DRV2624YFFR; alt TDK PowerHap 0904H014V060 (9 x 3.75 x 1.4) + Boréas BOS1901 WLCSP | Thinnest haptic cue channel (optional silent Morse) | Ø6 x ~2.5? (verify) / 9 x 3.75 x 1.4 | 4.19 / ~10 + 4.70 | DigiKey / Mouser | https://www.digikey.com/en/products/detail/vybronics-inc/VG0640001D/15220805 | RingConn Gen 3 proves a motor fits in a 2.3 mm ring (custom part)
1 | Accelerometer | LIS2DW12TR | Double-tap trigger; no button at this size | 2 x 2 x 0.7 | 1.38 | DigiKey
1 | RGB LED | XINGLIGHT XL-1010RGBC-WS2812B | Status / cue LED (optional light Morse) | 1.0 x 1.0 x 0.8 | ~0.1 | LCSC C5349953 | https://www.lcsc.com/product-detail/Light-Emitting-Diodes-LED_XINGLIGHT-XL-1010RGBC-WS2812B_C5349953.html
1 | Microphone (optional) | TDK T3902 | Voice questions | 3.5 x 2.65 x 0.98 | 1.30 | Mouser
1 | Touch IC (optional) | Azoteq IQS227B WLCSP | Deliberate thumb-press trigger on the top face | WLCSP-8 | ~0.5 | Future | https://www.azoteq.com/?p=30615
1 | Rigid-flex PCB | 0.22 mm flex / 0.48 mm rigid islands (Memfault smart-ring guide) | Wraps inside the band; printed microstrip antenna | ~8 mm wide | 100-300 per batch | PCBWay / JLC rigid-flex | https://interrupt.memfault.com/blog/smart-ring-development-part-1 | WLCSP assembly → use an assembly house
1 | Shell | Titanium or resin ring blank + epoxy potting |  | ~20 ID x 8 wide x 3 thick (+ 4-5 mm camera pod) | 20-100 | —
 |  |  |  |  | TOTAL ≈ 200-500 per prototype (PCB + assembly dominate)
