calebynhan/mcring/hardware/electrical/out/mcring_v1_bom.csv

Qty | Refs | Value | Footprint | MPN | Manufacturer | LCSC | Description | Mount | DNP
1 | BZ1 | PIEZO pads | mcring:PAD_Wire_2x1.2mm_P2.0mm |  |  |  | two 1.2 mm wire pads, 2.0 mm pitch, bottom side, for the optional piezo element PZ1 | PCB
4 | C1 C2 C4 C25 | 10u | Capacitor_SMD:C_0603_1608Metric | GRM188R60J106ME47 | Murata | C77041 | 4x 10u 0603: module 3V3 decoupling; buck input; buck output; VAMP bulk at U10 VDD (class-D peaks) | PCB
1 | C3 | 100u | Capacitor_SMD:C_1206_3216Metric | GRM31CR60J107ME39 | Murata |  | 3V3 bulk for 300-370 mA capture/radio peaks | PCB
11 | C5 C13 C14 C17 C18 C19 C20 C22 C23 C24 C26 | 100n | Capacitor_SMD:C_0402_1005Metric | GRM155R71C104KA88 | Murata | C71629 | 11x 100n 0402: module 3V3 decoupling; battery sense hold capacitor (ADC sample bursts); DOVDD at FPC; AVDD at FPC; camera RESET power-on delay; LIS2DW12 VDD; LIS2DW12 VDD_IO; mic VDD; button debounce/ESD; WS2812 VDD; VAMP local at U10 VDD pins 7/8 | PCB
10 | C6 C7 C8 C9 C10 C11 C12 C15 C16 C21 | 1u | Capacitor_SMD:C_0402_1005Metric | GRM155R61A105KE15 | Murata | C76999 | 10x 1u 0402: EN RC (reset delay); charger IN; charger OUT / VBAT; U2 VIN local; CAM_3V3 (DOVDD) at U2 out; CAM_2V8 (AVDD); CAM_1V2 (DVDD); DRV2605L VDD; DRV2605L REG; VLED at U9 out | PCB
1 | D1 | WS2812B-2020 | LED_SMD:LED_WS2812B-2020_PLCC4_2.0x2.0mm | WS2812B-2020 | Worldsemi | C965555 | RGB LED under the white-resin window, VLED = 3.3 V (below the 3.7 V datasheet min: bench VERIFY; alt. 3.3 V-rated 2020 RGB per hardware/bom/stage1-ring.csv); pad order VERIFY | PCB
1 | D2 | PESD5V0S1BB | Diode_SMD:D_SOD-523 | PESD5V0S1BB,115 | Nexperia |  | bidirectional 5 V TVS on the charging pad (symmetric, no polarity); was PESD5V0S1UB | PCB
1 | D3 | PMEG2005EB | Diode_SMD:D_SOD-523 | PMEG2005EB,115 | Nexperia |  | series Schottky CHG_PAD -> CHG_IN: reverse-polarity block for the pogo pads (~0.25 V at 25 mA; VIN to U7 >= 4.5 V from a 4.75 V cradle); pin order VERIFY | PCB
1 | FPC1 | FH12-24S-0.5SH(55) | Connector_FFC-FPC:Hirose_FH12-24S-0.5SH_1x24-1MP_P0.50mm_Horizontal | FH12-24S-0.5SH(55) | Hirose | C202112 | OV2640 24-pin 0.5 mm FPC, bottom contact, flip-lock ZIF, horizontal, 2.0 mm tall (Arducam M0031 pin order VERIFY) | PCB
1 | J1 | Pico-EZmate 2p BAT | Connector_Molex:Molex_Pico-EZmate_78171-0002_1x02-1MP_P1.20mm_Vertical | 78171-0002 | Molex |  | cell header (top side, right strip; wire notch in the right edge beside it); pin 1 = BAT+ — mark the silkscreen, the Pico-EZmate plug is polarised | PCB
1 | J2 | AUX | mcring:PAD_Aux_1x2 |  |  |  | aux actuator pads (bare 1.2 mm pads, bench experiment only): VBAT + open-drain return (Q1) | PCB
1 | J3 | Pico-EZmate 2p CHG | Connector_Molex:Molex_Pico-EZmate_78171-0002_1x02-1MP_P1.20mm_Vertical | 78171-0002 | Molex |  | charging-pad header (top side, right strip); pin 1 = CHG_PAD (+5 V from the cradle, bring-up VBUS entry), pin 2 = GND return | PCB
1 | J4 | Pico-EZmate 2p LRA | Connector_Molex:Molex_Pico-EZmate_78171-0002_1x02-1MP_P1.20mm_Vertical | 78171-0002 | Molex |  | LRA header (top side, right strip, front); OUT+/OUT- from U5 as a 0.3 mm pair | PCB
1 | J5 | Pico-EZmate 2p SPK | Connector_Molex:Molex_Pico-EZmate_78171-0002_1x02-1MP_P1.20mm_Vertical | 78171-0002 | Molex |  | speaker header (top side, right strip, back); OUTP/OUTN from U10 as a 0.3 mm pair (filterless class D); fitted even without the amp group so the speaker can be added later | PCB
1 | L1 | 2.2uH | Inductor_SMD:L_0806_2016Metric | DFE201610E-2R2M=P2 | Murata |  | buck inductor 2.0x1.6x1.0 mm | PCB
1 | MK1 | T3902 | mcring:MIC_TDK_T3902_3.5x2.65mm | T3902 | TDK InvenSense |  | PDM microphone, bottom port (0.5 mm hole); pad numbers VERIFY | PCB
1 | Q1 | AO3400A | Package_TO_SOT_SMD:SOT-23 | AO3400A | Alpha & Omega | C20917 | aux low-side N-MOSFET (air-puff driver enable / any load) | PCB
3 | R1 R2 R16 | 10k | Resistor_SMD:R_0402_1005Metric | RC0402FR-0710KL | Yageo | C60490 | 3x 10k 0402: EN pull-up; IO0 boot strap pull-up; camera RESET pull-up | PCB
5 | R3 R4 R5 R6 R18 | 4.7k | Resistor_SMD:R_0402_1005Metric | RC0402FR-074K7L | Yageo | C105871 | 5x 4.7k 0402: I2C SDA pull-up; I2C SCL pull-up; LED_PWR_EN pull-down: LED rail off while IO33 floats (reset, download, deep sleep); 4.7k keeps the ON pin < 0.35 V even against a ~45k internal pull-up; SCCB SIOD pull-up (to the switched rail); SCCB SIOC pull-up (to the switched rail) | PCB
5 | R7 R13 R22 R23 R24 | 1k | Resistor_SMD:R_0402_1005Metric | RC0402FR-071KL | Yageo |  | 5x 1k 0402: touch pad series; WS2812 data series: limits the ROM TXD0 boot chatter back-feed into DIN while VLED is off to ~2.7 mA (was 100 R = 27 mA pulses); I2S BCLK series at U10: bounds the ESD-diode back-feed into the unpowered amp to <= 2.6 mA while VAMP is off; I2S LRCLK series at U10 (same role as R22); I2S DIN series at U10 (same role as R22) | PCB
2 | R8 R9 | 1M | Resistor_SMD:R_0402_1005Metric | RC0402FR-071ML | Yageo |  | 2x 1M 0402: battery divider top (1 M/1 M: 2.1 uA at 4.2 V); battery divider bottom (BATTERY_DIVIDER = 2.0 unchanged) | PCB
1 | R10 | 9.1k | Resistor_SMD:R_0402_1005Metric | RC0402FR-079K1L | Yageo |  | ISET: 230/9.1k = 25 mA (VERIFY K_ISET) | PCB
1 | R11 | 11.5k | Resistor_SMD:R_0402_1005Metric | RC0402FR-0711K5L | Yageo |  | PRE_TERM: 11.5/11.5k = 1 mA (VERIFY K_PRETERM) | PCB
1 | R12 | 267k | Resistor_SMD:R_0402_1005Metric | RC0402FR-07267KL | Yageo |  | TPS62840 VSET -> GND: 267 kOhm (E96) = 3.3 V code, SLVSE12 Table 1 (1 %) | PCB
5 | R14 R17 R19 R20 R21 | 100k | Resistor_SMD:R_0402_1005Metric | RC0402FR-07100KL | Yageo |  | 5x 100k 0402: CAM_PWR_EN pull-down (camera off in sleep/boot); nCHG open-drain pull-up (IO3 input + TP7; 33 uA only while charging); aux gate pull-down; AMP_PWR_EN pull-down: amp rail off while IO34 floats (reset, download, deep sleep); MAX98357A gain select GAIN_SLOT -> VAMP: 100k = 3 dB (fitted; 0 dBFS = 1.4 Vrms = 0.25 W, inside the speaker's 300 mW rating at any firmware volume), 0R = 6 dB (0.5 W = the speaker's maximum; louder bench option), DNP = 9 dB (clips from 3.3 V) | PCB
1 | R15 | 100 | Resistor_SMD:R_0402_1005Metric | RC0402FR-07100RL | Yageo |  | piezo drive series | PCB
1 | SW1 | B3U-3000P | mcring:SW_Omron_B3U-3000P | B3U-3000P | Omron |  | side-actuated tactile switch 3.0x2.5x1.2 mm | PCB
1 | TP1 | TP_IO0 | TestPoint:TestPoint_Pad_D1.0mm |  |  |  | test pad IO0 | PCB
1 | TP2 | TP_EN | TestPoint:TestPoint_Pad_D1.0mm |  |  |  | test pad EN | PCB
1 | TP3 | TP_USB_DM | TestPoint:TestPoint_Pad_D1.0mm |  |  |  | test pad USB_DM | PCB
1 | TP4 | TP_USB_DP | TestPoint:TestPoint_Pad_D1.0mm |  |  |  | test pad USB_DP | PCB
1 | TP5 | TP_GND | TestPoint:TestPoint_Pad_D1.0mm |  |  |  | test pad GND | PCB
1 | TP6 | TP_3V3 | TestPoint:TestPoint_Pad_D1.0mm |  |  |  | test pad 3V3 | PCB
1 | TP7 | TP_nCHG | TestPoint:TestPoint_Pad_D1.0mm |  |  |  | test pad nCHG | PCB
1 | TP8 | TP_VBAT | TestPoint:TestPoint_Pad_D1.0mm |  |  |  | test pad VBAT | PCB
1 | TPAD1 | TOUCH | mcring:PAD_Touch_3x4mm |  |  |  | 3 x 4 mm copper touch pad on the top face (ESP32-S3 touch T8) | PCB
1 | U1 | ESP32-S3-MINI-1U-N4R2 | RF_Module:ESP32-S3-MINI-1U | ESP32-S3-MINI-1U-N4R2 | Espressif |  | Wi-Fi/BLE module, 4 MB flash + 2 MB quad PSRAM, u.FL (mates with ANT1); pin table VERIFY | PCB
3 | U2 U9 U11 | TPS22916CYFPR | mcring:TPS22916_DSBGA-4_YFP | TPS22916CYFPR | TI |  | 3x TPS22916CYFPR TPS22916_DSBGA-4_YFP: camera rail load switch (3V3 -> CAM_3V3); ball map VERIFY; WS2812 supply gate (3V3 -> VLED), kills ~0.6-1 mA LED idle current; ON = IO33; speaker amp rail gate (3V3 -> VAMP), ON = IO34 (AMP_PWR_EN, PIN_SPEAKER_EN); amp group draws nothing while open; OPTIONAL speaker group | PCB
1 | U3 | XC6206P282MR | Package_TO_SOT_SMD:SOT-23 | XC6206P282MR-G | Torex | C2891263 | 2.8 V LDO for OV2640 AVDD (-G = halogen-free suffix of the same part) | PCB
1 | U4 | XC6206P122MR | Package_TO_SOT_SMD:SOT-23 | XC6206P122MR | Torex |  | 1.2 V LDO for OV2640 DVDD (DNP if the module regulates DVDD itself) | PCB
1 | U5 | DRV2605LDGS | Package_SO:VSSOP-10_3x3mm_P0.5mm | DRV2605LDGST | TI | C425927 | haptic driver, I2C 0x5A, LRA closed loop, EN tied to 3V3 (standby via I2C); pin numbers VERIFY | PCB
1 | U6 | LIS2DW12TR | Package_LGA:LGA-12_2x2mm_P0.5mm | LIS2DW12TR | ST | C189624 | accelerometer, I2C 0x18 (SA0=GND), CS=VDD_IO for I2C; pins VERIFY | PCB
1 | U7 | BQ25100AYFPR | mcring:BQ25100_DSBGA-6_YFP | BQ25100AYFPR | TI | C2871910 | Li-ion charger 10-250 mA, 1 mA termination; ball map VERIFY | PCB
1 | U8 | TPS62840DLCR | Package_TO_SOT_SMD:SOT-583-8 | TPS62840DLCR | TI | C2071859 | 750 mA buck, 60 nA IQ, Vout set by VSET resistor (3.3 V code); pins VERIFY | PCB
1 | U10 | MAX98357AETE+T | Package_DFN_QFN:QFN-16-1EP_3x3mm_P0.5mm_EP1.7x1.7mm | MAX98357AETE+T | Analog Devices (Maxim) | C910544 | I2S class-D mono amp, 16-TQFN 3x3x0.75 mm; VDD = VAMP (gated 3V3), SD_MODE = VAMP (left), gain via R21; BCLK IO35, LRCLK IO36, DIN IO37 through R22-R24 1k; OPTIONAL speaker group (fit with U11, C25, C26, R20-R24, LS1 or omit all); pin table VERIFY | PCB
1 | ANT1 | 2.4 GHz flex antenna, MHF1 | offboard:Antenna_Flex_34.9x9mm_MHF1 | 146153-0050 | Molex |  | 2.4 GHz flex dipole 34.9 x 9 x 0.1 mm, 50 mm MHF1 (u.FL) pigtail -> U1 u.FL (mated plug 2.9 mm tall = board_params top_max_height). Route down the back wall / along the band, >= 5 mm from cell and LRA; size vs the band is a fit check | off-board
1 | BT1 | 301012 LiPo 30 mAh | offboard:Cell_301012_3x10x12mm | 301012 (30 mAh, with PCM) | generic — see hardware/bom/stage1-ring.csv |  | 3 x 10 x 12 mm LiPo cell with PCM, 1C max charge; leads terminated in the W1 Pico-EZmate plug by the cell seller, a cable shop or PCBWay (never hot air or flame near the pouch, docs/10 §7) and plugged into J1 — no solder on the board | off-board
2 | CP1 CP2 | charging contact 3x2 mm ENIG | offboard:Pad_ENIG_3x2mm |  | PCB coupon or brass insert |  | 2x charging contact 3x2 mm ENIG Pad_ENIG_3x2mm: inner-band pogo contact, 3 x 2 mm ENIG, flush, >= 3 mm from the other pad; +5 V from the pogo cradle; the W2 pigtail's bare end is bonded to it with silver conductive pen after threading (<= 25 mA path; a contact fitted beforehand cannot pass the Ø1.1 band channel, docs/10 §7); inner-band pogo contact, 3 x 2 mm ENIG, flush, >= 3 mm from the other pad; GND return; the W2 pigtail's bare end is bonded to it with silver conductive pen after threading (<= 25 mA path; a contact fitted beforehand cannot pass the Ø1.1 band channel, docs/10 §7) | off-board
1 | LS1 | AS01008MR-2-R | offboard:Speaker_10mm_x2.9mm | AS01008MR-2-R | PUI Audio |  | 10 mm x 2.9 mm (max) 8 ohm micro speaker, 300 mW rated / 500 mW max, 86 dB, top port, NdFeB magnet, solder pads; in the enclosure's speaker pocket (board_params.json speaker_mm), its leads -> W4 plug -> J5; polarity irrelevant (single driver) | off-board
1 | M1 | LRA0825BC-0167F | offboard:LRA_8x2.5mm | LRA0825BC-0167F | INEED |  | 8 x 2.5 mm coin LRA, 240 Hz, 1.25 Vrms max (set RATED_V/OD_CLAMP for 1.25 Vrms @ 240 Hz, docs/07-build-guide.md §1.8); off-board in the floor pocket, leads -> W3 plug -> J4 | off-board
4 | W1 W2 W3 W4 | Pico-EZmate 2-ckt pigtail | offboard:Pigtail_PicoEZmate_2ckt | 36920-0203 (300 mm, cut in half) | Molex |  | 4x Pico-EZmate 2-ckt pigtail Pigtail_PicoEZmate_2ckt: BAT: 28 AWG pre-crimped pigtail, plug into J1; bare end to the cell's two leads (≈ 25 mm, joint made by the supplier); CHG: 28 AWG pre-crimped pigtail, plug into J3; bare ends to CP1/CP2 through the band channels (≈ 85 mm per wire); LRA: 28 AWG pre-crimped pigtail, plug into J4; bare end to the LRA's two leads (≈ 25 mm); SPK: 28 AWG pre-crimped pigtail, plug into J5; bare end to the speaker's two terminals (≈ 15 mm) | off-board
1 | SW2 | B3U-1000P | mcring:SW_Omron_B3U-1000P | B3U-1000P | Omron |  | optional IO0 boot button (top-actuated), DNP | PCB | DNP
1 | PZ1 | PKMCS0909E4000-R1 | offboard:Piezo_9x9x1.9mm | PKMCS0909E4000-R1 | Murata |  | 4 kHz piezo sounder 9 x 9 x 1.9 mm (LTB) — optional; fit only if the enclosure gets a 9 x 9 x 2 pocket (none in the current CAD); any 2-wire piezo element also works | off-board | DNP
