calebynhan/mcring/hardware/pcb/out/mcring_v1_bom_jlc.csv

Comment | Designator | Footprint | LCSC Part #
10u | C1,C2,C4,C25 | 0603 | C77041
100u | C3 | 1206
100n | C5,C13,C14,C17,C18,C19,C20,C22,C23,C24,C26 | 0402 | C71629
1u | C6,C7,C8,C9,C10,C11,C12,C15,C16,C21 | 0402 | C76999
WS2812B-2020 | D1 | 2020 PLCC4 | C965555
PESD5V0S1BB,115 | D2 | SOD-523
PMEG2005EB,115 | D3 | SOD-523
FH12-24S-0.5SH(55) | FPC1 | FH12-24 0.5 mm horizontal | C202112
78171-0002 | J1,J3,J4,J5 | Pico-EZmate 1x2 vertical
DFE201610E-2R2M=P2 | L1 | 0806
T3902 | MK1 | T3902 3.5x2.65 bottom port
AO3400A | Q1 | SOT-23 | C20917
10k | R1,R2,R16 | 0402 | C60490
4.7k | R3,R4,R5,R6,R18 | 0402 | C105871
1k | R7,R13,R22,R23,R24 | 0402
1M | R8,R9 | 0402
9.1k | R10 | 0402
11.5k | R11 | 0402
267k | R12 | 0402
100k | R14,R17,R19,R20,R21 | 0402
100 | R15 | 0402
B3U-3000P | SW1 | B3U-3000P side switch
ESP32-S3-MINI-1U-N4R2 | U1 | ESP32-S3-MINI-1U (65 pads)
TPS22916CYFPR | U2,U9,U11 | DSBGA-4 0.4 mm (YFP)
XC6206P282MR-G | U3 | SOT-23 | C2891263
XC6206P122MR | U4 | SOT-23
DRV2605LDGST | U5 | VSSOP-10 3x3 | C425927
LIS2DW12TR | U6 | LGA-12 2x2 0.5 mm | C189624
BQ25100AYFPR | U7 | DSBGA-6 0.4 mm (YFP) | C2871910
TPS62840DLCR | U8 | SOT-583-8 | C2071859
MAX98357AETE+T | U10 | QFN-16 3x3 EP | C910544
