calebynhan/mcring/hardware/cad/out/mcring_stage1_assembly.step

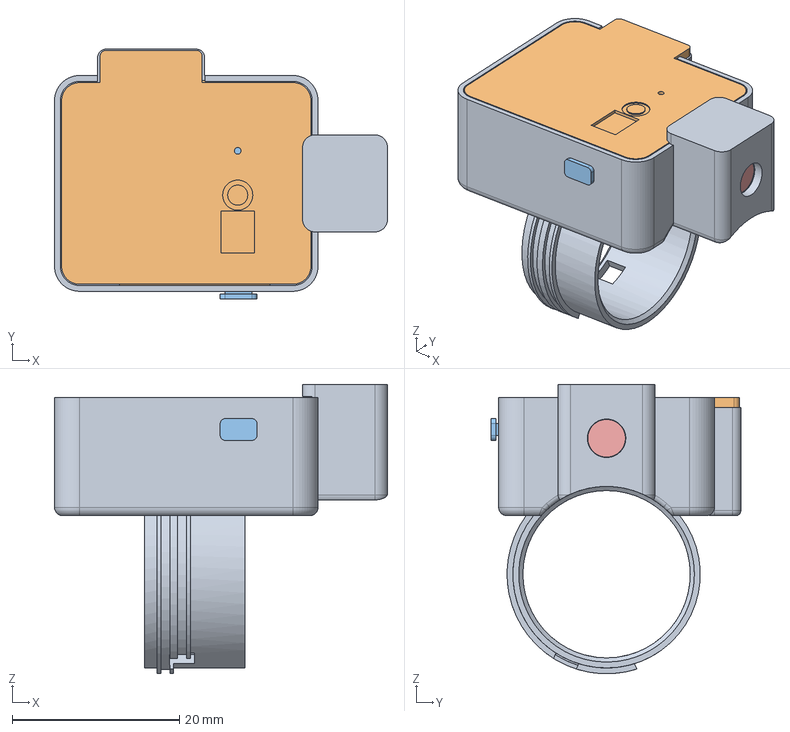
[picture p14: CAD file, 2026-10-25]
hardware/cad/out/mcring_stage1_assembly.step
39.8 x 29.9 x 34.6 mm
