calebynhan/mcring/hardware/cad/out/mcring_stage1_shell.stl

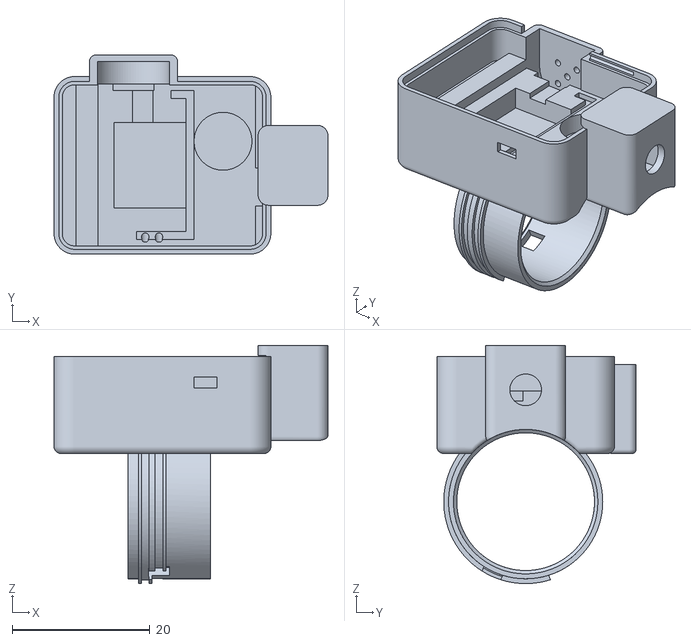
[picture p15: CAD file, 2026-10-25]
hardware/cad/out/mcring_stage1_shell.stl
39.8 x 28.9 x 34.6
