calebynhan/mcring/hardware/cad/out/mcring_stage1_lid.stl

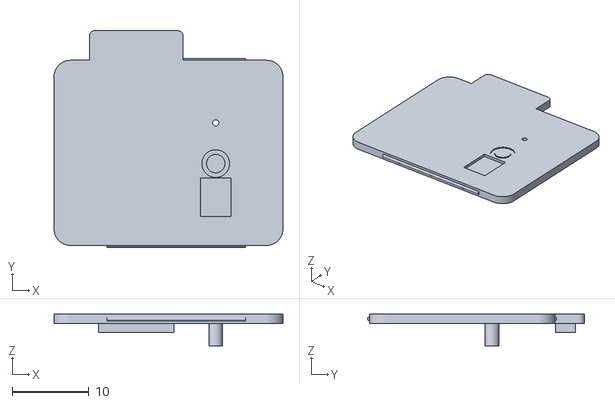
[picture p16: CAD file, 2026-10-25]
hardware/cad/out/mcring_stage1_lid.stl
29.8 x 28.2 x 4.10
