calebynhan/mcring/hardware/cad/out/mcring_stage1_key.stl

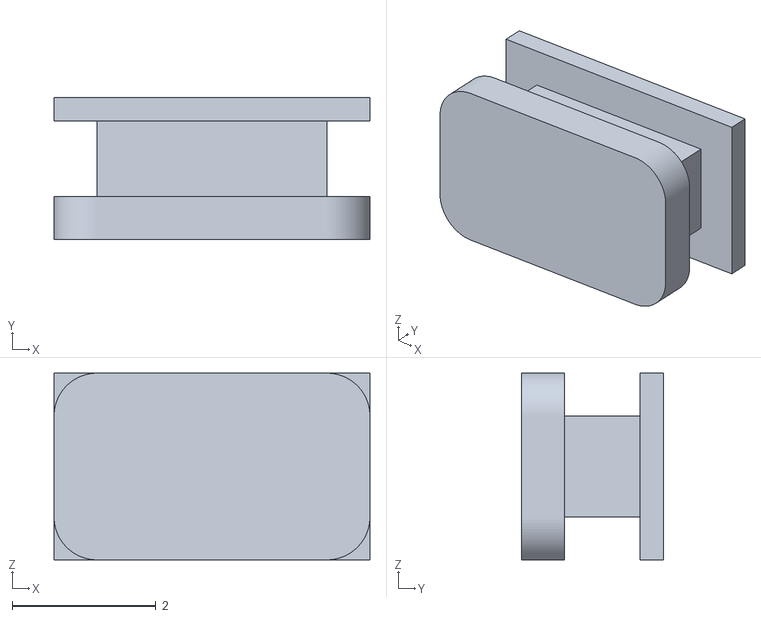
[picture p17: CAD file, 2026-10-25]
hardware/cad/out/mcring_stage1_key.stl
4.40 x 1.98 x 2.60
