calebynhan/mcring/hardware/pcb/wiring_stage0_solderless.md

# Stage-0 bench wiring — NO-SOLDER variant (XIAO ESP32S3 Sense in the Expansion Board Base)

Drawing: `out/wiring_stage0_solderless.svg` / `.png` (generated by `wiring_stage0_solderless.py`). The soldered breadboard rig is `wiring_stage0.md`; this page replaces it for an owner who does not want to pick up an iron. Pin map = `BOARD_XIAO_ESP32S3_SENSE` + `MCRING_XIAO_BASE` (`firmware/ring-esp32s3/src/config.h` + `config_audio.h`), built with `pio run -e xiao_esp32s3_sense_base -t upload`. Kit: `hardware/bom/stage0-devkit-solderless.csv`; sourcing evidence and the unverified items: `docs/research/04-no-solder-sourcing.md`.

**Joint count: 0.** The pre-soldered XIAO seats in the base, the base already carries the button, buzzer, LiPo socket and charger, the haptic driver comes with its motor attached on a Grove module, the accelerometer is a STEMMA QT board fed from a Grove→QT cable, and the one (optional) interrupt wire is a jumper into the base's female breakout header. The optional speaker amp is the only part whose header holes are unsoldered (its speaker terminal block is pre-soldered) — press-fit pins, five joints at a makerspace, or wait for stage 1 where the amp is on the board.

## Connections

| From | To | Detail | Colour in the drawing |
|---|---|---|---|
| XIAO ESP32S3 Sense (pre-soldered, Seeed 102010635) | Expansion Board Base socket | pins down into the base's two 7-pin female headers; USB-C toward the base's USB end; Sense board (camera) expected on top, facing away from the base — **unverified**: before ordering, confirm on the 102010635 product photo that the headers are on the side *opposite* the Sense board; after seating, the §1.5 first photo must not be of the base PCB | — |
| Base user button | D1 (GPIO2) = `PIN_BUTTON` | already wired on the base; hold = ask, short press = photo, EXT0 deep-sleep wake | on-base |
| Base passive buzzer | A3 = D3 (GPIO4) = `PIN_BUZZER` | already wired on the base (cuttable trace); beep cues are off by default (`cues_mask` bit 2) | on-base |
| Base Grove I²C #1 | Grove – Haptic Motor (Seeed 105020011) | DRV2605L 0x5A + factory-attached ERM; one Grove cable; `HAPTIC_MOTOR_LRA 0` → `drv2605_init(false)` | slate (Grove) |
| Base Grove I²C #2 | Grove → STEMMA QT / Qwiic cable → LIS3DH breakout QT socket | Adafruit 4528 or SparkFun PRT-15109; LIS3DH = Adafruit 2809 (0x18) or SparkFun SEN-29529 (0x19); WHO_AM_I 0x33, detected at boot | slate (Grove/QT) |
| LIS3DH `INT` through-hole | base breakout header **D8** (GPIO7) = `PIN_IMU_INT` | male-male jumper; the breakout end is a press-fit pin / hammer-header pin / IC hook. **Optional**: with `MCRING_XIAO_BASE` the firmware polls the latched click source every 25 ms and ignores D8 (`PIN_IMU_INT` parked: without the wire D8 floats — it is also the SD clock — and would wake the ring at random). Tap-to-wake from deep sleep needs the wire **and** `pio run -e xiao_esp32s3_sense_base_tapwake` (`-DMCRING_IMU_INT_WIRED`); without both the ring wakes on the button only | purple |
| Base JST 2.0 LiPo socket | LiPo 1S **≥ 400 mAh**, JST-PH, with PCM (Adafruit 3898 / 1578) | the base charges at up to 460 mA — too much for the 100 mAh ring cell (Adafruit 1570, 1 C = 100 mA); check red = + against the silkscreen | dark red / black |
| Base microSD slot | — (leave empty) | CS = D2 (GPIO3) → `PIN_HAPTIC` is parked at −1 in this build; SPI assumed on D8/D9/D10 (shared with INT1 / touch / I²S DIN) | — |
| Base OLED 0x3C, RTC 0x51 | — (unused) | share the I²C bus; no clash with 0x5A / 0x18 / 0x19; RTC INT routing not verified — leave its jumper open | — |
| Base Grove A0/D0 | — (n/c) | A0 = GPIO1: `PIN_BATTERY_ADC` is parked at −1 in this build (an open pin reads noise, which could fire LOW_BATTERY); STATUS shows battery 255 % (unknown). A 100 k/100 k divider could be built on a breadboard from here (then add `-DMCRING_BATT_DIVIDER_WIRED`), but the cell's + is only on the JST pigtail → not in the kit | grey |
| Base Grove UART (D7 RX, D6 TX) | **optional** MAX98357A `BCLK` (D7 / GPIO44), `LRC` (D6 / GPIO43), `VIN` (3V3), `GND` | 'Grove to 4-pin male jumper' cable (Seeed 110990210) into female jumpers / the amp's press-fit pins; the base silkscreen says which Grove pin is D6 and which D7 — swap BCLK/LRC if silent. Never plug a UART Grove *device* here | teal / red / black, dashed |
| Base breakout header D10 (GPIO9) | **optional** MAX98357A `DIN` | male-male jumper; `PIN_AUX` is −1 on the XIAO (air-puff experiment parked) | teal, dashed |
| MAX98357A `SD` | `VIN` (3V3) | left-channel mode; the breakout's own pull-up ((L+R)/2) works too — mono is written into both slots | red, dashed |
| MAX98357A `+ / −` terminal block | 8 Ω speaker with leads: Adafruit 3923 (1 W mini oval) | its ~30 mm leads end in a Molex PicoBlade plug: snip the plug off and strip ~5 mm of each lead (wire stripper, no solder) into the screw terminal, which is pre-soldered on Adafruit 3006 since 2024-06; polarity irrelevant; GAIN open = 9 dB → keep volume ≤ 200. Not the PUI AS01008MR-2-R: that 10 mm stage-1 part has solder pads | brown |
| XIAO BAT+/BAT− pads, 5V pin, D9 | — | unused: the cell lives in the base; nothing on 5V; D9 (touch) is the base's SD MISO — no touch pad on this rig | — |

## XIAO header as it appears on the base's breakout headers (top view, USB-C up)

| Left column | GPIO | Use on this rig | Right column | GPIO | Use on this rig |
|---|---|---|---|---|---|
| D0 / A0 | GPIO1 | battery sense — not built on this rig (A0/D0 Grove socket); `PIN_BATTERY_ADC` parked at −1 | 5V | VBUS | do not use |
| D1 | GPIO2 | BUTTON = the base's user button | GND | GND | GND |
| D2 | GPIO3 | the base's microSD CS — PIN_HAPTIC parked at −1 | 3V3 | 3V3 | 3.3 V out |
| D3 | GPIO4 | BUZZER = the base's passive buzzer (A3) | D10 | GPIO9 | I²S DIN — male-male jumper to the optional amp |
| D4 / SDA | GPIO5 | I²C SDA — both Grove I²C sockets, OLED, RTC | D9 | GPIO8 | touch — n/c (the base's SD MISO) |
| D5 / SCL | GPIO6 | I²C SCL — both Grove I²C sockets, OLED, RTC | D8 | GPIO7 | IMU INT1 ← LIS3DH INT (male-male jumper, optional; read only by the `_tapwake` env) |
| D6 / TX | GPIO43 | I²S LRC — the Grove UART socket (optional amp) | D7 / RX | GPIO44 | I²S BCLK — the Grove UART socket (optional amp) |

## What the `MCRING_XIAO_BASE` build changes (`config_audio.h`)

| Define | Stock XIAO build | `xiao_esp32s3_sense_base` | Why |
|---|---|---|---|
| `PIN_BUTTON` / `PIN_BUZZER` | 2 / 4 | 2 / 4 (restated) | the base's button is on D1 and its buzzer on A3 = D3 — same pins; restated so a base revision is a one-line change |
| `PIN_HAPTIC` | 3 (D2, DRV EN) | −1 | D2 is the base's microSD chip-select; the Grove module's EN is tied on-module |
| `HAPTIC_MOTOR_LRA` | 1 | 0 | Grove Haptic Motor is an ERM → `drv2605_init(false)`; autocal still runs |
| `IMU_POLL_MS` | 0 | 25 | the LIS3DH latches its click interrupt, so polling `CLICK_SRC` catches taps when INT1 is not jumpered |
| `PIN_IMU_INT` | 7 (D8) | −1; 7 with `-DMCRING_IMU_INT_WIRED` (env `xiao_esp32s3_sense_base_tapwake`) | without the jumper D8 floats (it is the SD clock line): no ISR and no EXT1 wake on it, the LIS3DH is powered down in deep sleep and the button wakes the ring |
| `PIN_BATTERY_ADC` | 1 (A0) | −1; 1 with `-DMCRING_BATT_DIVIDER_WIRED` | A0 is an open Grove pin on this rig; a floating ADC could report a bogus low battery |
| `BOARD_NAME` | `xiao-esp32s3-sense` | `xiao-esp32s3-sense+base` (`…+base+tapwake`) | the boot log tells you which build is running |

The IMU driver itself needs no flag: `imu_init()` reads WHO_AM_I at 0x18/0x19 and uses the LIS2DW12 (0x44) or the LIS3DH (0x33) back-end (`src/imu_lis3dh.cpp`). `trigger.cpp` sees the LIS2DW12 `TAP_SRC` bit layout for both.

## Parts

* Seeed XIAO ESP32S3 **Sense, pre-soldered** (102010635) — the camera + mic board is included
* Seeed **Expansion Board Base for XIAO** (103030356; Adafruit 5033)
* Seeed **Grove – Haptic Motor** (105020011): DRV2605L + ERM, one Grove plug
* Adafruit **LIS3DH STEMMA QT** (2809) or SparkFun Micro LIS3DH Qwiic (SEN-29529)
* Adafruit **Grove → STEMMA QT / Qwiic cable** (4528) or SparkFun PRT-15109
* male-male jumper wires (INT → D8; D10 → DIN); optionally one hammer-header strip (Adafruit 3662) for press-fit pins
* LiPo 1S **≥ 400 mAh** JST-PH with PCM (Adafruit 3898 or 1578) — not the 100 mAh ring cell on this charger
* optional speaker path: Adafruit MAX98357A (3006, terminal block pre-soldered), an 8 Ω speaker with leads (Adafruit 3923 — snip its PicoBlade plug), a 'Grove to 4-pin male jumper' cable (Seeed 110990210) for the Grove-UART socket, female-female jumpers
* USB-C data cable; Bluetooth headphones paired to the laptop/phone (that is where answers come out — the ring speaker is optional)

## Check before power-on

1. XIAO orientation in the base socket: USB-C toward the base's USB end, D0 at the base's D0 silkscreen. A reversed board is dead.
2. Sense board fully clicked onto both B2B connectors; camera FPC latched. The header side of the pre-soldered XIAO is **unverified**: the §1.5 first photo must show the room, not the base PCB.
3. LiPo: red = + on the base's JST silkscreen (a Seeed forum thread reports reversed pigtails on early units; never force a plug). Cell ≥ 400 mAh — the charger is 460 mA.
4. Grove Haptic Motor and the Grove→QT cable sit in the two **I²C** sockets, not in UART (= I²S D6/D7) or A0/D0.
5. LIS3DH INT jumper → **D8** only (never 3V3 / 5V). Leaving it off is allowed: the firmware polls, and the default build ignores D8 (button-only wake). With the jumper fitted, flash `-e xiao_esp32s3_sense_base_tapwake` for tap-to-wake from deep sleep.
6. microSD slot empty (CS = D2, SPI shares D8/D9/D10).
7. Nothing on the 5V header pin. Amp (optional) VIN = 3V3, SD → VIN, GAIN open.
8. Speaker leads only in the amp's +/− terminal block.
9. First power from USB with the cell unplugged, then plug the cell: the base's charge LED lights.
10. Boot log: `fw 0.1.0 (xiao-esp32s3-sense+base)`, `I imu: LIS3DH ready at 0x18 …`, `I drv: DRV2605L ready (ERM)`, `autocal ok`; status flags `0x5e` (camera + IMU + mic + haptic + speaker); `batt=0mV(255%)` is expected (no divider).
11. Deep sleep with the base fitted is milliamps (OLED, RTC, charger, no camera power gate): use the soldered rig or stage 1 for sleep numbers.
12. Flash with `-e xiao_esp32s3_sense_base` (or `…_base_tapwake` with the INT jumper). The stock `xiao_esp32s3_sense` env still boots but drives the ERM with the LRA profile (`autocal FAILED`) and toggles D2 — the base's SD CS — as the haptic enable.

## Not verified (fetch of the base's schematic was blocked)

* whether the base's charger feeds the XIAO's BAT pads or only the 5V/VIN pin (the XIAO's own `BAT` pads are unused either way);
* the base's SD SPI pins (assumed D8/D9/D10 = the XIAO's SPI) and the RTC INT jumper;
* whether Adafruit 3662 hammer-header pins hold in the 1.0 mm holes of Adafruit/SparkFun breakouts;
* the header orientation of the pre-soldered XIAO Sense (102010635): pins on the side opposite the Sense board is assumed (docs/research/04 §A1 marks it unverified) — if they are on the B2B side, the camera faces the base PCB;
* list prices (October 2026 snippets): `hardware/bom/stage0-devkit-solderless.csv`.
