calebynhan/mcring/hardware/pcb/wiring_stage0.md

# Stage-0 bench wiring — XIAO ESP32S3 Sense

Drawing: `out/wiring_stage0.svg` / `.png` (generated by `wiring_stage0.py`). Pin map = `BOARD_XIAO_ESP32S3_SENSE` in `firmware/ring-esp32s3/src/config.h` + `config_audio.h` (also `hardware/pinmap.md`). The MAX98357A amp + speaker are optional: without them D6/D7/D10 stay open and the firmware still runs (`HAS_SPEAKER` is 1 on this board, so the I²S pins just drive nothing).

## Connections

| From | To | Detail | Colour |
|---|---|---|---|
| XIAO D0 / A0 (GPIO1) | divider mid-point | BAT+ → R1 100 kΩ → **A0** → R2 100 kΩ → GND; C1 100 nF A0–GND | green |
| XIAO D1 (GPIO2) | tactile button → GND | internal pull-up, EXT0 deep-sleep wake | green |
| XIAO D2 (GPIO3) | DRV2605L EN (optional) | only if the breakout exposes EN; otherwise leave open (pull-up on the breakout) | grey, dashed |
| XIAO D3 (GPIO4) | piezo (+) | piezo (−) → GND; LEDC tone | green |
| XIAO D4 (GPIO5) | SDA | DRV2605L SDA + LIS2DW12 SDA | blue |
| XIAO D5 (GPIO6) | SCL | DRV2605L SCL + LIS2DW12 SCL | amber |
| XIAO D8 (GPIO7) | LIS2DW12 INT1 | double-tap interrupt, EXT1 wake (any-high) | purple |
| XIAO D9 (GPIO8) | touch pad (optional) | copper foil / coin via 1 kΩ; touch channel T8 | grey, dashed |
| XIAO D10 (GPIO9) | MAX98357A DIN (optional speaker) | I²S data; **was `PIN_AUX`** — `config_audio.h` reassigns D10 and sets `PIN_AUX` −1 on the dev kit (the air-puff experiment is parked) | teal |
| XIAO D7 / RX (GPIO44) | MAX98357A BCLK (optional speaker) | I²S bit clock, 32 × fs = 512 kHz at 16 kHz; UART0 RXD0 is free (logging is USB-CDC) | teal |
| XIAO D6 / TX (GPIO43) | MAX98357A LRC (optional speaker) | I²S word clock = 16 kHz; UART0 TXD0 — the ROM banner at reset is ~50 ms of garbage frames without BCLK, inaudible | teal |
| XIAO 3V3 | DRV2605L VIN, LIS2DW12 VDD (+ CS), MAX98357A VIN + SD | 3.3 V regulator output; SD → 3V3 = left-channel mode (the breakout's own pull-up, (L+R)/2, works too: mono is written into both slots) | red |
| XIAO GND | DRV2605L GND, LIS2DW12 GND, LIS SA0, MAX98357A GND, button, piezo, divider, C1 | common ground | black |
| XIAO BAT+ / BAT− (underside pads) | LiPo 1S 100 mAh (PCM) | BAT+ also feeds the divider | dark red / black |
| DRV2605L OUT+ / OUT− | LRA 8 mm (INEED LRA0825BC-0167F) | polarity irrelevant; closed-loop LRA mode | brown |
| MAX98357A + / − terminal | 10 mm 8 Ω speaker (PUI AS01008MR-2-R, or a 1 W 8 Ω oval for the bench) | polarity irrelevant; GAIN left open = 9 dB; `PIN_SPEAKER_EN` is −1 on the dev kit, so the amp idles at ~2.4 mA | brown |
| XIAO 5V | — | leave open | — |
| Sense board | B2B on top of the XIAO | OV2640 DVP (GPIO10–18, 38–40, 47, 48), PDM mic (GPIO41/42) | — |

## XIAO header (top view, USB-C up)

| Left column | GPIO | Use | Right column | GPIO | Use |
|---|---|---|---|---|---|
| D0 / A0 | GPIO1 | BAT_SENSE | 5V | VBUS | n/c |
| D1 | GPIO2 | BUTTON | GND | GND | GND |
| D2 | GPIO3 | HAPTIC (DRV EN) | 3V3 | 3V3 | 3.3 V out ≤ 700 mA |
| D3 | GPIO4 | BUZZER | D10 | GPIO9 | I²S DIN |
| D4 / SDA | GPIO5 | I²C SDA | D9 | GPIO8 | TOUCH (optional pad) |
| D5 / SCL | GPIO6 | I²C SCL | D8 | GPIO7 | IMU INT1 |
| D6 / TX | GPIO43 | I²S LRC (amp) | D7 / RX | GPIO44 | I²S BCLK (amp) |

## Parts

* Seeed XIAO ESP32S3 **Sense** (camera + mic expansion board included)
* DRV2605L breakout (Adafruit 2305 or clone) + 8 mm LRA (INEED LRA0825BC-0167F, or any 2.5–3.3 mm coin LRA)
* LIS2DW12 breakout (SA0 pin accessible); 0.1 µF already on the breakout
* 6 × 6 mm tactile button, 12 mm piezo sounder, 2 × 100 kΩ 1 %, 1 × 100 nF
* LiPo 1S 100 mAh with PCM (XIAO charger ≈ 100 mA, so ~1 C — fine)
* optional: MAX98357A I²S amp breakout (Adafruit 3006 or clone) + a 10 mm 8 Ω speaker (PUI AS01008MR-2-R — the stage-1 part — or a 1 W 8 Ω oval such as Adafruit 3923) on BCLK D7 / LRC D6 / DIN D10, SD + VIN → 3V3
* breadboard + jumper wires; optional copper-foil touch pad + 1 kΩ

## Check before power-on

1. **LiPo polarity**: red → BAT+, black → BAT− on the underside pads; the cell has a PCM. Nothing on the 5V pin.
2. Ohmmeter: BAT+ ↔ GND and 3V3 ↔ GND read kΩ, not 0 Ω.
3. Divider is BAT+ → 100 k → A0 → 100 k → GND with 100 nF on A0; A0 never sees more than VBAT/2 ≈ 2.1 V.
4. DRV2605L VIN = 3V3 (not 5 V); OUT+/OUT− only to the LRA. In firmware the LRA rated voltage is ≤ 1.25 Vrms.
5. One SDA, one SCL shared by both breakouts; their on-board pull-ups are enough — add none.
6. LIS2DW12 SA0 → GND (address 0x18); CS → 3V3 if exposed; INT1 → D8 only.
7. Button and piezo return to GND, never to 3V3.
8. Keep D1 (button) released at reset; D6/D7 carry I²S once the amp is fitted (USB-CDC logging is the default anyway).
9. Sense board fully seated on both B2B connectors, camera FPC latched.
10. First power from USB with the cell disconnected → 3V3 = 3.3 V; then connect the cell, charge LED on.
11. Boot log / `i2cdetect` lists **0x18** and **0x5A**.
12. ~3 mA deep-sleep current with the Sense board attached is expected on the dev kit (no camera power gate).
13. Speaker amp (optional): VIN = 3V3 (not 5 V), SD → 3V3, GAIN open; BCLK → D7, LRC → D6, DIN → D10; the speaker only on the amp's +/− terminal, never to GND or 3V3. Expect ~2.4 mA extra idle current (no SD GPIO on the dev kit).
14. With the amp fitted D10 is no longer `PIN_AUX` — the air-puff experiment is parked on the dev kit.
