calebynhan/mcring/hardware/pcb/out/wiring_stage0.png

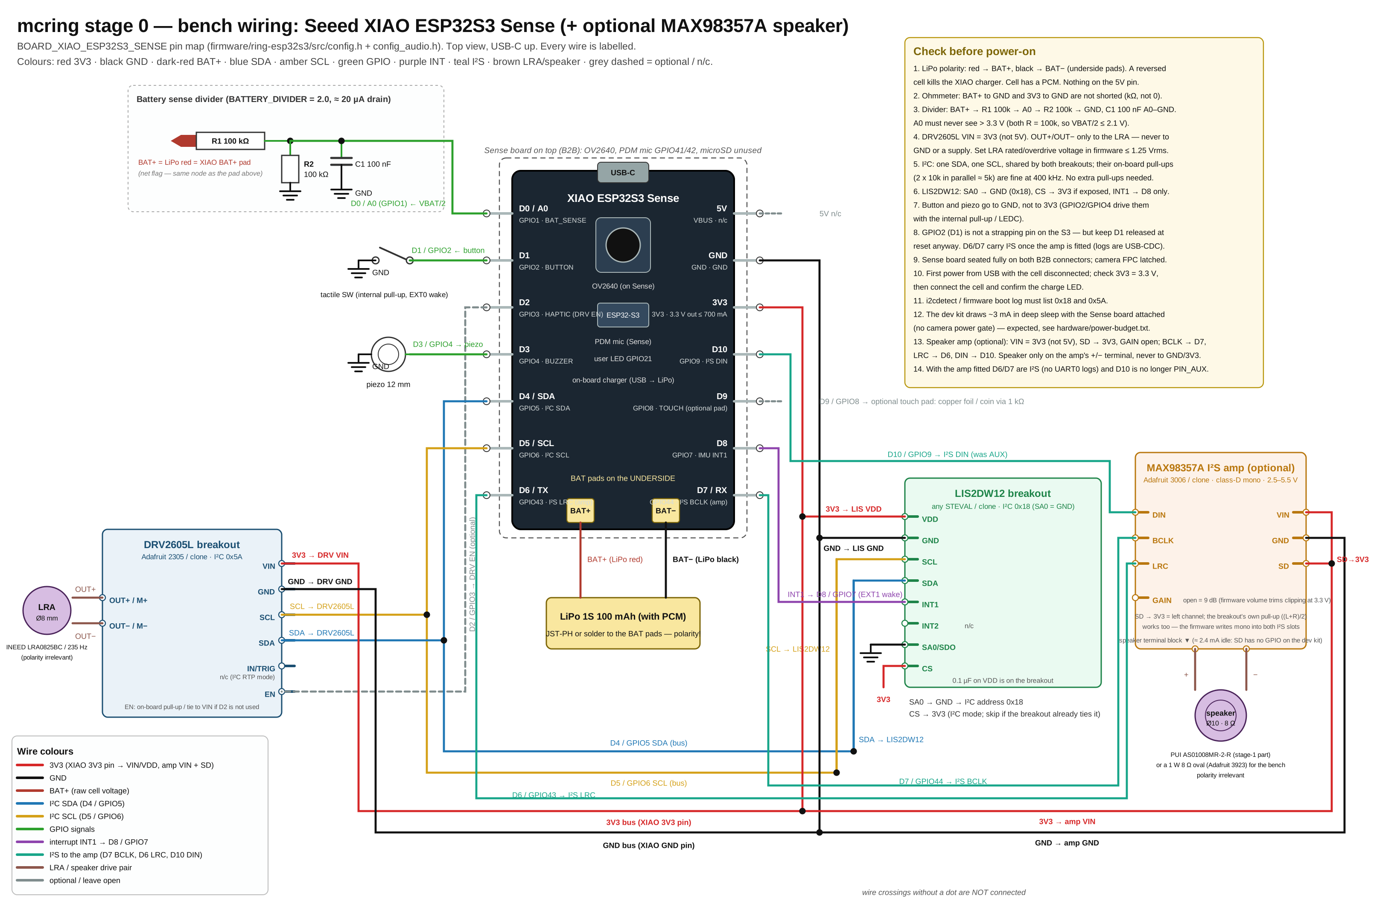
hardware/pcb/out/wiring_stage0.png
