calebynhan/mcring/hardware/pcb/out/wiring_stage0_solderless.png

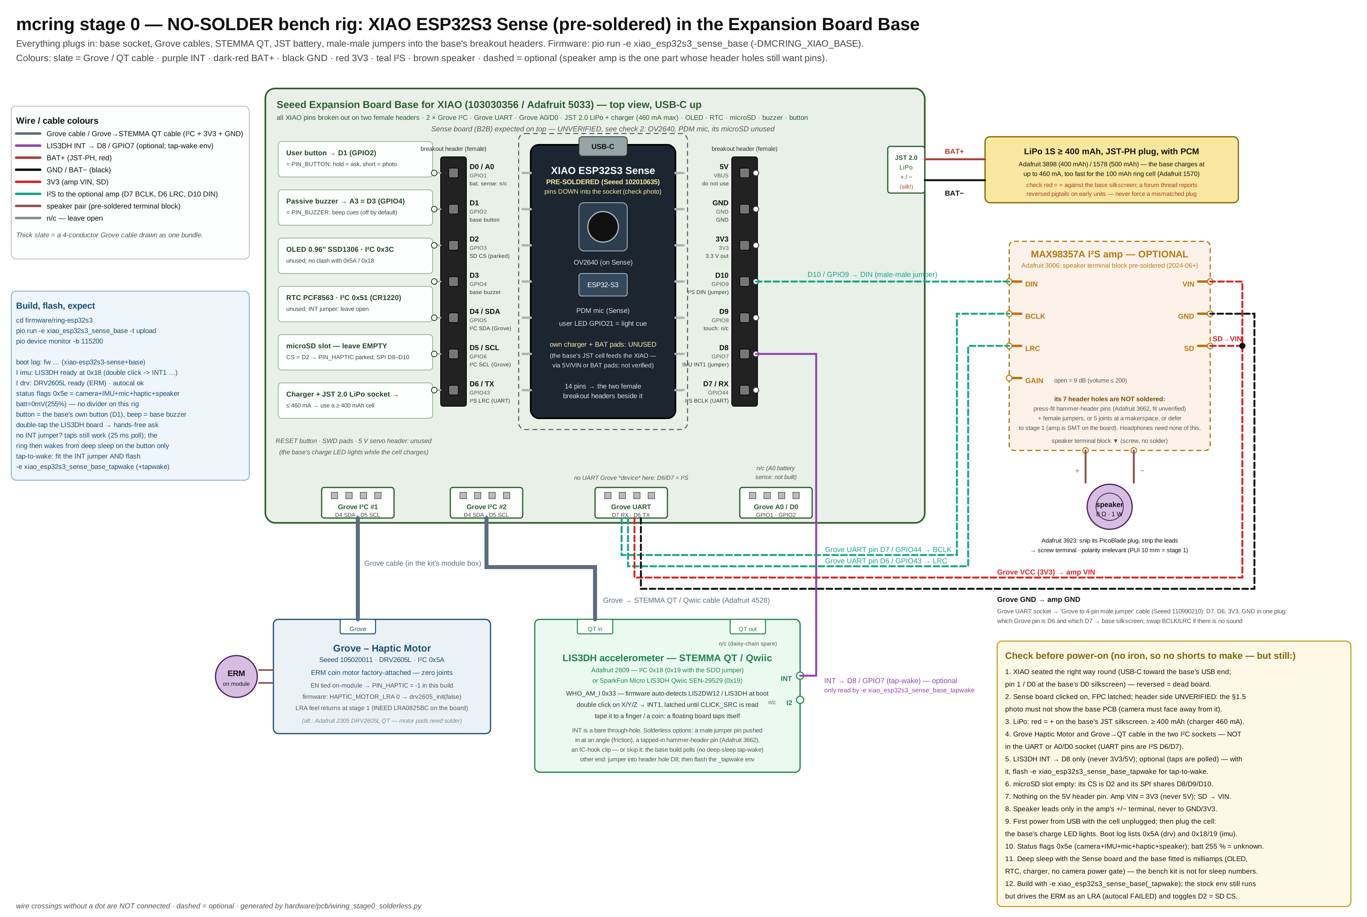
hardware/pcb/out/wiring_stage0_solderless.png
