calebynhan/mcring/firmware/ring-esp32s3/src/config_audio.h

#define MCRING_CONFIG_AUDIO_H
#if defined(BOARD_XIAO_ESP32S3_SENSE)
  #define PIN_I2S_BCLK     44    // D7
  #define PIN_I2S_LRCLK    43    // D6
  #define PIN_I2S_DOUT      9    // D10 (was PIN_AUX)
  #define PIN_SPEAKER_EN   -1    // MAX98357A SD tied high / breakout pull-up: amp always enabled
  #define PIN_AUX          -1    // reassigned to I2S DIN (feedback.cpp compiles the aux channel out)
#elif defined(BOARD_MCRING_V1)
  #define PIN_I2S_BCLK     35    // U10 BCLK  (net I2S_BCLK),  32 x fs = 512 kHz at 16 kHz
  #define PIN_I2S_LRCLK    36    // U10 LRCLK (net I2S_LRCLK), fs = 16 kHz
  #define PIN_I2S_DOUT     37    // U10 DIN   (net I2S_DOUT)
  #define PIN_SPEAKER_EN   34    // U11 TPS22916 ON (net AMP_PWR_EN, 100k pull-down R20): HIGH powers the amp rail
#else
  #define PIN_I2S_BCLK     -1
  #define PIN_I2S_LRCLK    -1
  #define PIN_I2S_DOUT     -1
  #define PIN_SPEAKER_EN   -1
#endif
#if defined(MCRING_XIAO_BASE)
  #if !defined(BOARD_XIAO_ESP32S3_SENSE)
    #error "MCRING_XIAO_BASE is a variant of BOARD_XIAO_ESP32S3_SENSE (platformio env xiao_esp32s3_sense_base)"
  #endif
  #undef  BOARD_NAME
  #if defined(MCRING_IMU_INT_WIRED)
    #define BOARD_NAME      "xiao-esp32s3-sense+base+tapwake"
  #else
    #define BOARD_NAME      "xiao-esp32s3-sense+base"
  #endif
  #undef  PIN_BUTTON
  #define PIN_BUTTON         2     // base user button → D1 (GPIO2) to GND; RTC GPIO → EXT0 deep-sleep wake as before
  #undef  PIN_BUZZER
  #define PIN_BUZZER         4     // base passive buzzer → A3 = D3 (GPIO4), cuttable trace on the base
  #undef  PIN_HAPTIC
  #define PIN_HAPTIC        -1     // D2 (GPIO3) is the base's microSD CS; haptics are I²C-only (RTP + STANDBY), like mcring_v1
  #define HAPTIC_MOTOR_LRA   0     // Grove Haptic Motor = ERM → drv2605_init(false) in main.cpp
  #define IMU_POLL_MS       25     // poll the latched tap source every 25 ms (≈ 0.25 % of the I²C bus) — INT1 → D8 optional
  #if !defined(MCRING_IMU_INT_WIRED)
    #undef  PIN_IMU_INT
    #define PIN_IMU_INT     -1     // D8 may float (no jumper): no ISR, no EXT1 tap-wake; LIS3DH off in deep sleep
  #endif
  #if !defined(MCRING_BATT_DIVIDER_WIRED)
    #undef  PIN_BATTERY_ADC
    #define PIN_BATTERY_ADC -1     // A0 is an open Grove pin on this rig: battery_mv() = 0 → STATUS 255 % (unknown)
  #endif
#endif
#ifndef HAPTIC_MOTOR_LRA
  #define HAPTIC_MOTOR_LRA   1     // every other build drives the 8 mm LRA closed-loop (autocal at boot)
#endif
#ifndef IMU_POLL_MS
  #define IMU_POLL_MS        0     // 0 = interrupt-driven only (PIN_IMU_INT)
#endif
#define HAS_SPEAKER  ((PIN_I2S_BCLK) >= 0 && (PIN_I2S_LRCLK) >= 0 && (PIN_I2S_DOUT) >= 0)
#define DEFAULT_SPEAKER_VOLUME     255                               // key 9: 0..255 (255 = unity)
#define DEFAULT_CUES_MASK          (MC_CUES_HAPTIC | MC_CUES_LED)    // key 10: haptic + LED cues, no beep
#define DEFAULT_MIC_SOURCE         MC_MIC_SRC_RING                   // key 11: ring mic records on long press
#define CUE_TICK_MS                60
#define AUDIO_OUT_SAMPLE_RATE      16000
#define AUDIO_OUT_QUEUE_BLOCKS     48     // × 132 B = 6.3 KB; 48 × 16 ms = 768 ms of audio (spec: ≥ 32)
#define AUDIO_OUT_PREBUFFER_BLOCKS 24     // start playback after ~400 ms is queued
#define AUDIO_OUT_REBUFFER_BLOCKS  8      // after an underrun, resume once this much has accumulated
#define AUDIO_OUT_DMA_BUF_COUNT    6      // 6 × 256 frames = 96 ms of DMA (covers BLE jitter + a 15 ms transfer tick)
#define AUDIO_OUT_DMA_BUF_LEN      256    // frames (stereo 16-bit → 1 KB per buffer)
#define LOW_BATTERY_PCT            15
#define LOW_BATTERY_REARM_PCT      20
