calebynhan/mcring/firmware/ring-nrf52840/src/mcring_cfg.h

#pragma once
#define MCRING_FW_VERSION "0.1.0-nrf"
#define MAX_QUEUED_CAPTURES 2
#define TRANSFER_ACK_TIMEOUT_MS 3000
#define TRANSFER_MAX_ROUNDS 5
#define MORSE_MAX_UNITS 1024
/* Frame geometry for the bit-banged camera (HM01B0 binned / OV7670 QQVGA) */
#define CAM_W 160
#define CAM_H 120
