calebynhan/mcring/(commit log)

2026-10-24 mcring: camera ring scope, research, firmware, backend, companions, hardware plan
    Complete first cut of the mcring project: a ring-sized camera that sends a photo
    over BLE to a phone, asks a multimodal LLM, and returns the answer as speech plus
    Morse code on the ring (haptic/LED/buzzer).
    Research (docs/research): three sourced reports on sub-3.5 mm camera modules,
    MCU/radio/power and ring batteries, and output actuators/triggers. Conclusions:
    ESP32-S3 for stages 0/1, nRF52840-class for the Oura-size stage 2; OVM7692 is
    the only buyable digital camera under 3.5 mm; haptic Morse is the one output that
    works at every size; air puff is a stage-1 experiment only.
    Protocol: BLE GATT service with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
    [mcring_stage1.scad, stage0-devkit.csv, stage1-ring.csv, stage2-oura-size.csv]
2026-10-24 WIP: stage-1 electrical netlist model (design pass in progress)
    Partial output of the running design pass: self-contained Python netlist
    model and the mcring v1 board description with KiCad netlist, BOM and ERC
    exports. Reviewed/fixed versions follow when the pass completes.
    Claude-Session: https://claude.ai/code/session_01EMyy4ndHTaXnuFJg5qufu6
    [mcring_v1_bom.csv]
2026-10-24 WIP: PCB floorplan, schematic sheets, build guide (design pass in progress)
    Second snapshot of the running design pass: stage-1 PCB floorplan and
    stack-up (board_params.json as the source of truth for the enclosure),
    net-label schematic sheets, electrical README, build & integration guide,
    and the IO19/IO20 USB pin conflict resolved in config.h and pinmap.md.
    Reviewed/fixed versions follow when the pass completes.
    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
    [config.h, floorplan.py, mcring_v1.py, netlist_model.py, schematic_svg.py, svgkit.py]
2026-10-24 WIP: design pass snapshot (wiring diagram / CAD in progress)
    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
    [mcring_stage1.scad, mcring_stage1_assembly.step, mcring_stage1_lid.stl, mcring_stage1_shell.stl]
2026-10-24 WIP: enclosure CAD + voice-pivot snapshot (passes in progress)
    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
2026-10-24 Stage-1 hardware design pass: reviewed PCB floorplan, electrical netlist, enclosure CAD, build guide
    Lean design pass (CAD only where needed: the printable stage-1 enclosure).
    PCB (hardware/pcb): 26.5 x 18.0 x 0.6 mm 2-layer floorplan around the
    ESP32-S3-MINI-1U with placement/keepout checks, stack-up, board_params.json as
    the single source of truth for the enclosure, and the stage-0 bench wiring
    diagram for the XIAO ESP32S3 Sense.
    Electrical (hardware/electrical): self-contained netlist model with KiCad
    netlist export, BOM, per-net listing, ERC (clean); five net-label schematic
    sheets. Resolves the IO19/IO20 USB conflict (CAM_PWR -> IO21, RGB -> IO43,
    LED power gate -> IO33) in config.h a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
    [mcring_stage1_assembly.step, mcring_stage1_key.stl, mcring_stage1_lid.stl, mcring_stage1_shell.stl, mcring_v1_bom.csv, stage0-devkit.csv, stage1-ring.csv]
2026-10-24 firmware: gate the WS2812 supply rail (PIN_RGB_PWR) around LED use and before deep sleep
    Follow-up from the hardware review: the stage-1 board switches the LED rail
    with a TPS22916 on IO33 but nothing drove it. feedback.cpp now raises the
    rail before any WS2812 write and drops it when the LED goes dark; the deep
    sleep path stops all outputs and forces the rail low.
    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
2026-10-24 Voice-first pivot + optional on-ring speaker: backend STT/TTS/chat, firmware audio streaming and events, app/CLI push-to-talk, speaker on the stage-1 board and enclosure, projection v2 note
    Product pivot: Morse output is dropped as the primary interface in favour of
    voice. Topology: ring <-> phone (BLE), phone <-> the user's own headphones,
    phone <-> backend <-> Claude. The ring contributes the trigger, camera and an
    optional mic; an optional on-ring speaker exists for the stage-1 ring only.
    Morse remains an off-by-default "silent pattern" capability with its code
    and tests intact.
    Protocol: EVENTS (0x0007: button down/up with hold time, double tap, touch,
    capture/recording/audio events, lo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
    [mcring_stage1_assembly.step, mcring_stage1_lid.stl, mcring_stage1_shell.stl, mcring_v1_bom.csv, stage0-devkit.csv, stage1-ring.csv, stage2-oura-size.csv]
2026-10-24 WIP: fundamentals chapters / no-solder research (passes in progress)
    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
2026-10-24 docs: fundamentals course (9 chapters, ~380 verified links) + repo corrections it surfaced
    docs/fundamentals/01-09: electronics basics, batteries and power budgets,
    microcontrollers and firmware, Bluetooth Low Energy, cameras and images,
    audio and haptics, PCB design and assembly, mechanical CAD and 3D printing,
    software stack. Each chapter: why it matters in mcring (tied to repo files
    and numbers), the concepts worked on the project's own values, a resource
    table of videos/courses/interactive tools/articles with time estimates, and
    check-yourself exercises with answers. Every link was confirmed by web
    search and recorded in docs/fundamentals/_links_*.json; a review pass
    re-checked links, re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
    [drv2605.cpp]
2026-10-24 WIP: no-solder research and solderless stage-0 files (pass in progress)
    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
2026-10-25 WIP: no-solder path implementation (unreviewed; review re-running)
    Solderless stage-0 kit (pre-soldered XIAO, expansion base, STEMMA QT/Grove
    chain, LIS3DH driver variant) and stage-1 design-for-assembly changes
    (plug-in connectors, PCBA ordering), as produced by the implementation
    step. The review step failed on a usage limit and is being re-run.
    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
    [mcring_stage1_assembly.step, mcring_stage1_key.stl, mcring_stage1_lid.stl, mcring_stage1_shell.stl, mcring_v1_bom.csv, mcring_v1_bom_jlc.csv, stage0-devkit-solderless.csv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]
2026-10-25 No-solder path: solderless stage-0 kit, LIS3DH driver, stage-1 plug-in connectors and assembled-board ordering (reviewed)
    Stage 0: hardware/bom/stage0-devkit-solderless.csv (pre-soldered XIAO
    ESP32S3 Sense in Seeed's Expansion Board Base, Grove Haptic Motor, LIS3DH
    on STEMMA QT, Grove-to-QT cable, JST-PH LiPo; about $56-72, zero joints
    except the optional speaker amp's header), solderless wiring diagram,
    build-guide section 1.12, and new PlatformIO envs xiao_esp32s3_sense_base
    and _tapwake. Firmware detects a LIS3DH (WHO_AM_I 0x33) at runtime beside
    the LIS2DW12 and uses its click engine for double tap; the default no-solder
    build does not arm tap wake on an unconnected interrupt pin.
    Stage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
    [mcring_stage1_assembly.step, mcring_v1_bom.csv, stage0-devkit-solderless.csv, stage1-ring.csv]
2026-10-26 docs: interactive 3D ring anatomy viewer built from the CAD model
    docs/ring-anatomy.html renders the stage-1 shell, lid, switch key and all
    fit-check placeholders (19 parts) with three.js: orbit, view presets,
    solid/see-through/hidden shell, explode slider, section cut, and a parts
    ledger with part numbers, modelled sizes and each part's job.
    tools/ring-viz/export_mesh.py rebuilds it from hardware/cad/mcring_stage1.py.
    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
